RoboSAX/cad_spielfeld/2018/Spielfeld/Bauanleitungen/Elektronik/bilder/crimp2.jpg

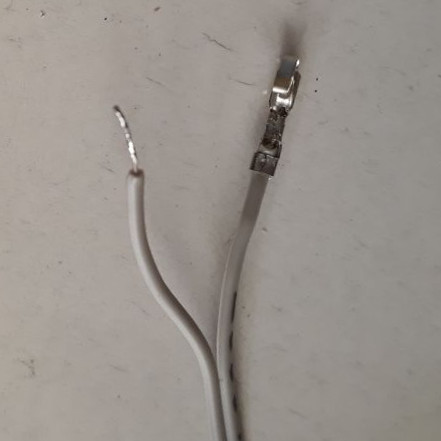
2018/Spielfeld/Bauanleitungen/Elektronik/bilder/crimp2.jpg
