RoboSAX/cad_spielfeld/2019/Allgemeines/Spielfeld_Uebersicht.pdf

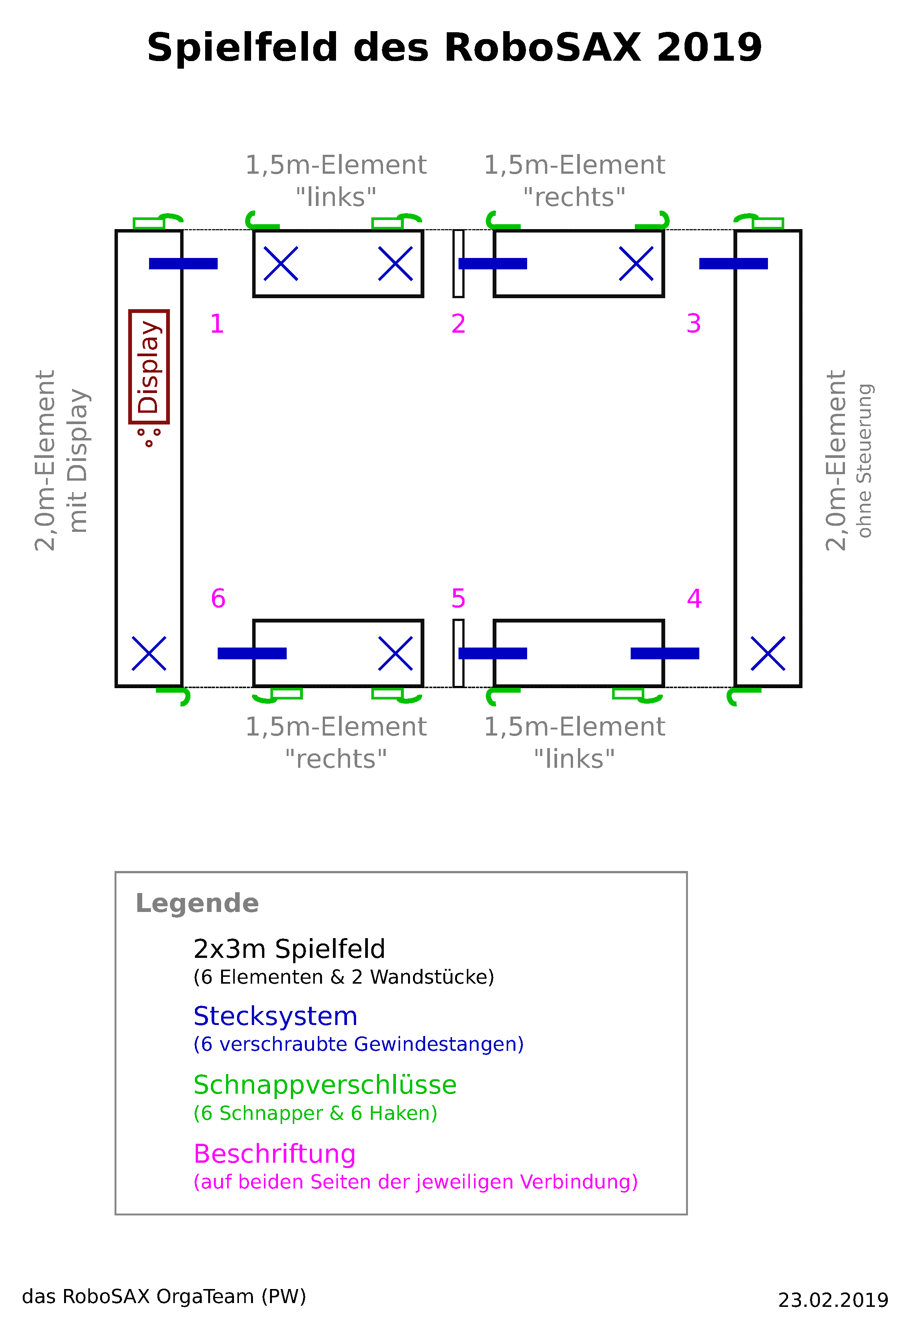
[picture p17: page 1]
