RoboSAX/cad_spielfeld/2018/Spielfeld/Bestellungen_unvollstaendig/data/Reichelt.pdf

## Bestellung für den Spielfeldbau

~ Reichelt ~

RoboSAX 2018 | Seite 1 von 1 | 24.05.2018
Bezeichnung | Artikelnr. | Menge Preis | Summe
| | 2 | 1,75 € | 3,50 €
| | 1 | 3,70 € | 3,70 €
| | 1 | 4,40 € | 4,40 €
Stecker (SpeakOn, 2-polig) | | 11 | 3,40 € | 37,40 €
| | 12 | 2,99 € | 35,88 €
Netzteil (5V, 6A) | 1 19,60 € | 19,60 €
Zwillingslitze (2-adrig, 1,5mm², 10m) | | 1 | 5,55 € | 5,55 €
Kabel (3-adrig, 1,5mm², 5m) | | 1 | 5,55 € | 5,55 €
Stecker (Tamiya, mit Kabel) | | 12 | 1,10 € | 13,20 €
Buchse (Tamiya, mit Kabel) | | 12 | 1,20 € | 14,40 €
Flachbandkabel (10-polig) | | 1 | 4,99 € | 4,99 €
Stecker (DSUB9, für Flachbandkabel) | | 12 | 0,57 € | 6,84 €
Buchse (DSUB9, für Flachbandkabel) | | 12 | 0,57 € | 6,84 €
Stecker (Wanne, 10-polig) | 24 | Auf Platine
Buchse (Pfosten, 10-polig) | | 12 | 0,10 € | 1,20 €

Weitere zum Verbinden der Platinen
Stecker (Crimp, 2-polig) | 26 | Auf Platine
Stecker (Crimp, 3-polig) | 24 | Auf Platine
Buchse (Crimp, 2-polig) | | 26 | 0,01 € | 0,26 €
Buchse (Crimp, 3-polig) | | 24 | 0,03 € | 0,72 €
Stifte (20x Crimp) | | 6 | 0,30 € | 1,80 €
Taster (rot, 24V) | | 26 | 0,47 € | 12,22 €
IR-LED (5mm, 22°) | | 24 | 0,26 € | 6,24 €
| | 1 | 0,25 € | 0,25 €
| | 1 | 0,32 € | 0,32 €
| | 1 | 0,26 € | 0,26 €
| | 1 | 0,46 € | 0,46 €
| | 1 | 0,50 € | 0,50 €
Versandkosten | - | 1 | 5,60 € | 5,60 €

Summe 191,68 €
Nicht enthalten sind die einzelnen Platinen und deren Bauteile.
Blechschrauben (100x, 16mm, d 2,9mm) | SBL 2916-100 (https://www.reichelt.de/Blechschrauben/SBL-2916-100/3/index.html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)
Holzschrauben (200x, 40mm, d 4,0 mm) | R2FV 4,0X40-200 (https://www.reichelt.de/Flach-Senkkopf-Kreuzschlitz-DIN9200-9210-/R2FV-4-0X40-200/3/index.html?ACTION=3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)
Holzschrauben (200x, 50mm, d 4,0 mm) | R2FV 4,0X50-200 (https://www.reichelt.de/Flach-Senkkopf-Kreuzschlitz-DIN9200-9210-/R2FV-4-0X50-200/3/index.html?ACTION=3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)
| NEUTRIK NL-2FX (https://www.reichelt.de/Lautsprecher-Steckverbinder/NEUTRIK-NL-2FX/3/index.html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)
Buchse (SpeakOn, 4-polig, Einbau, groß) | NEUTRIK NL-4MPR (https://www.reichelt.de/Lautsprecher-Steckverbinder/NEUTRIK-NL-4MPR/3/index.html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)
| MW GS60A05 (https://www.reichelt.de/Netzteile-Festspannung/MW-GS60A05/3/index.html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)
| LA 215-10 (https://www.reichelt.de/Lautsprecherkabel/LA-215-10/3/index.html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)
| H05VV F3G1,5 5M (https://www.reichelt.de/Kunststoff-Schlauchleitung/H05VV-F3G1-5-5M/3/index.html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)
| TAM-ST (https://www.reichelt.de/Zubehoer-fuer-Akkupacks/TAM-ST/3/index.html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)
| TAM-BU (https://www.reichelt.de/Zubehoer-fuer-Akkupacks/TAM-BU/3/index.html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)
| AWG 28-10G 10M (https://www.reichelt.de/Flachbandkabel/AWG-28-10G-10M/3/index.html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)
| D-SUB ST 09FB (https://www.reichelt.de/SUB-D-Flachbandverbinder/D-SUB-ST-09FB/3/index.html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)
| D-SUB BU 09FB (https://www.reichelt.de/SUB-D-Flachbandverbinder/D-SUB-BU-09FB/3/index.html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)
| WSL 10G (https://www.reichelt.de/Pfosten-Wannenstecker/WSL-10G/3/index.html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)
| PFL 10 (https://www.reichelt.de/Pfosten-Wannenstecker/PFL-10/3/index.html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)
| PSS 254/2G (https://www.reichelt.de/Platinen-Steckverbinder/PSS-254-2G/3/index.html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)
| PSS 254/3G (https://www.reichelt.de/Platinen-Steckverbinder/PSS-254-3G/3/index.html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)
| PSK 254/2W (https://www.reichelt.de/Platinen-Steckverbinder/PSK-254-2W/3/index.html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)
| PSK 254/3W (https://www.reichelt.de/Platinen-Steckverbinder/PSK-254-3W/3/index.html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)
| PSK-KONTAKTE (https://www.reichelt.de/Platinen-Steckverbinder/PSK-KONTAKTE/3/index.html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)
| T 113A RT (https://www.reichelt.de/Drucktaster-Druckschalter/T-113A-RT/3/index.html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)
| CQY 99 (https://www.reichelt.de/Fotodioden-etc-/CQY-99/3/index.html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)

Schrumpfschläuche
(verschiedene Größen)
| SDH 1,6 SW (https://www.reichelt.de/Schrumpfschlauch-Abschnitte/SDH-1-6-SW/3/index.html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)
| SDH 1,6 RT (https://www.reichelt.de/Schrumpfschlauch-Abschnitte/SDH-1-6-SW/3/index.html?ACTION=3;ARTICLE=17393)
| SDH 3,2 SW (https://www.reichelt.de/?ACTION=3;ARTICLE=17406)
| SDH 6,4 SW (https://www.reichelt.de/Schrumpfschlauch-Abschnitte/SDH-6-4-SW/3/index.html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)
| SDH 6,4 RT (https://www.reichelt.de/?ACTION=3;ARTICLE=17413)
