RoboSAX/cad_spielfeld/2014/Beschreibung/Bilder/Spielfeld.jpg

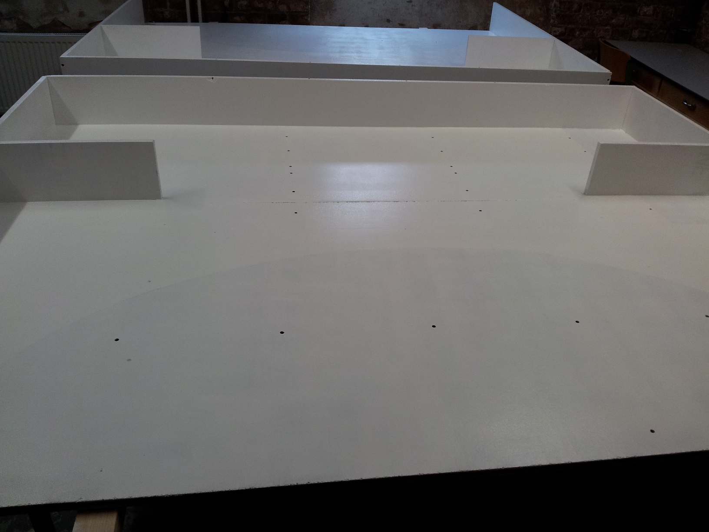
2014/Beschreibung/Bilder/Spielfeld.jpg
