RoboSAX/cad_spielfeld/2014/Beschreibung/Bilder/Spielfeld_Neu.png

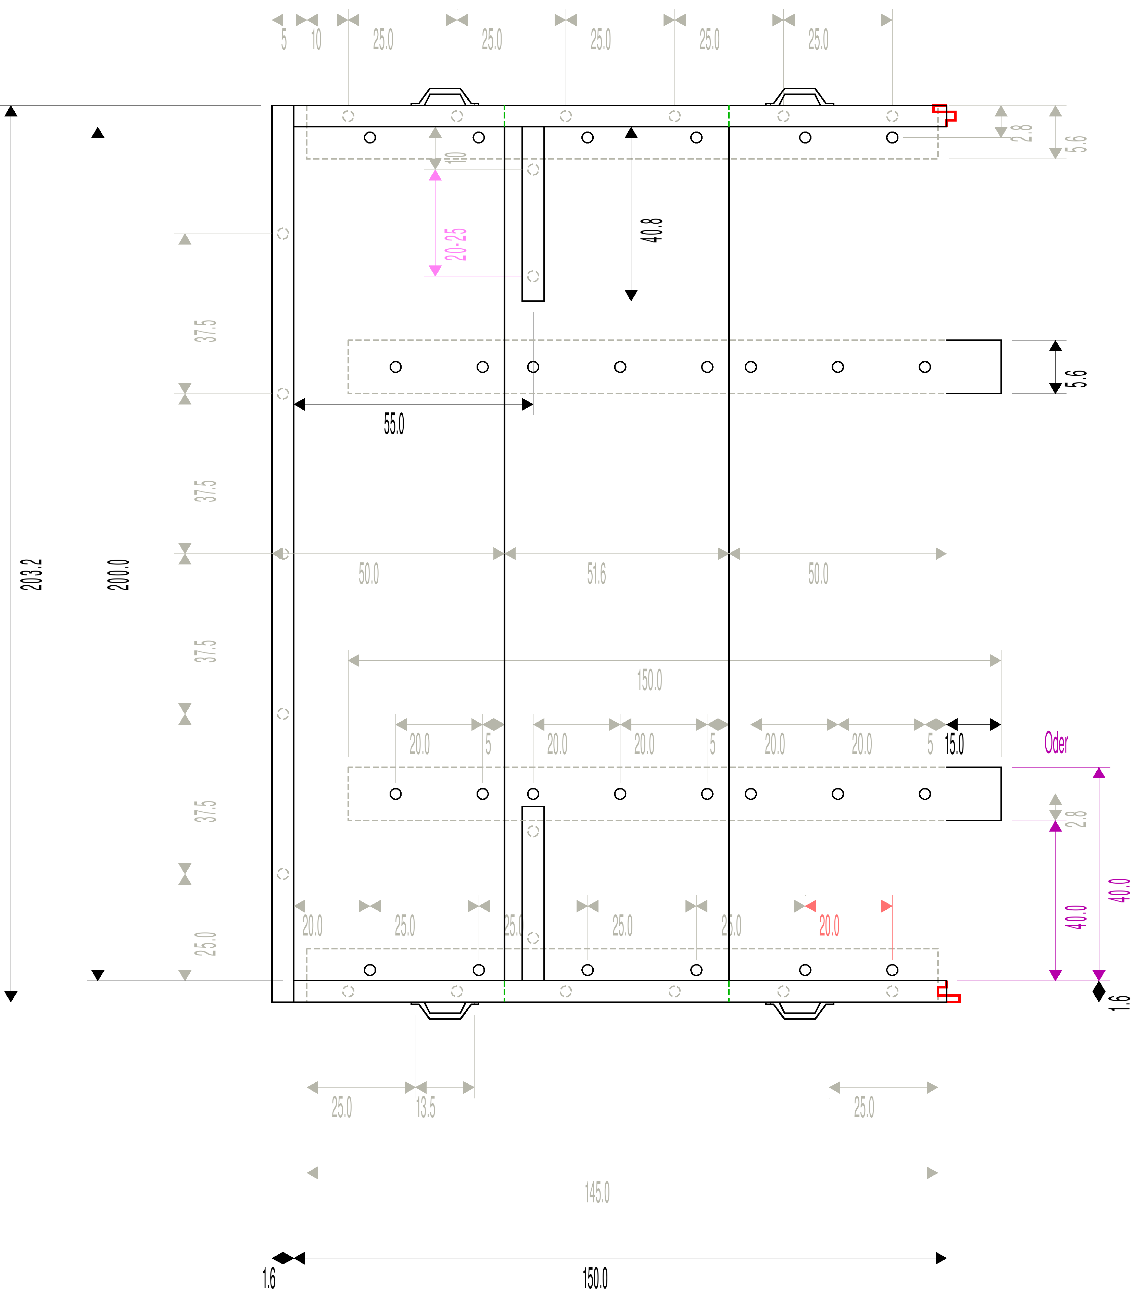
2014/Beschreibung/Bilder/Spielfeld_Neu.png
