RoboSAX/cad_spielfeld/2019/Programmieranschluss/Bilder/netzwerkanschluss_seite.jpg

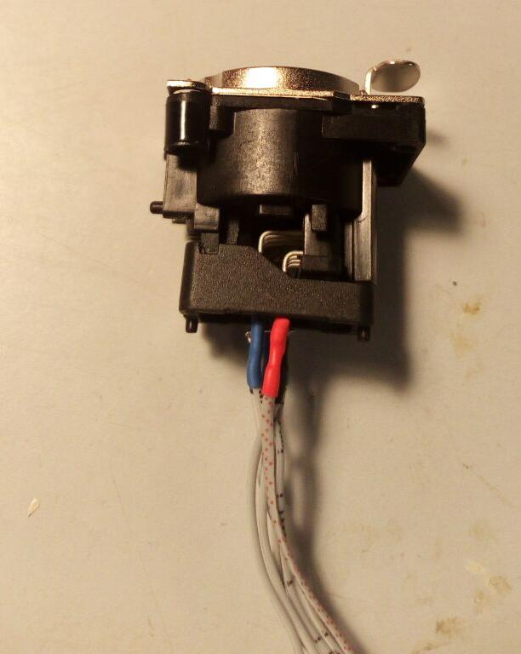
2019/Programmieranschluss/Bilder/netzwerkanschluss_seite.jpg
