RoboSAX/cad_spielfeld/2019/Programmieranschluss/Bilder/netzwerkanschluss_unten.jpg

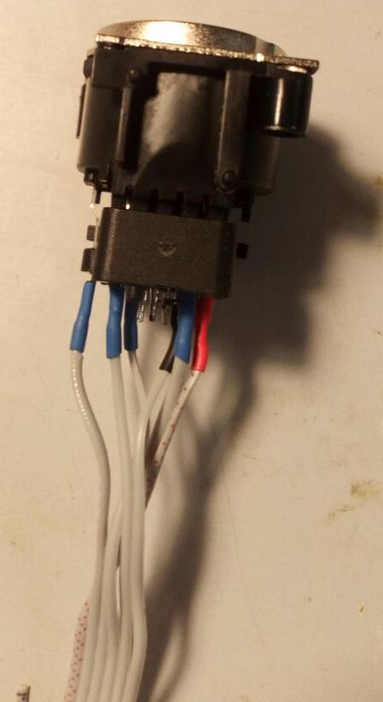
2019/Programmieranschluss/Bilder/netzwerkanschluss_unten.jpg
