RoboSAX/cad_spielfeld/2019/Programmieranschluss/Zeichnungen/data/export/anschluss_programmer.stp

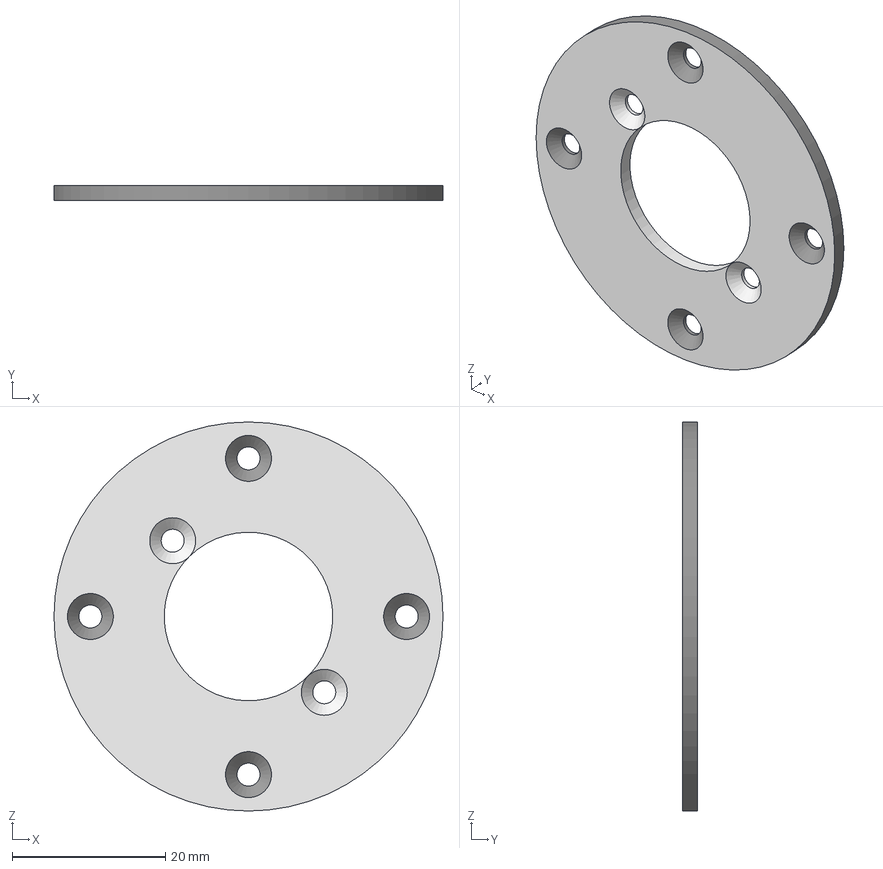
[picture p22: CAD file, 2019-02-23]
2019/Programmieranschluss/Zeichnungen/data/export/anschluss_programmer.stp
50.8 x 2.00 x 50.8 mm
