RoboSAX/cad_spielfeld/2020/Tasteranschluss/Zeichnungen/data/export/anschluss_taster.stp

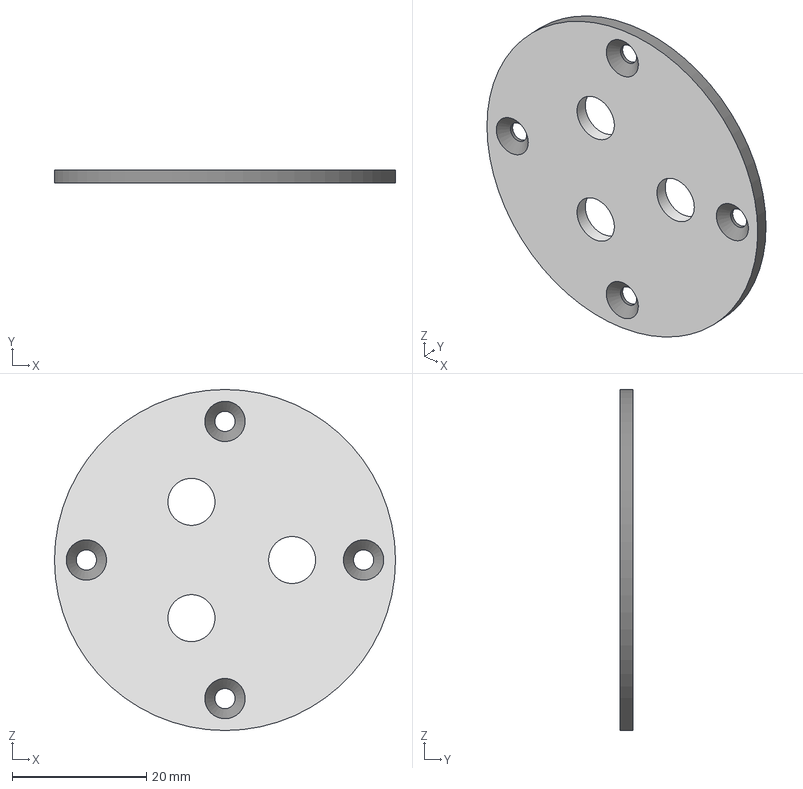
[picture p23: CAD file, 2019-11-26]
2020/Tasteranschluss/Zeichnungen/data/export/anschluss_taster.stp
50.8 x 2.00 x 50.8 mm
