RoboSAX/cad_spielfeld/(list of files, cad)

Other CAD files:
2018/Teamprobe/Zeichnung/Anschluss_Daten.dwg
2018/Teamprobe/Zeichnung/Licht_Teamprobe.dwg
2018/Spielfeld/Zeichnungen/AutoCADD/Steckwand.idw
2018/Spielfeld/Zeichnungen/AutoCADD/Steckwand.ipt
2018/Spielfeld/Zeichnungen/AutoCADD/anschluss_daten.iam
2018/Spielfeld/Zeichnungen/AutoCADD/anschluss_daten.idw
2018/Spielfeld/Zeichnungen/AutoCADD/anschluss_daten.ipt
2018/Spielfeld/Zeichnungen/AutoCADD/anschluss_daten_1.idw
2018/Spielfeld/Zeichnungen/AutoCADD/anschluss_daten_1.ipt
2018/Spielfeld/Zeichnungen/AutoCADD/anschluss_daten_1_MIR.ipt
2018/Spielfeld/Zeichnungen/AutoCADD/anschluss_daten_2.ipt
2018/Spielfeld/Zeichnungen/AutoCADD/anschluss_daten_2_MIR.ipt
2018/Spielfeld/Zeichnungen/AutoCADD/anschluss_daten_MIR.iam
2018/Spielfeld/Zeichnungen/AutoCADD/anschluss_strom.ipt
2018/Spielfeld/Zeichnungen/AutoCADD/anschluss_strom_MIR.ipt
2018/Spielfeld/Zeichnungen/AutoCADD/licht_150.iam
2018/Spielfeld/Zeichnungen/AutoCADD/licht_150.idw
2018/Spielfeld/Zeichnungen/AutoCADD/licht_150_MIR.iam
2018/Spielfeld/Zeichnungen/AutoCADD/licht_150_back.idw
2018/Spielfeld/Zeichnungen/AutoCADD/licht_150_back.ipt
2018/Spielfeld/Zeichnungen/AutoCADD/licht_150_back_MIR.ipt
2018/Spielfeld/Zeichnungen/AutoCADD/licht_150_front.idw
2018/Spielfeld/Zeichnungen/AutoCADD/licht_150_front.ipt
2018/Spielfeld/Zeichnungen/AutoCADD/licht_150_front_MIR.ipt
2018/Spielfeld/Zeichnungen/AutoCADD/licht_150_side_left.idw
2018/Spielfeld/Zeichnungen/AutoCADD/licht_150_side_left.ipt
2018/Spielfeld/Zeichnungen/AutoCADD/licht_150_side_left_MIR.ipt
2018/Spielfeld/Zeichnungen/AutoCADD/licht_150_side_middle.idw
2018/Spielfeld/Zeichnungen/AutoCADD/licht_150_side_middle.ipt
2018/Spielfeld/Zeichnungen/AutoCADD/licht_150_side_middle_MIR.ipt
2018/Spielfeld/Zeichnungen/AutoCADD/licht_150_side_right.idw
2018/Spielfeld/Zeichnungen/AutoCADD/licht_150_side_right.ipt
2018/Spielfeld/Zeichnungen/AutoCADD/licht_150_side_right_MIR.ipt
2018/Spielfeld/Zeichnungen/AutoCADD/licht_150_support_left.idw
2018/Spielfeld/Zeichnungen/AutoCADD/licht_150_support_left.ipt
2018/Spielfeld/Zeichnungen/AutoCADD/licht_150_support_left_MIR.ipt
2018/Spielfeld/Zeichnungen/AutoCADD/licht_150_support_right.idw
2018/Spielfeld/Zeichnungen/AutoCADD/licht_150_support_right.ipt
2018/Spielfeld/Zeichnungen/AutoCADD/licht_150_support_right_MIR.ipt
2018/Spielfeld/Zeichnungen/AutoCADD/licht_150_top.idw
2018/Spielfeld/Zeichnungen/AutoCADD/licht_150_top.ipt
2018/Spielfeld/Zeichnungen/AutoCADD/licht_150_top_MIR.ipt
2018/Spielfeld/Zeichnungen/AutoCADD/licht_200.iam
2018/Spielfeld/Zeichnungen/AutoCADD/licht_200.idw
2018/Spielfeld/Zeichnungen/AutoCADD/licht_200_back.idw
2018/Spielfeld/Zeichnungen/AutoCADD/licht_200_back.ipt
2018/Spielfeld/Zeichnungen/AutoCADD/licht_200_front.idw
2018/Spielfeld/Zeichnungen/AutoCADD/licht_200_front.ipt
2018/Spielfeld/Zeichnungen/AutoCADD/licht_200_side_left.idw
2018/Spielfeld/Zeichnungen/AutoCADD/licht_200_side_left.ipt
2018/Spielfeld/Zeichnungen/AutoCADD/licht_200_side_middle.idw
2018/Spielfeld/Zeichnungen/AutoCADD/licht_200_side_middle.ipt
2018/Spielfeld/Zeichnungen/AutoCADD/licht_200_side_right.idw
2018/Spielfeld/Zeichnungen/AutoCADD/licht_200_side_right.ipt
2018/Spielfeld/Zeichnungen/AutoCADD/licht_200_support.idw
2018/Spielfeld/Zeichnungen/AutoCADD/licht_200_support.ipt
2018/Spielfeld/Zeichnungen/AutoCADD/licht_200_top_teil_a.idw
2018/Spielfeld/Zeichnungen/AutoCADD/licht_200_top_teil_a.ipt
2018/Spielfeld/Zeichnungen/AutoCADD/licht_200_top_teil_b.idw
2018/Spielfeld/Zeichnungen/AutoCADD/licht_200_top_teil_b.ipt
2018/Spielfeld/Zeichnungen/AutoCADD/licht_led_blau.ipt
2018/Spielfeld/Zeichnungen/AutoCADD/licht_led_blau_MIR.ipt
2018/Spielfeld/Zeichnungen/AutoCADD/licht_led_gelb.ipt
2018/Spielfeld/Zeichnungen/AutoCADD/licht_led_gruen.ipt
2018/Spielfeld/Zeichnungen/AutoCADD/licht_taster.ipt
2018/Spielfeld/Zeichnungen/AutoCADD/licht_taster_MIR.ipt
2018/Spielfeld/Zeichnungen/AutoCADD/spielfeld_gesamt.iam
2018/Spielfeld/Zeichnungen/AutoCADD/spielfeld_gesamt.idw
2018/Spielfeld/Zeichnungen/AutoCADD/spielfeld_trennwand.idw
2018/Spielfeld/Zeichnungen/AutoCADD/spielfeld_trennwand.ipt
2018/Teamprobe/Zeichnung/licht_50.iam
2018/Teamprobe/Zeichnung/licht_50_front.ipt
2018/Teamprobe/Zeichnung/licht_50_top.ipt
2018/Teamprobe/Zeichnung/licht_side_simple.ipt
2019/Programmieranschluss/Zeichnungen/data/anschluss_programmer.idw
2019/Programmieranschluss/Zeichnungen/data/anschluss_programmer.ipt
2019/Programmieranschluss/Zeichnungen/data/export/anschluss_programmer.dwg
2020/Tasteranschluss/Zeichnungen/data/anschluss_taster.idw
2020/Tasteranschluss/Zeichnungen/data/anschluss_taster.ipt
2020/Tasteranschluss/Zeichnungen/data/export/anschluss_taster.dwg
