RoboSAX/cad_spielfeld/2018/Spielfeld/Bauanleitungen/Elektronik/data/taster.odt

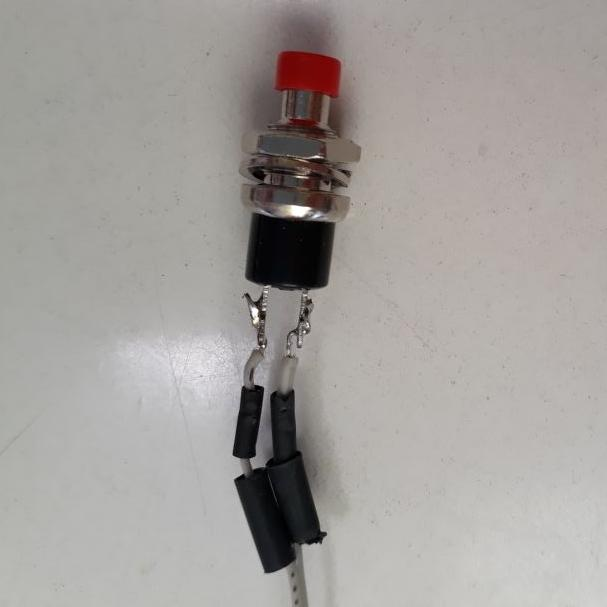
[picture p32: figure]
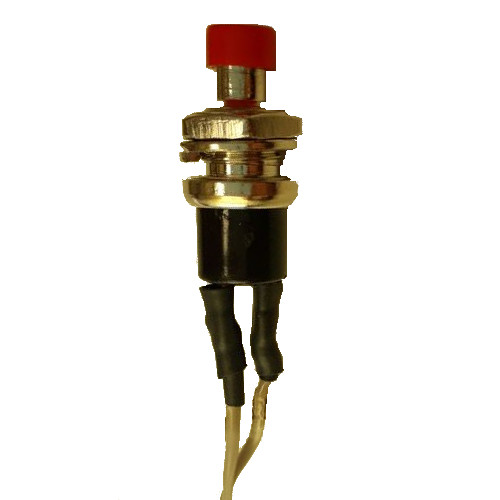
[picture p33: figure]

Als Zuleitung dienen etwa 25cm 2er Flachbandkabel ohne Markierung.

Am beisten je 2 Schrumpfschläuche mit 1,6mm und 3,2 mm Durchmesser nutzen.

Pinbelegung am Kabel und am Crimp-Anschluss ist beliebig.

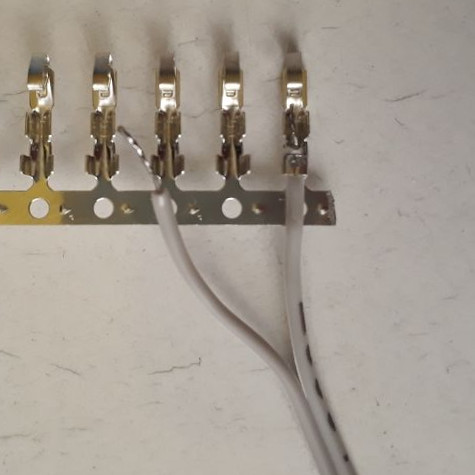
[picture p34: figure]
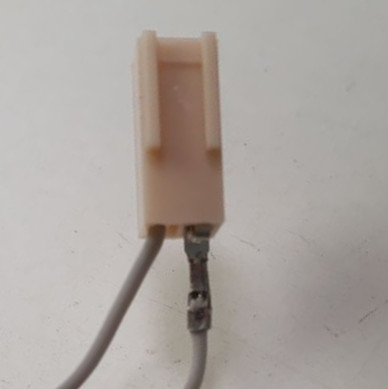
[picture p35: figure]
