RoboSAX/cad_spielfeld/2018/Spielfeld/Bauanleitungen/Elektronik/ir_led.pdf

IR-LED

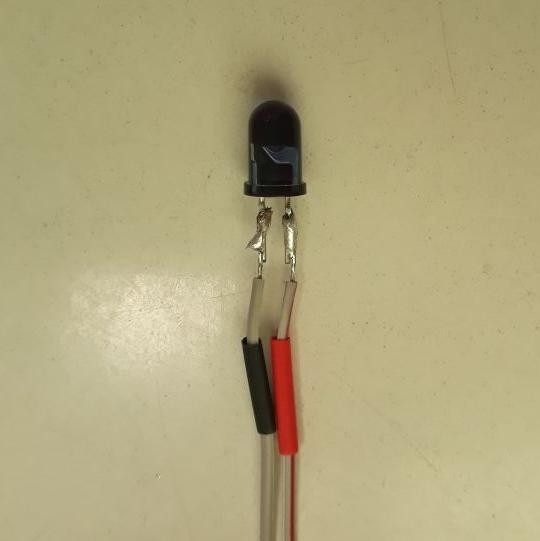
[picture p36: figure]
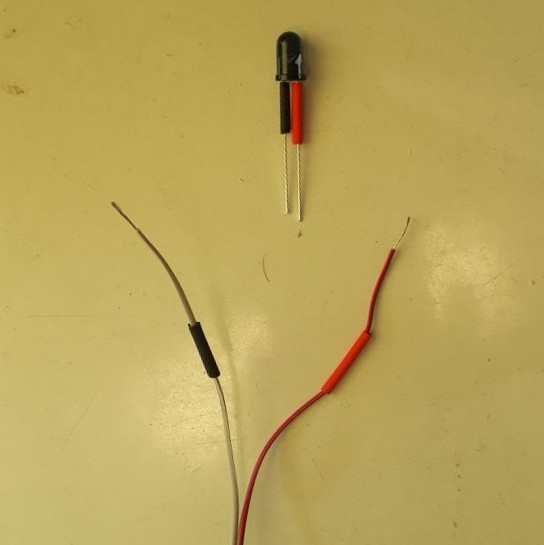
[picture p37: figure]
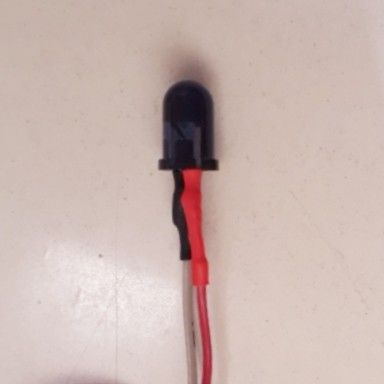
[picture p38: figure]

Als Zuleitung dienen etwa 25cm 2er Flachbandkabel mit einer Markierung für die Anode. Am beisten farbige Schrumpfschläuche mit 1,6mm Durchmesser nutzen.

Led | Kabel | Crimp-Anschluss
Anode | (+; langes Bein) | 1 (rot) | 1 oder 3 (rand)
Kathode (-; kurzes Bein) | 2 (grau) | 2 | (mitte)

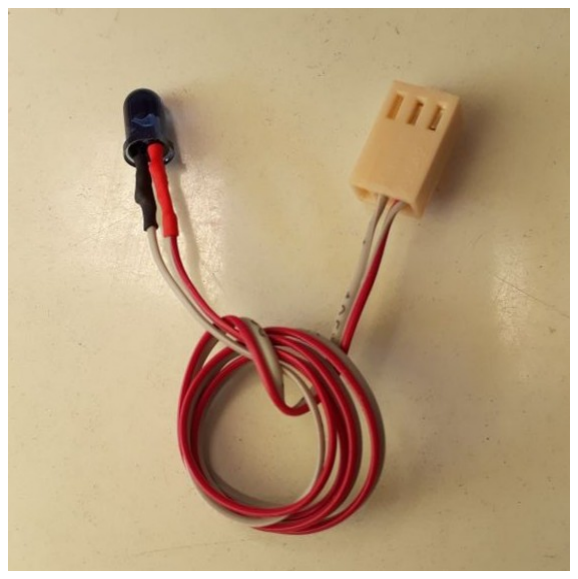
[picture p39: figure]

RoboSAX 2018 | 08.04.18
