RoboSAX/cad_spielfeld/2018/Spielfeld/Bauanleitungen/Elektronik/bilder/speakon_gelötet.jpg

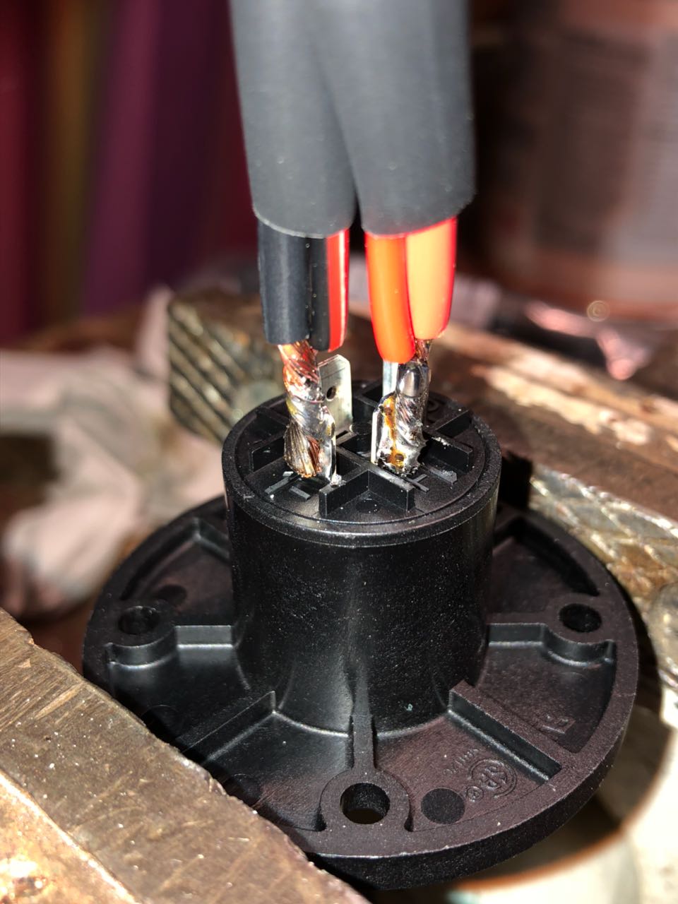
2018/Spielfeld/Bauanleitungen/Elektronik/bilder/speakon_gelötet.jpg
