RoboSAX/cad_spielfeld/2018/Spielfeld/Bauanleitungen/Elektronik/bilder/speakon_geschrumpft.jpg

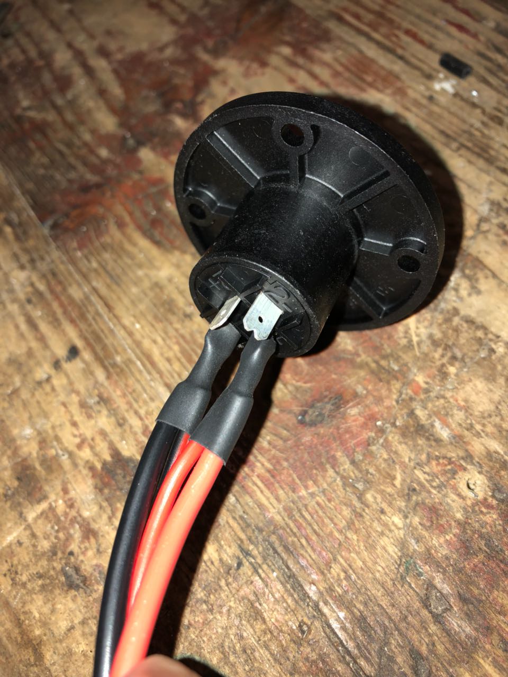
2018/Spielfeld/Bauanleitungen/Elektronik/bilder/speakon_geschrumpft.jpg
