RoboSAX/cad_spielfeld/2018/Spielfeld/Bauanleitungen/Elektronik/bilder/speakon_kabel_2.jpg

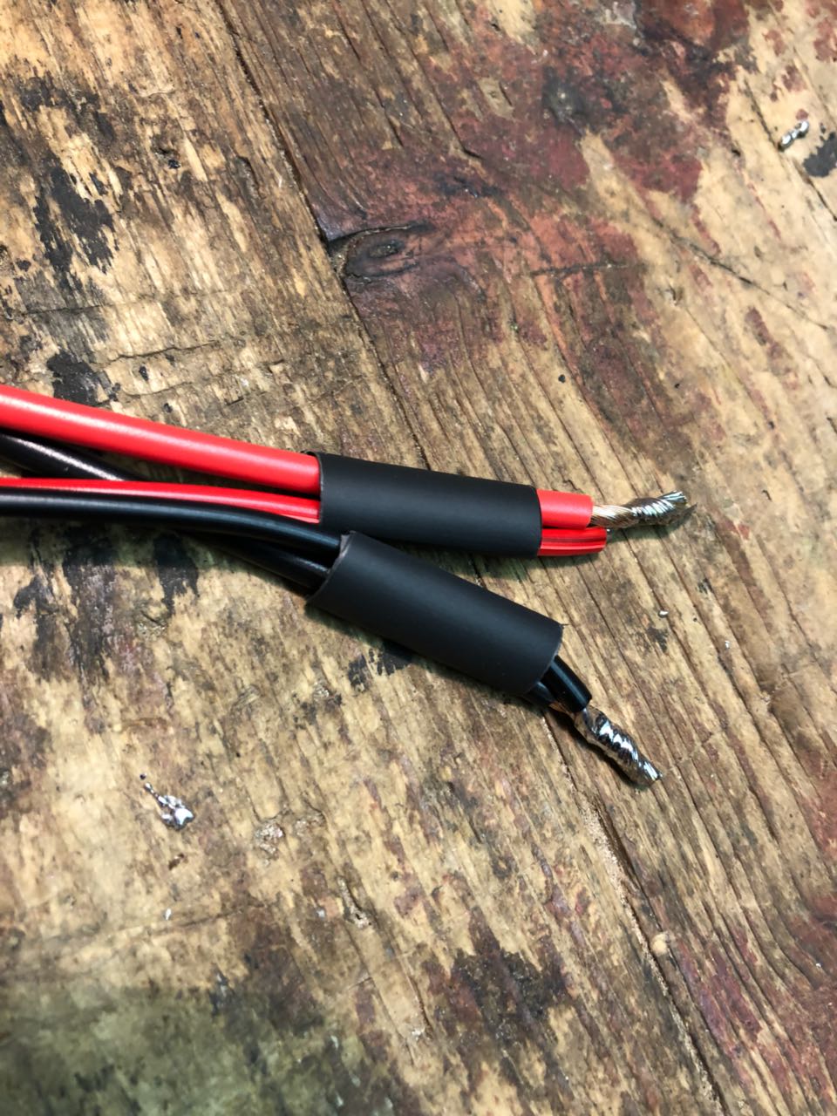
2018/Spielfeld/Bauanleitungen/Elektronik/bilder/speakon_kabel_2.jpg
