RoboSAX/cad_spielfeld/2018/Spielfeld/Bauanleitungen/Elektronik/bilder/speakon_verzinnt.jpg

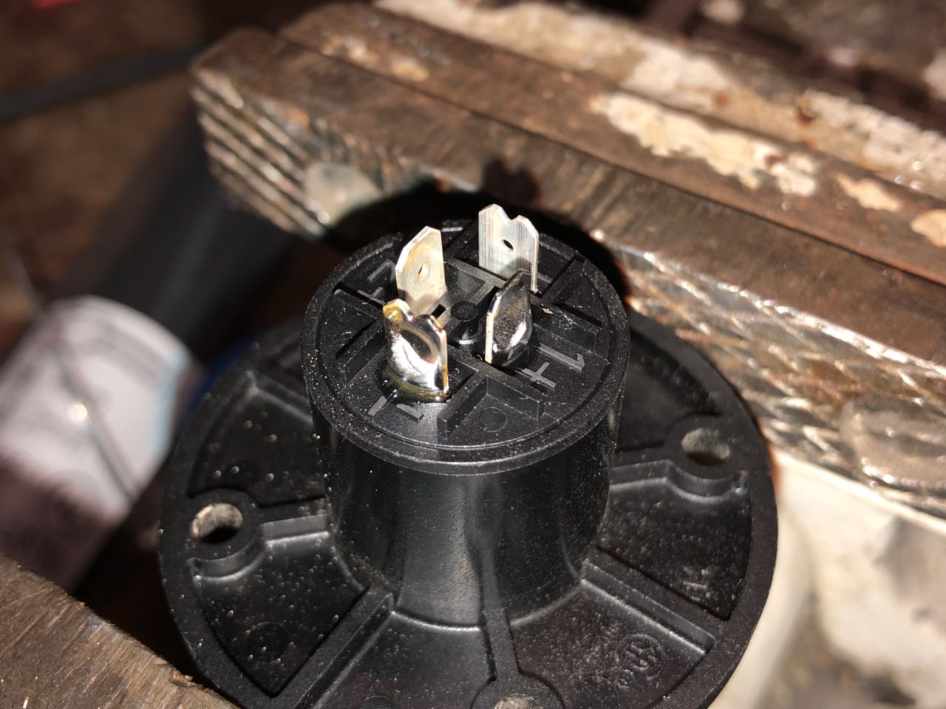
2018/Spielfeld/Bauanleitungen/Elektronik/bilder/speakon_verzinnt.jpg
