RoboSAX/cad_spielfeld/2018/Spielfeld/Bauanleitungen/Hardware/Anschluss_Daten.pdf

# Strke 2mm

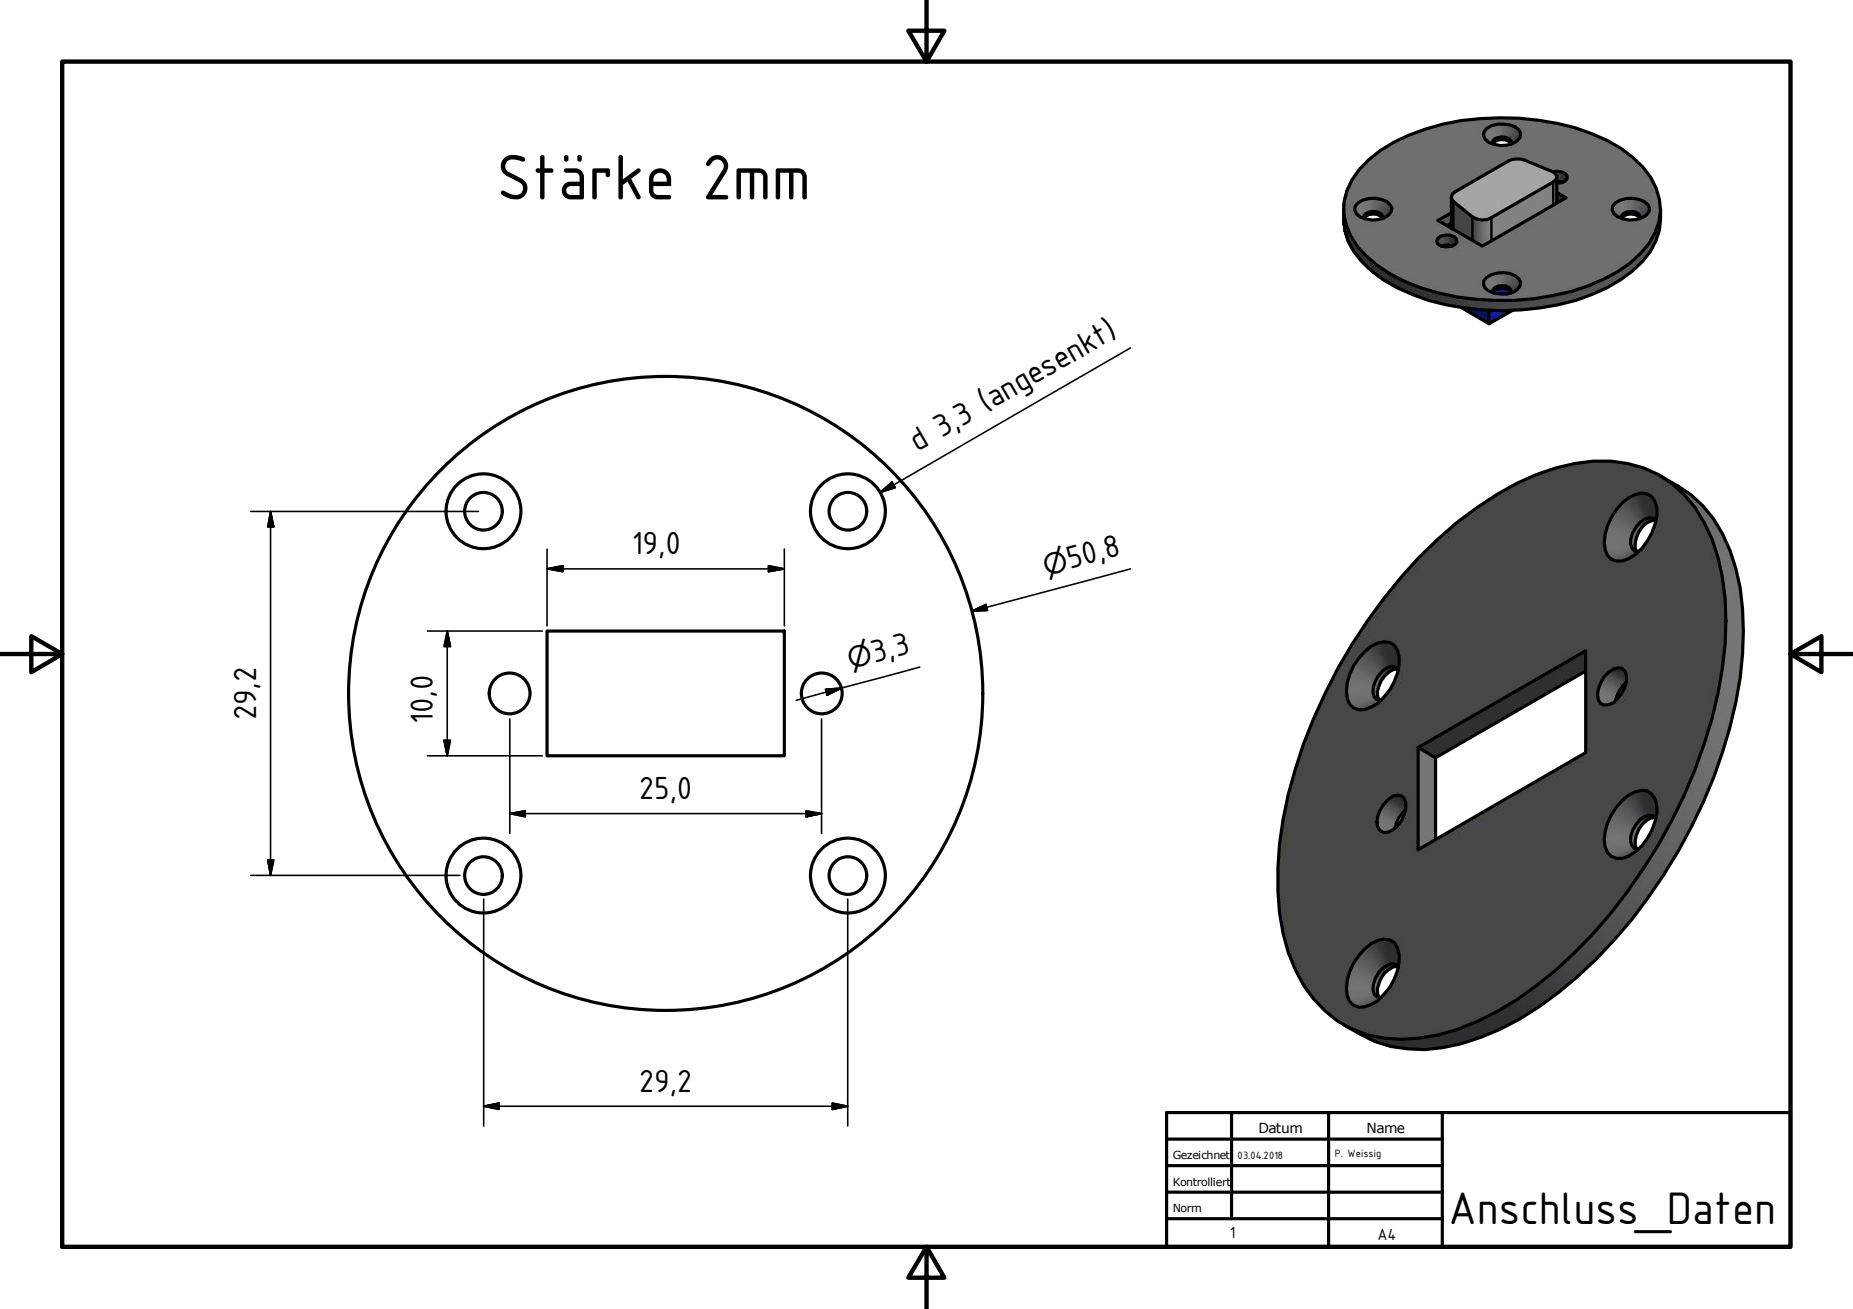
[picture p45: page 1]
d 3,3 (angesenkt)

Datum | Name | Anschluss_Daten

Gezeichnet | 03.04.2018 | P. Weissig

Kontrolliert

Norm
