RoboSAX/cad_spielfeld/2018/Spielfeld/Bauanleitungen/Hardware/Licht_150_links.pdf

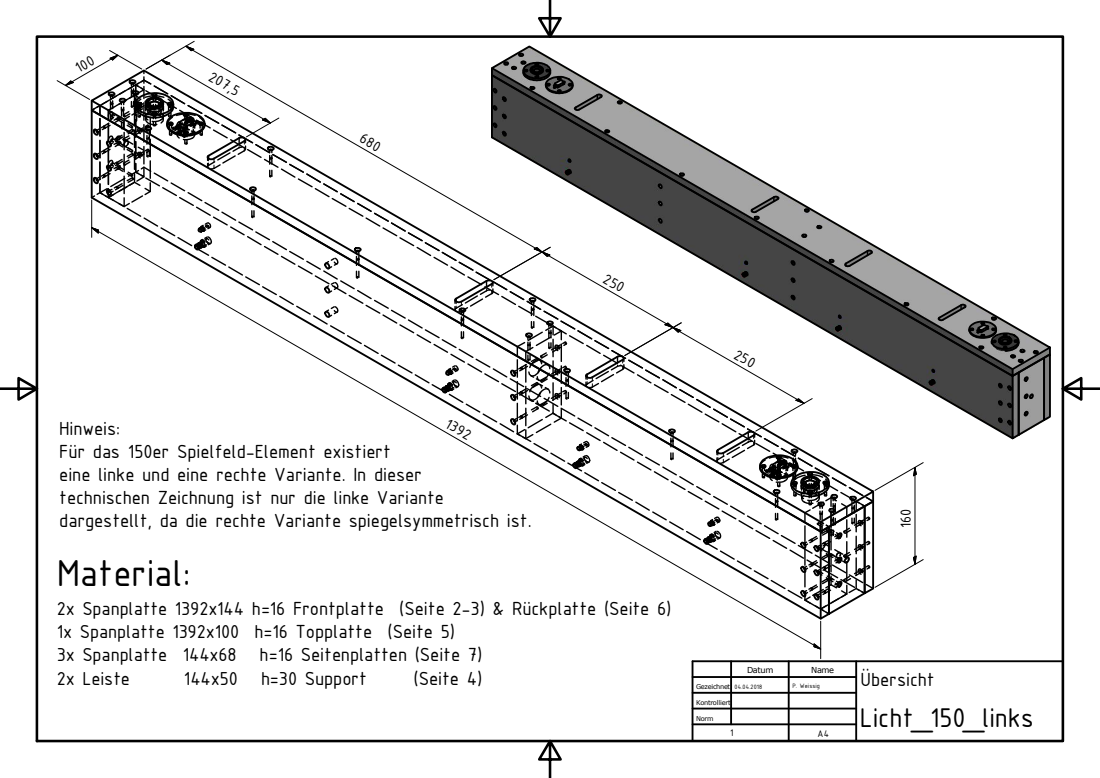
[picture p46: page 1]
3x Spanplatte 144x68; h=16 Seitenplatten (Seite 7); 2x Leiste; h=30 Support; (Seite 4)

Hinweis:
F¯r das 150er Spielfeld-Element existiert
eine linke und eine rechte Variante. In dieser
technischen Zeichnung ist nur die linke Variante
dargestellt, da die rechte Variante spiegelsymmetrisch ist.
Material:

2x Spanplatte 1392x144 h=16 Frontplatte (Seite 2-3) & R¯ckplatte (Seite 6)
1x Spanplatte 1392x100 h=16 Topplatte (Seite 5)

Datum | Name | bersicht Licht_150_links

Gezeichnet | 04.04.2018 | P. Weissig

Kontrolliert

Norm

AF1

# 1x Spanplatte 1392x144 h=16

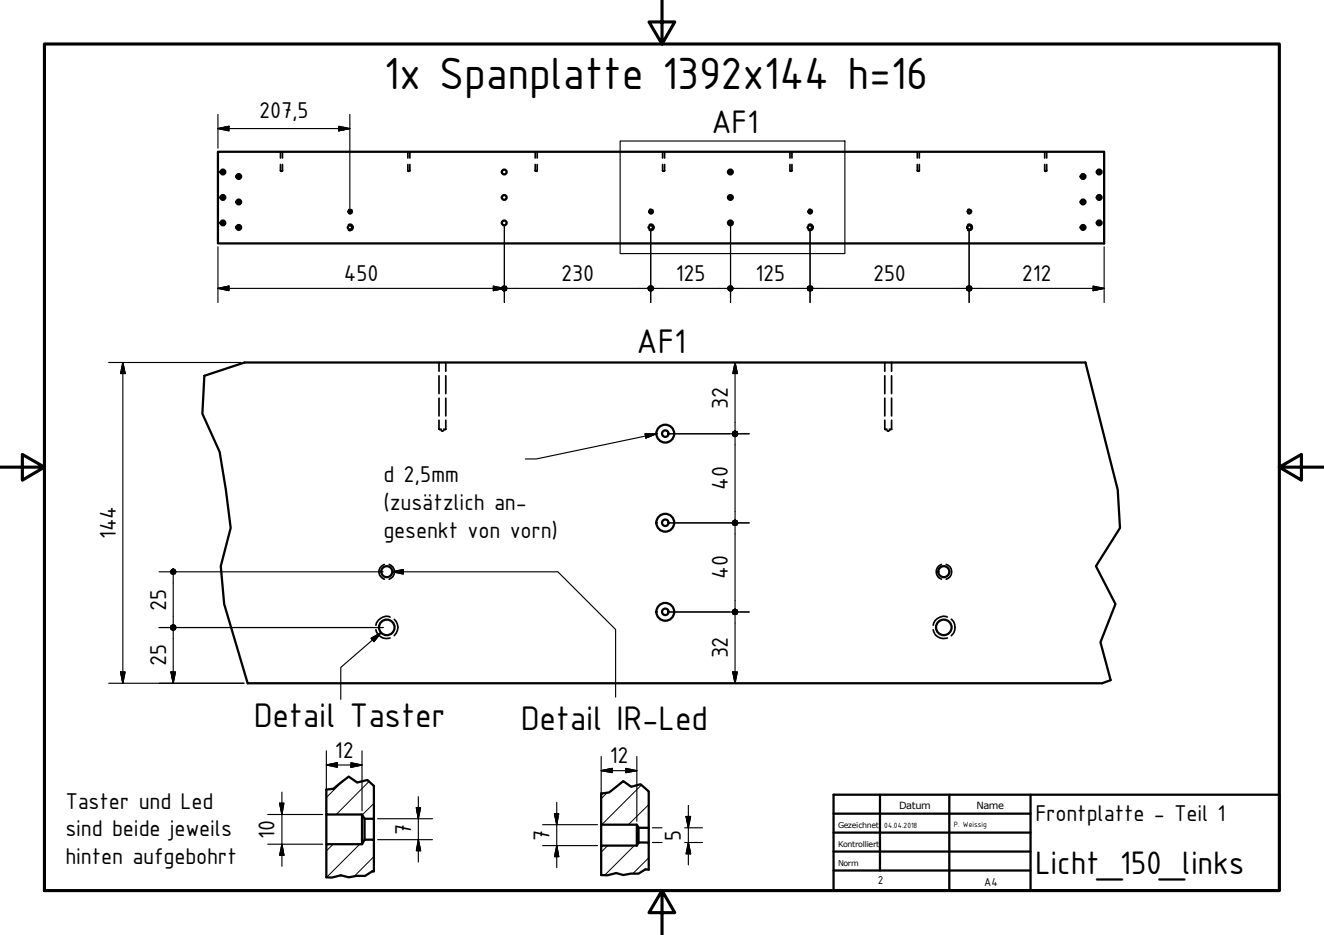
[picture p47: page 2]
Detail Taster; Detail IR-Led

(zustzlich an-
gesenkt von vorn)

Taster und Led
sind beide jeweils
hinten aufgebohrt

Datum | Name | Frontplatte - Teil 1

Gezeichnet | 04.04.2018 | P. Weissig

Kontrolliert

AF2 | AF3

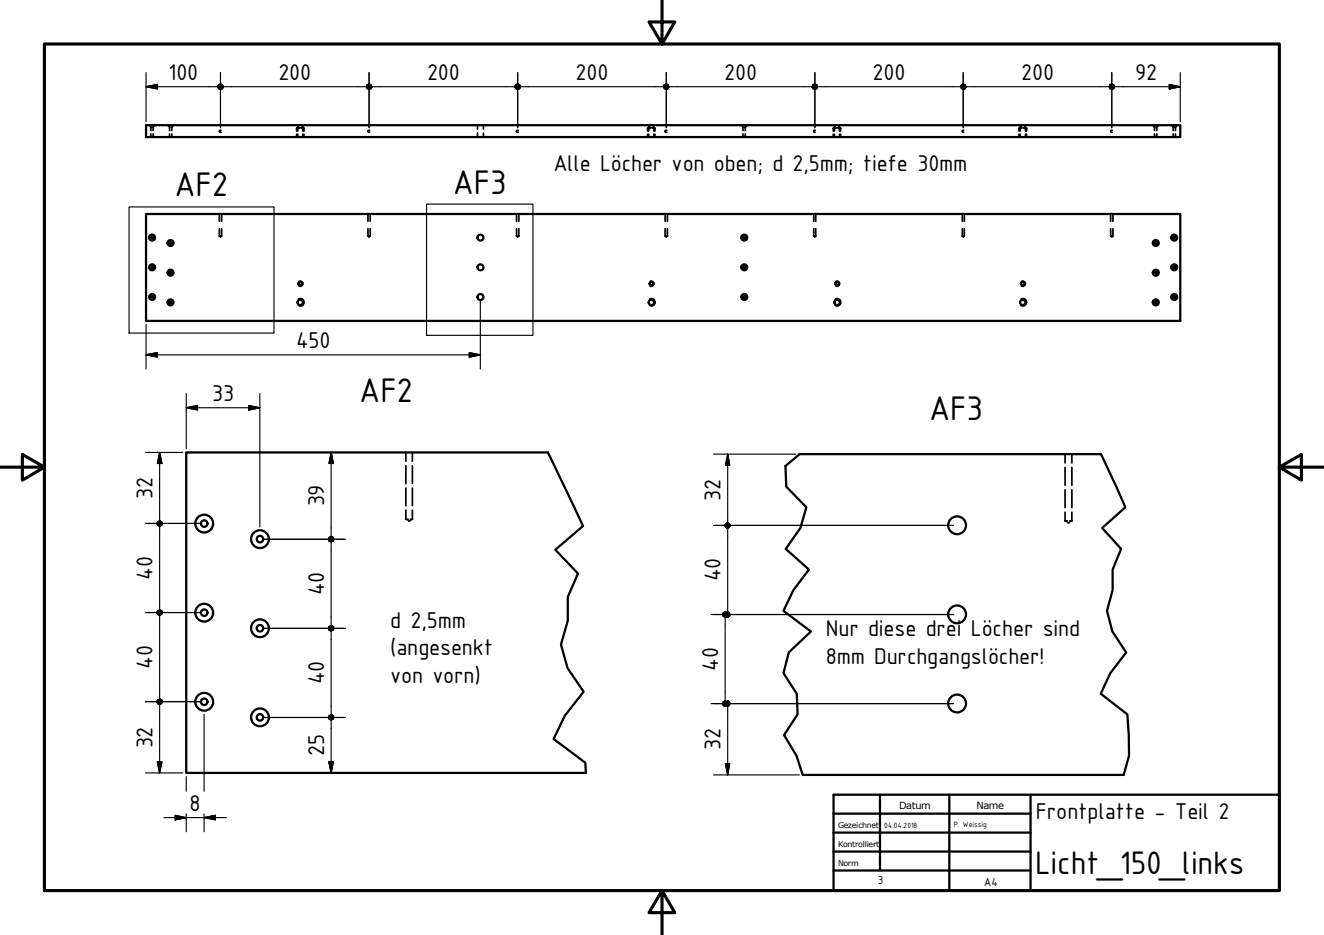
[picture p48: page 3]
d 2,5mm (angesenkt von vorn)

Alle L©cher von oben; d 2,5mm; tiefe 30mm

Nur diese drei L©cher sind
8mm Durchgangsl©cher!

Datum | Name | Frontplatte - Teil 2

Gezeichnet | 04.04.2018 | P. Weissig

Kontrolliert

# 2x Leiste 144x50 h=30

Leiste links | Leiste rechts

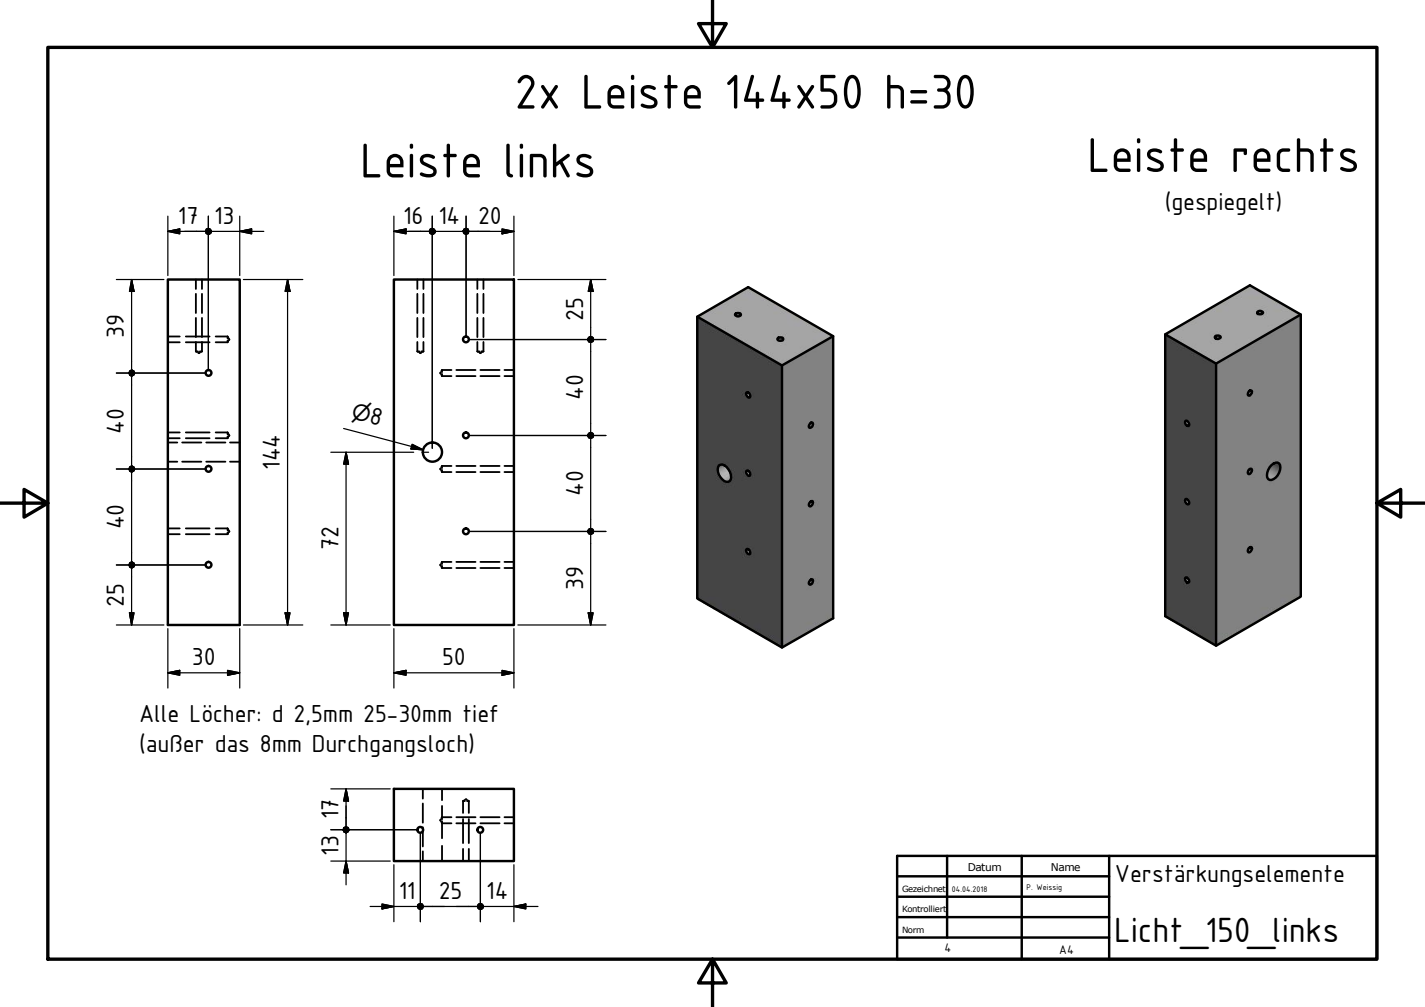
[picture p49: page 4]
(gespiegelt)

Alle L©cher: d 2,5mm 25-30mm tief
(auer das 8mm Durchgangsloch)

Datum | Name | Verstrkungselemente

Gezeichnet | 04.04.2018 | P. Weissig

Kontrolliert

AT1
AT2

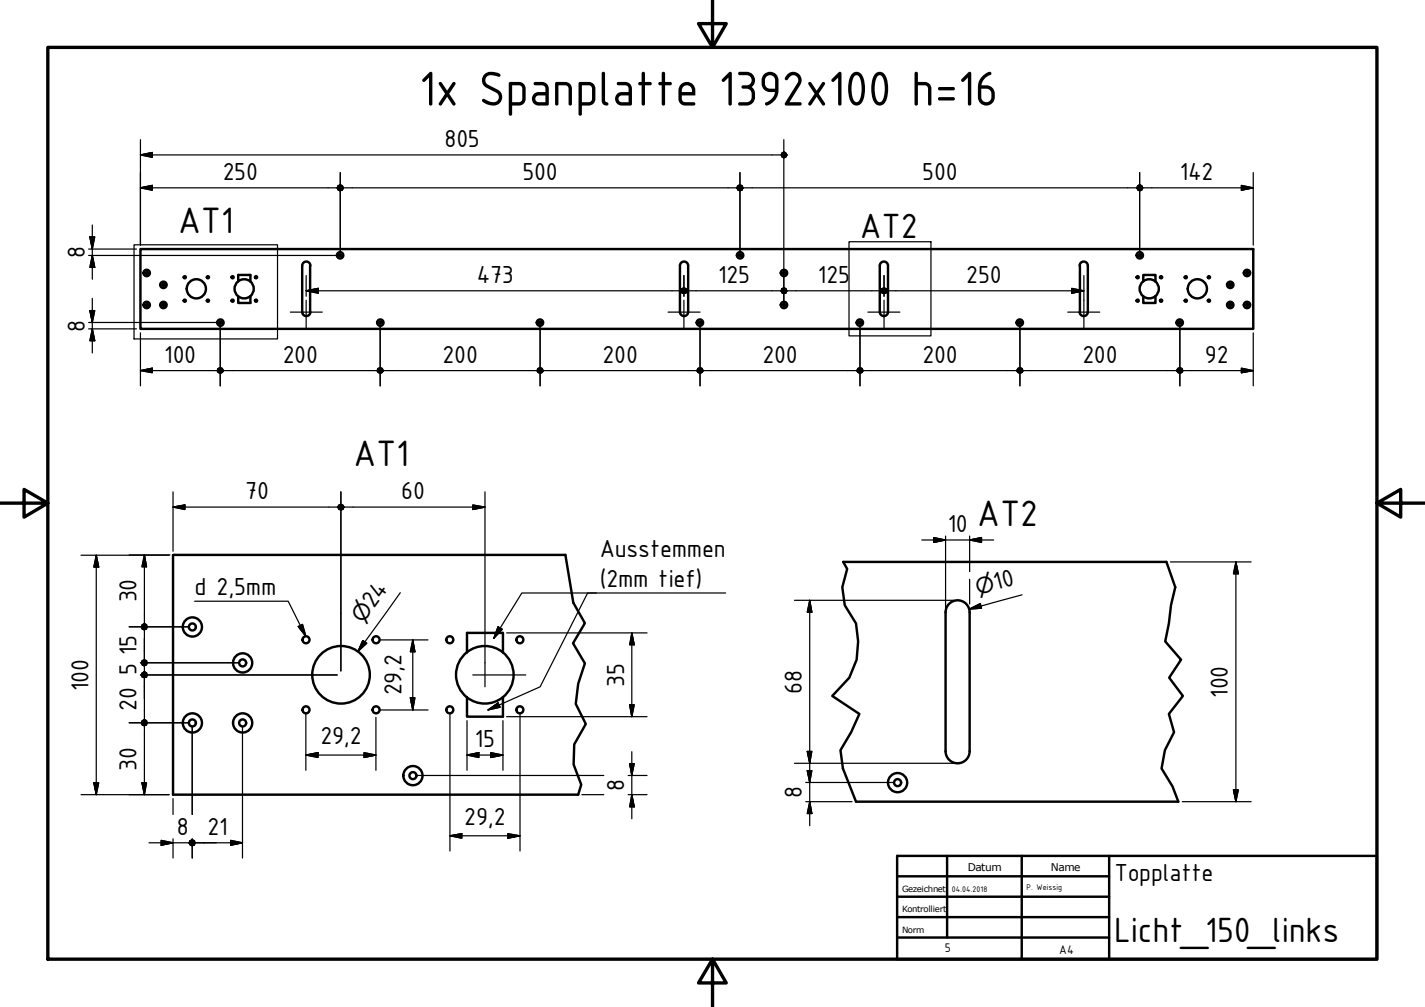
[picture p50: page 5]
1x Spanplatte 1392x100 h=16; Ausstemmen (2mm tief)

Datum | Name | Topplatte

Gezeichnet | 04.04.2018 | P. Weissig

Kontrolliert

# 1x Spanplatte 1392x144 h=16

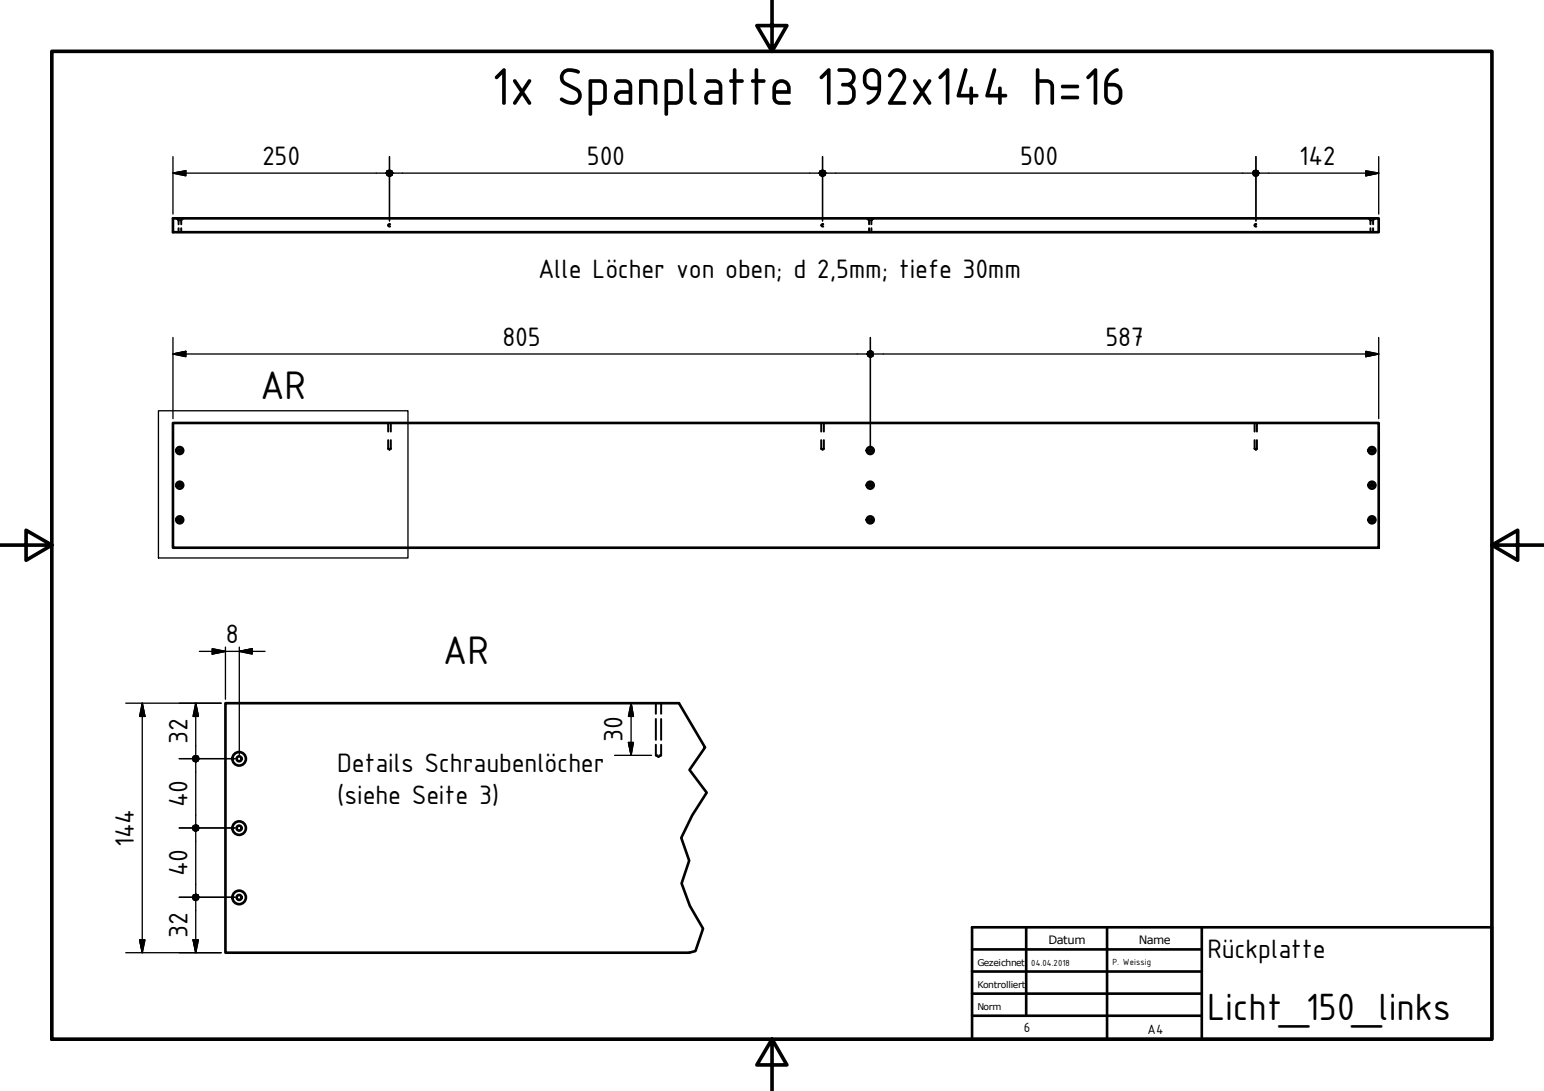
[picture p51: page 6]

Alle L©cher von oben; d 2,5mm; tiefe 30mm

Details Schraubenl©cher
(siehe Seite 3)

Datum | Name | R¯ckplatte

Gezeichnet | 04.04.2018 | P. Weissig

Kontrolliert

# 3x Spanplatte 144x68 h=16

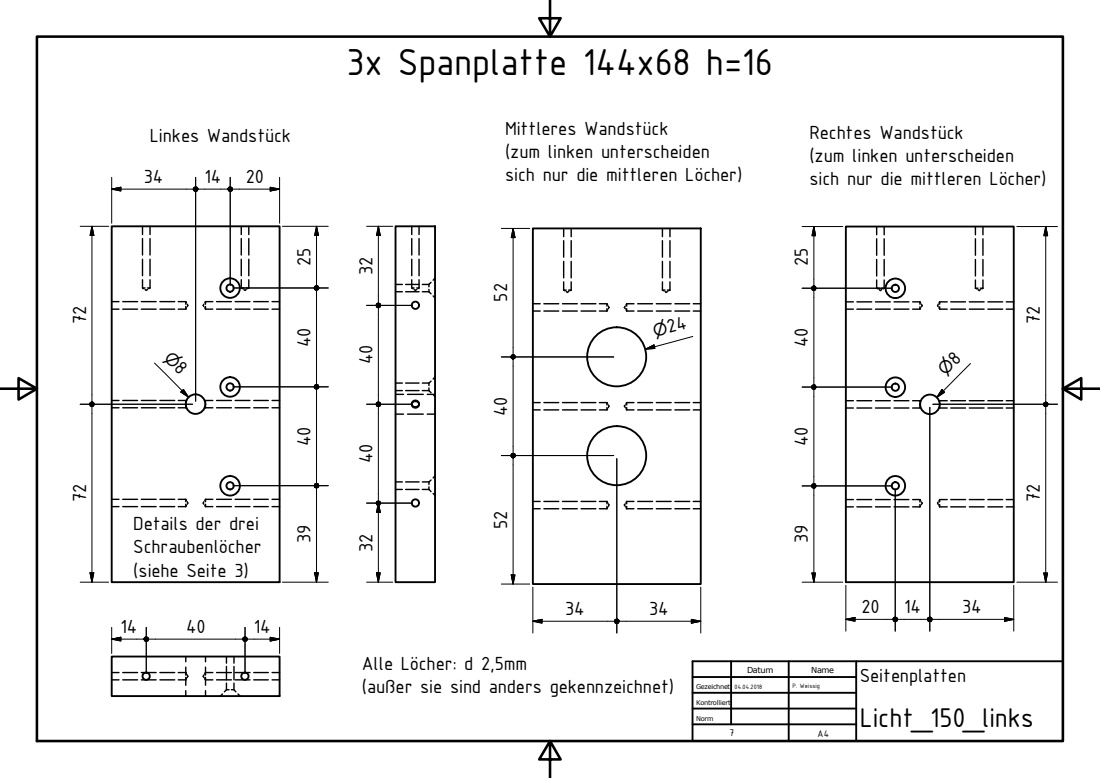
[picture p52: page 7]

Linkes Wandst¯ck

Mittleres Wandst¯ck
(zum linken unterscheiden
sich nur die mittleren L©cher)

Rechtes Wandst¯ck

Details der drei
Schraubenl©cher
(siehe Seite 3)

Alle L©cher: d 2,5mm
(auer sie sind anders gekennzeichnet)

Datum | Name | Seitenplatten

Gezeichnet | 04.04.2018 | P. Weissig

Kontrolliert
