RoboSAX/cad_spielfeld/2018/Spielfeld/Bauanleitungen/Hardware/Licht_200.pdf

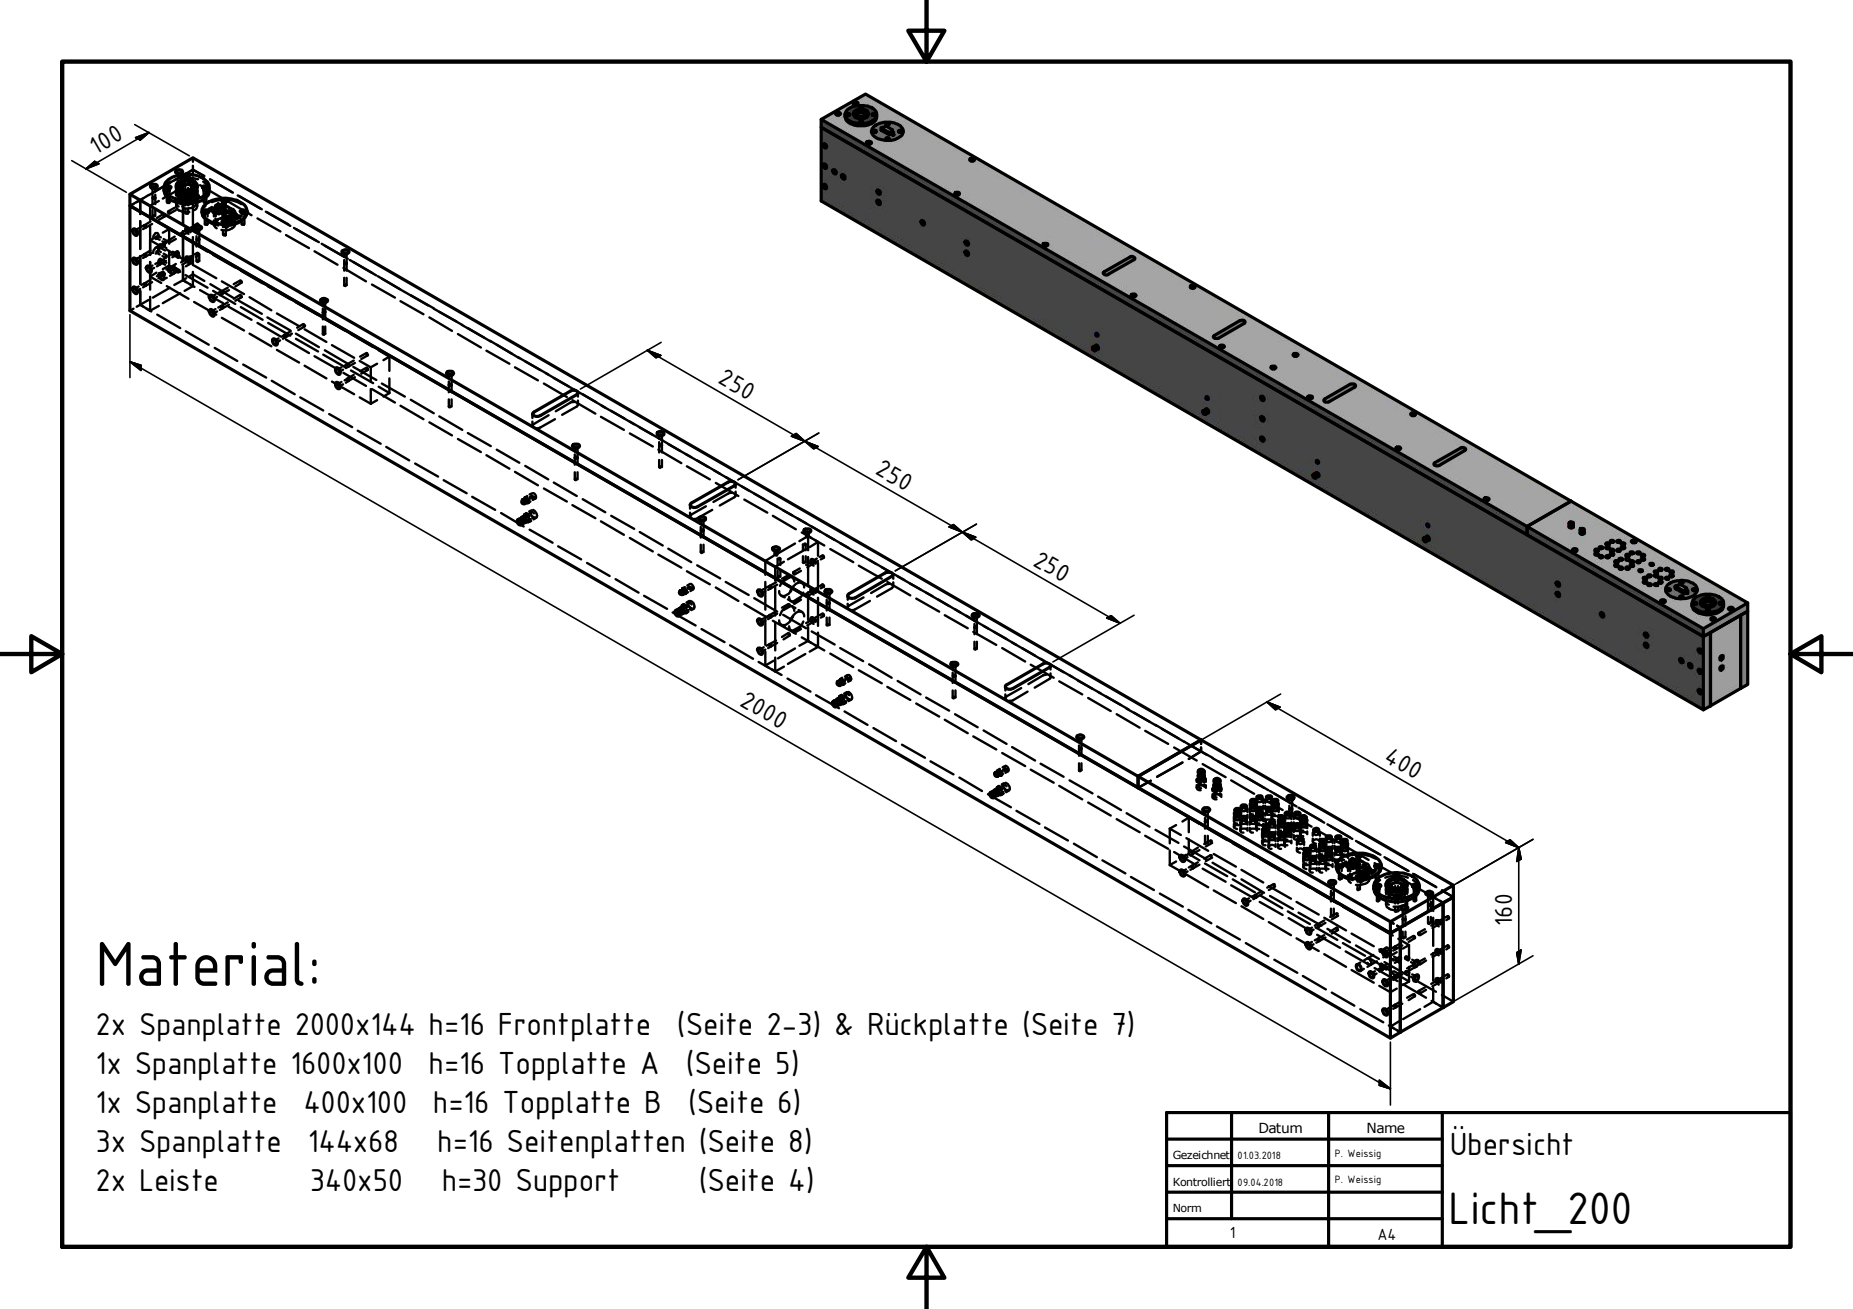
[picture p53: page 1]
Material:; 3x Spanplatte 144x68; h=16 Seitenplatten (Seite 8); 2x Leiste; h=30 Support; (Seite 4)

2x Spanplatte 2000x144 h=16 Frontplatte (Seite 2-3) & R¯ckplatte (Seite 7)
1x Spanplatte 1600x100 h=16 Topplatte A (Seite 5)
1x Spanplatte 400x100 h=16 Topplatte B (Seite 6)

Datum | Name | bersicht Licht_200

Gezeichnet | 01.03.2018 | P. Weissig

Kontrolliert | 09.04.2018 | P. Weissig

Norm

AF1

# 1x Spanplatte 2000x144 h=16

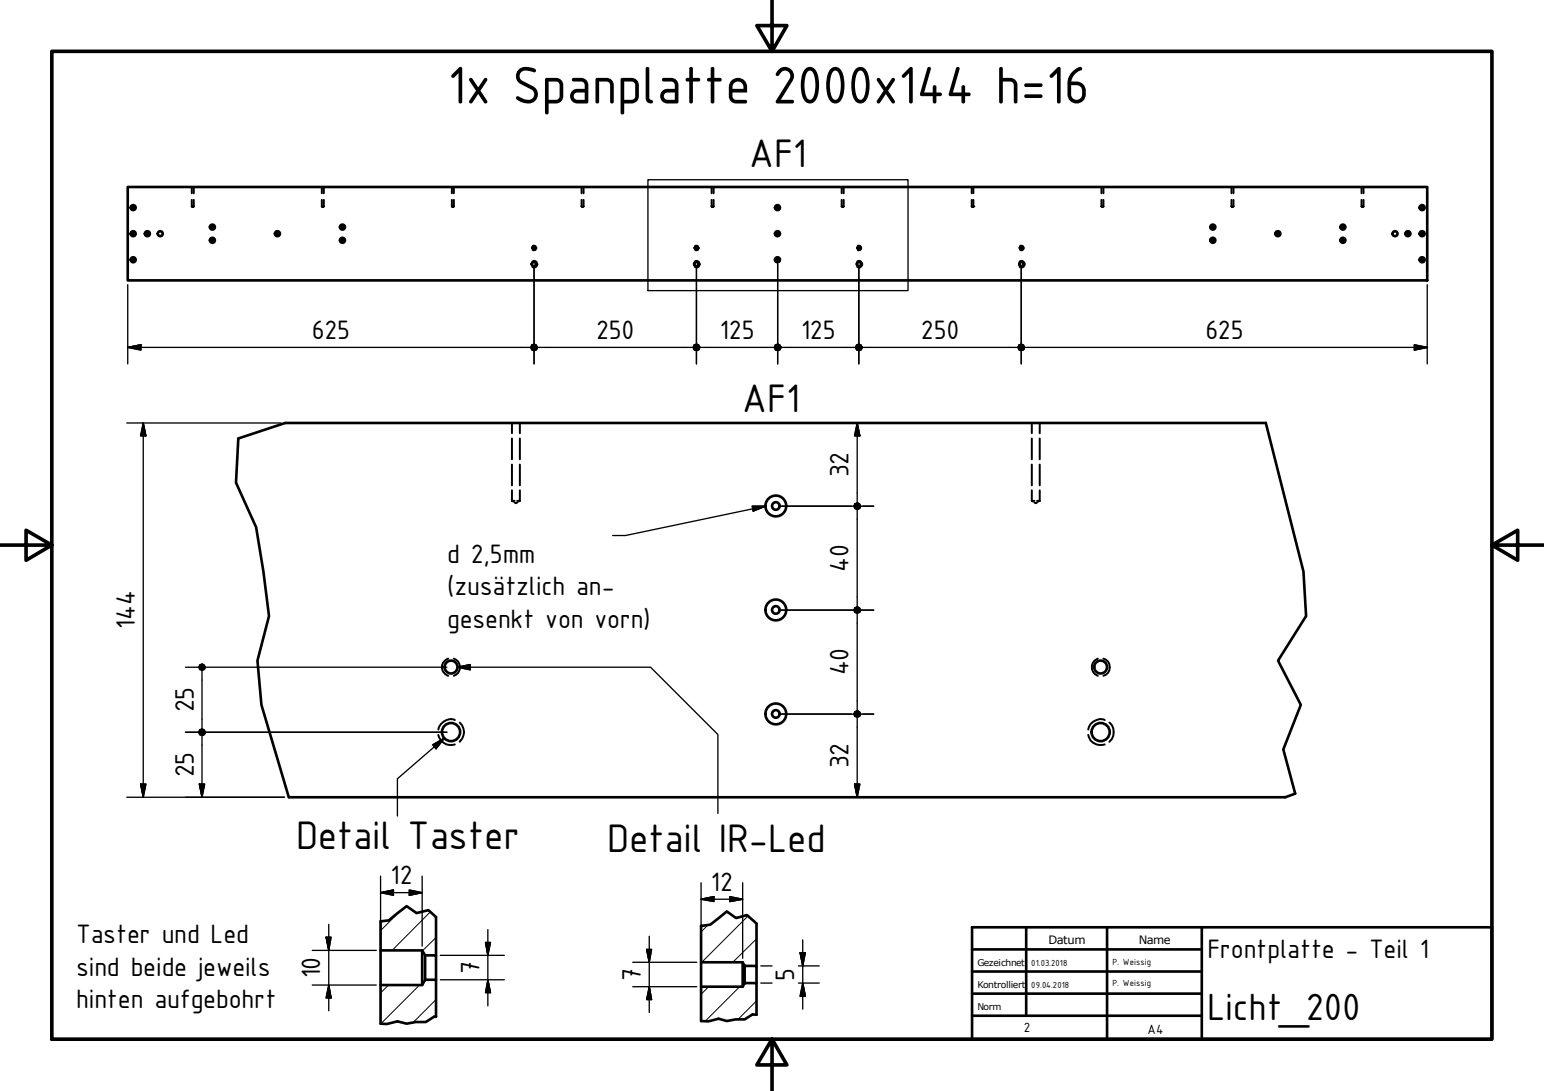
[picture p54: page 2]
Detail Taster; Detail IR-Led

(zustzlich an-
gesenkt von vorn)

Taster und Led
sind beide jeweils
hinten aufgebohrt

Datum | Name | Frontplatte - Teil 1

Gezeichnet | 01.03.2018 | P. Weissig

Kontrolliert | 09.04.2018 | P. Weissig

AF2

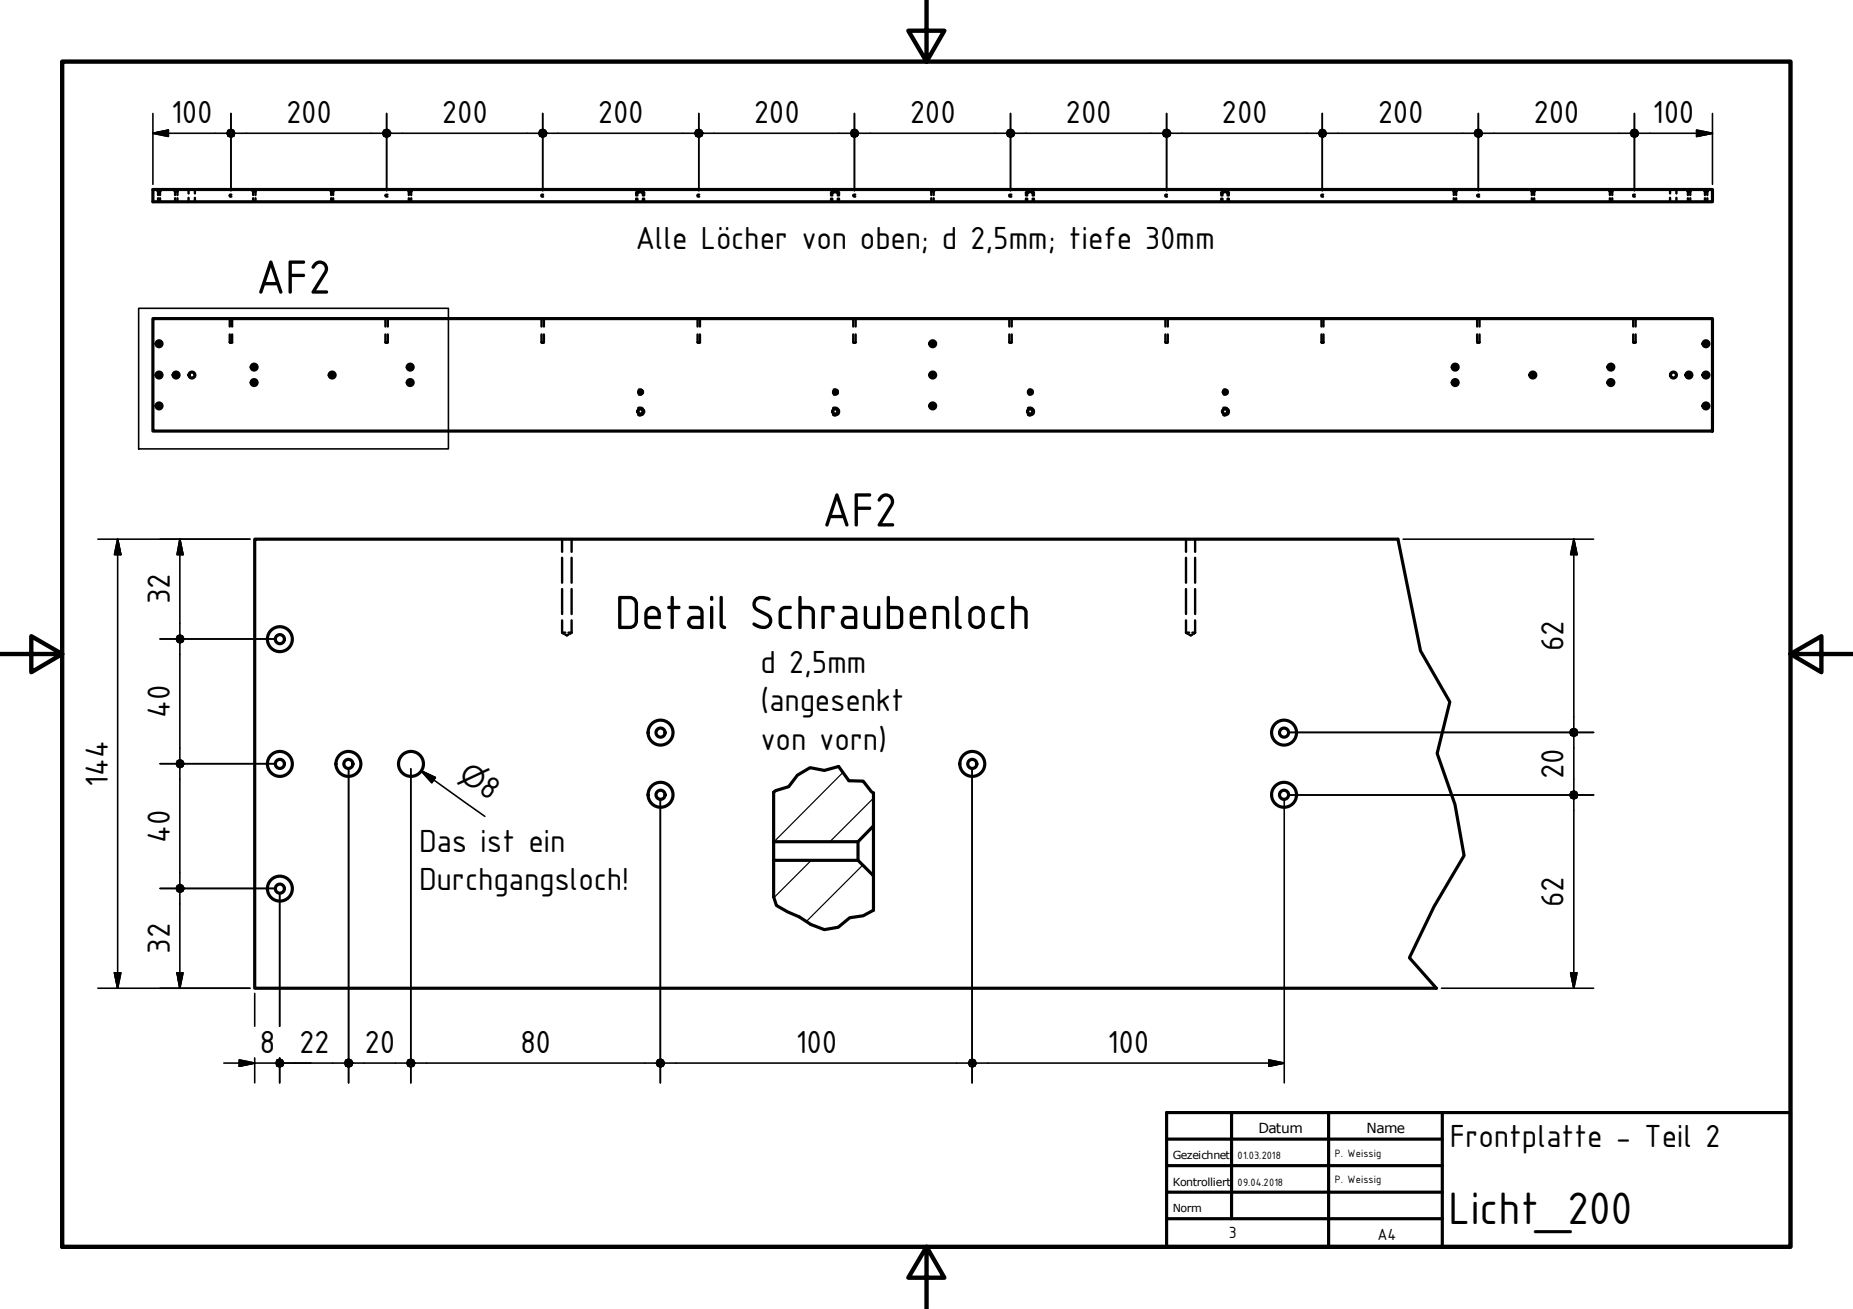
[picture p55: page 3]
Detail Schraubenloch; d 2,5mm (angesenkt von vorn)

Alle L©cher von oben; d 2,5mm; tiefe 30mm

Das ist ein
Durchgangsloch!

Datum | Name | Frontplatte - Teil 2

Gezeichnet | 01.03.2018 | P. Weissig

Kontrolliert | 09.04.2018 | P. Weissig

# 2x Leiste 340x50 h=30

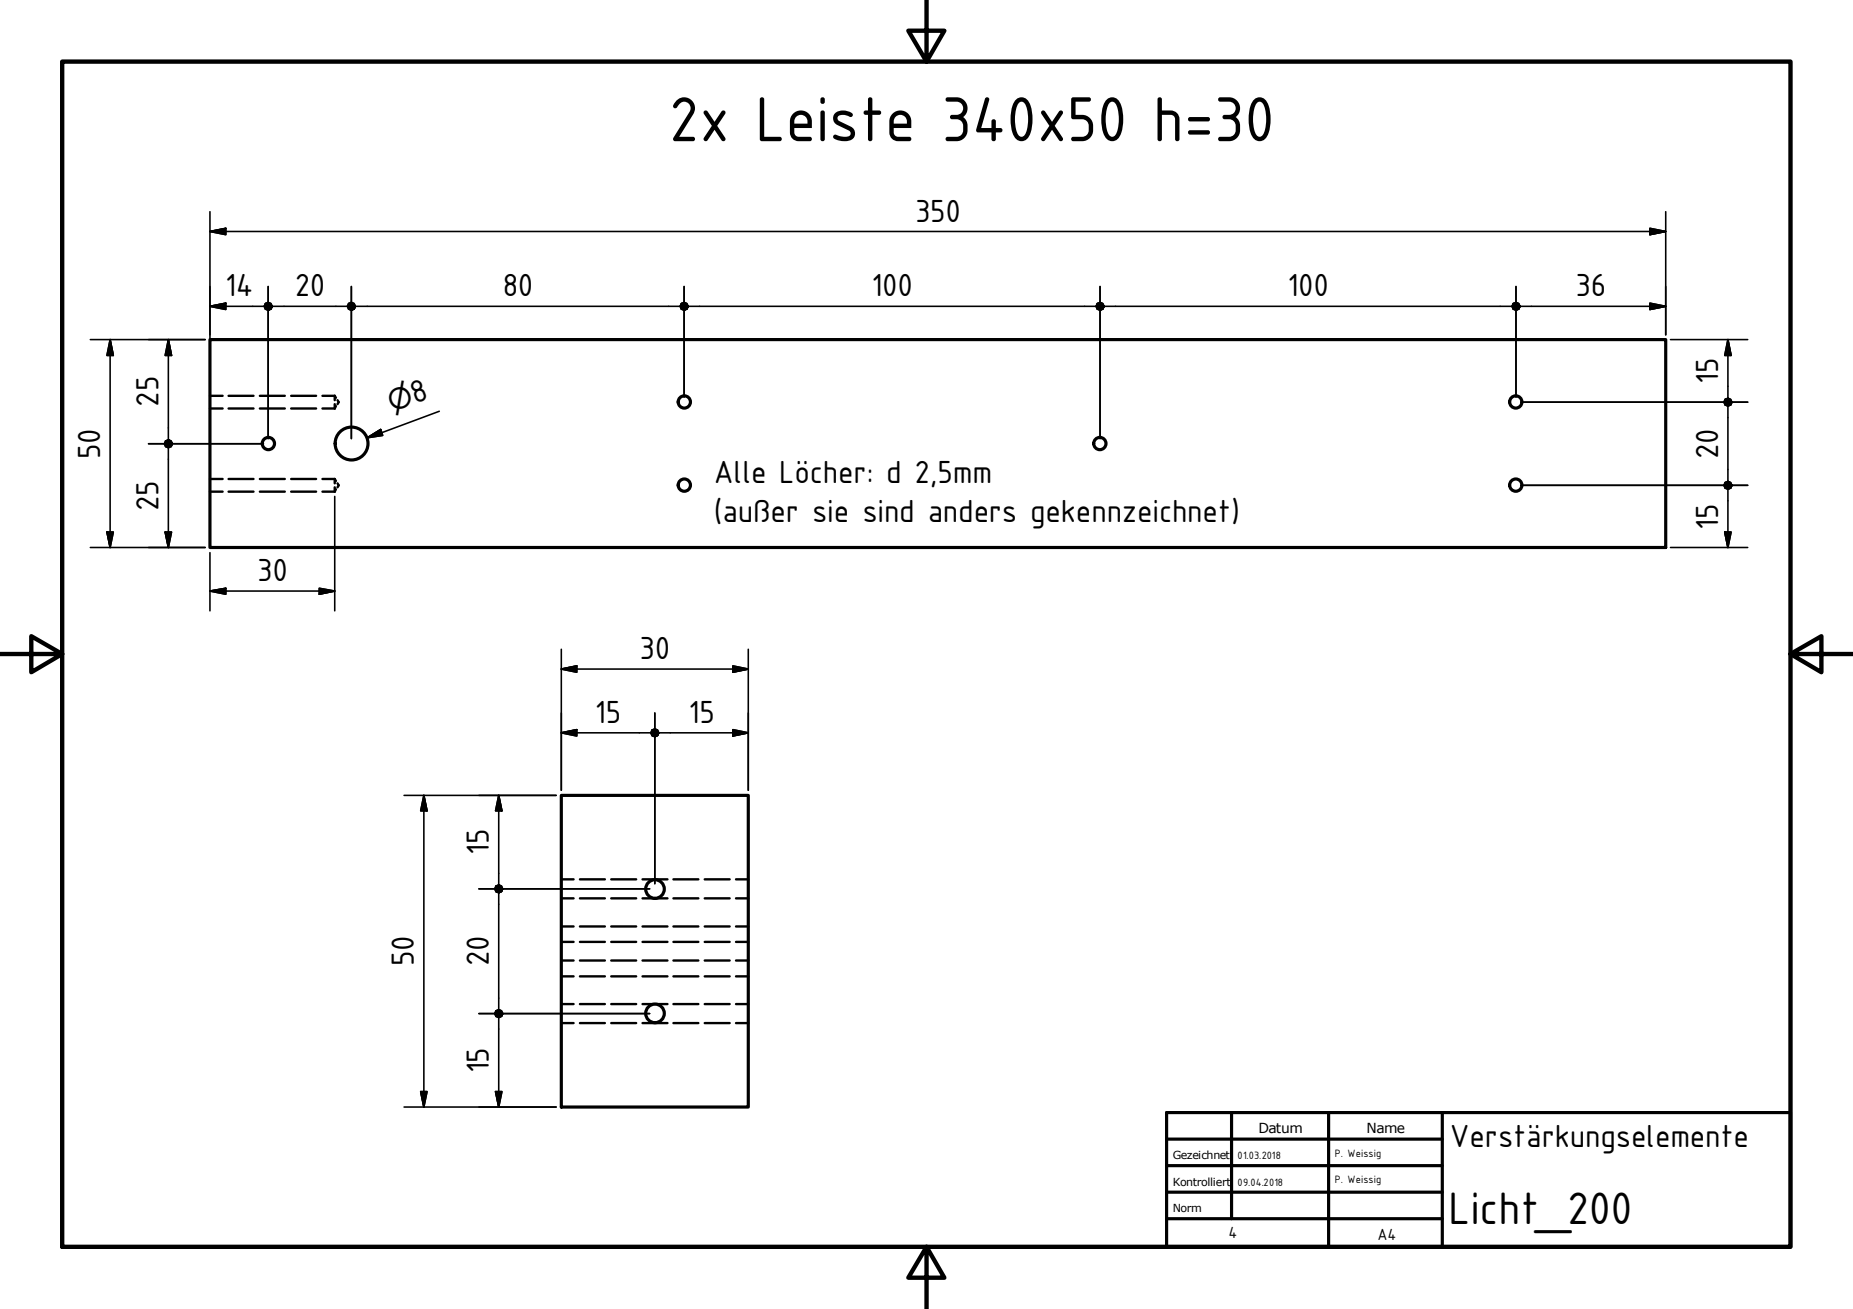
[picture p56: page 4]

Alle L©cher: d 2,5mm
(auer sie sind anders gekennzeichnet)

Datum | Name | Verstrkungselemente

Gezeichnet | 01.03.2018 | P. Weissig

Kontrolliert | 09.04.2018 | P. Weissig

AT1 | AT2

# 1x Spanplatte 1600x100 h=16

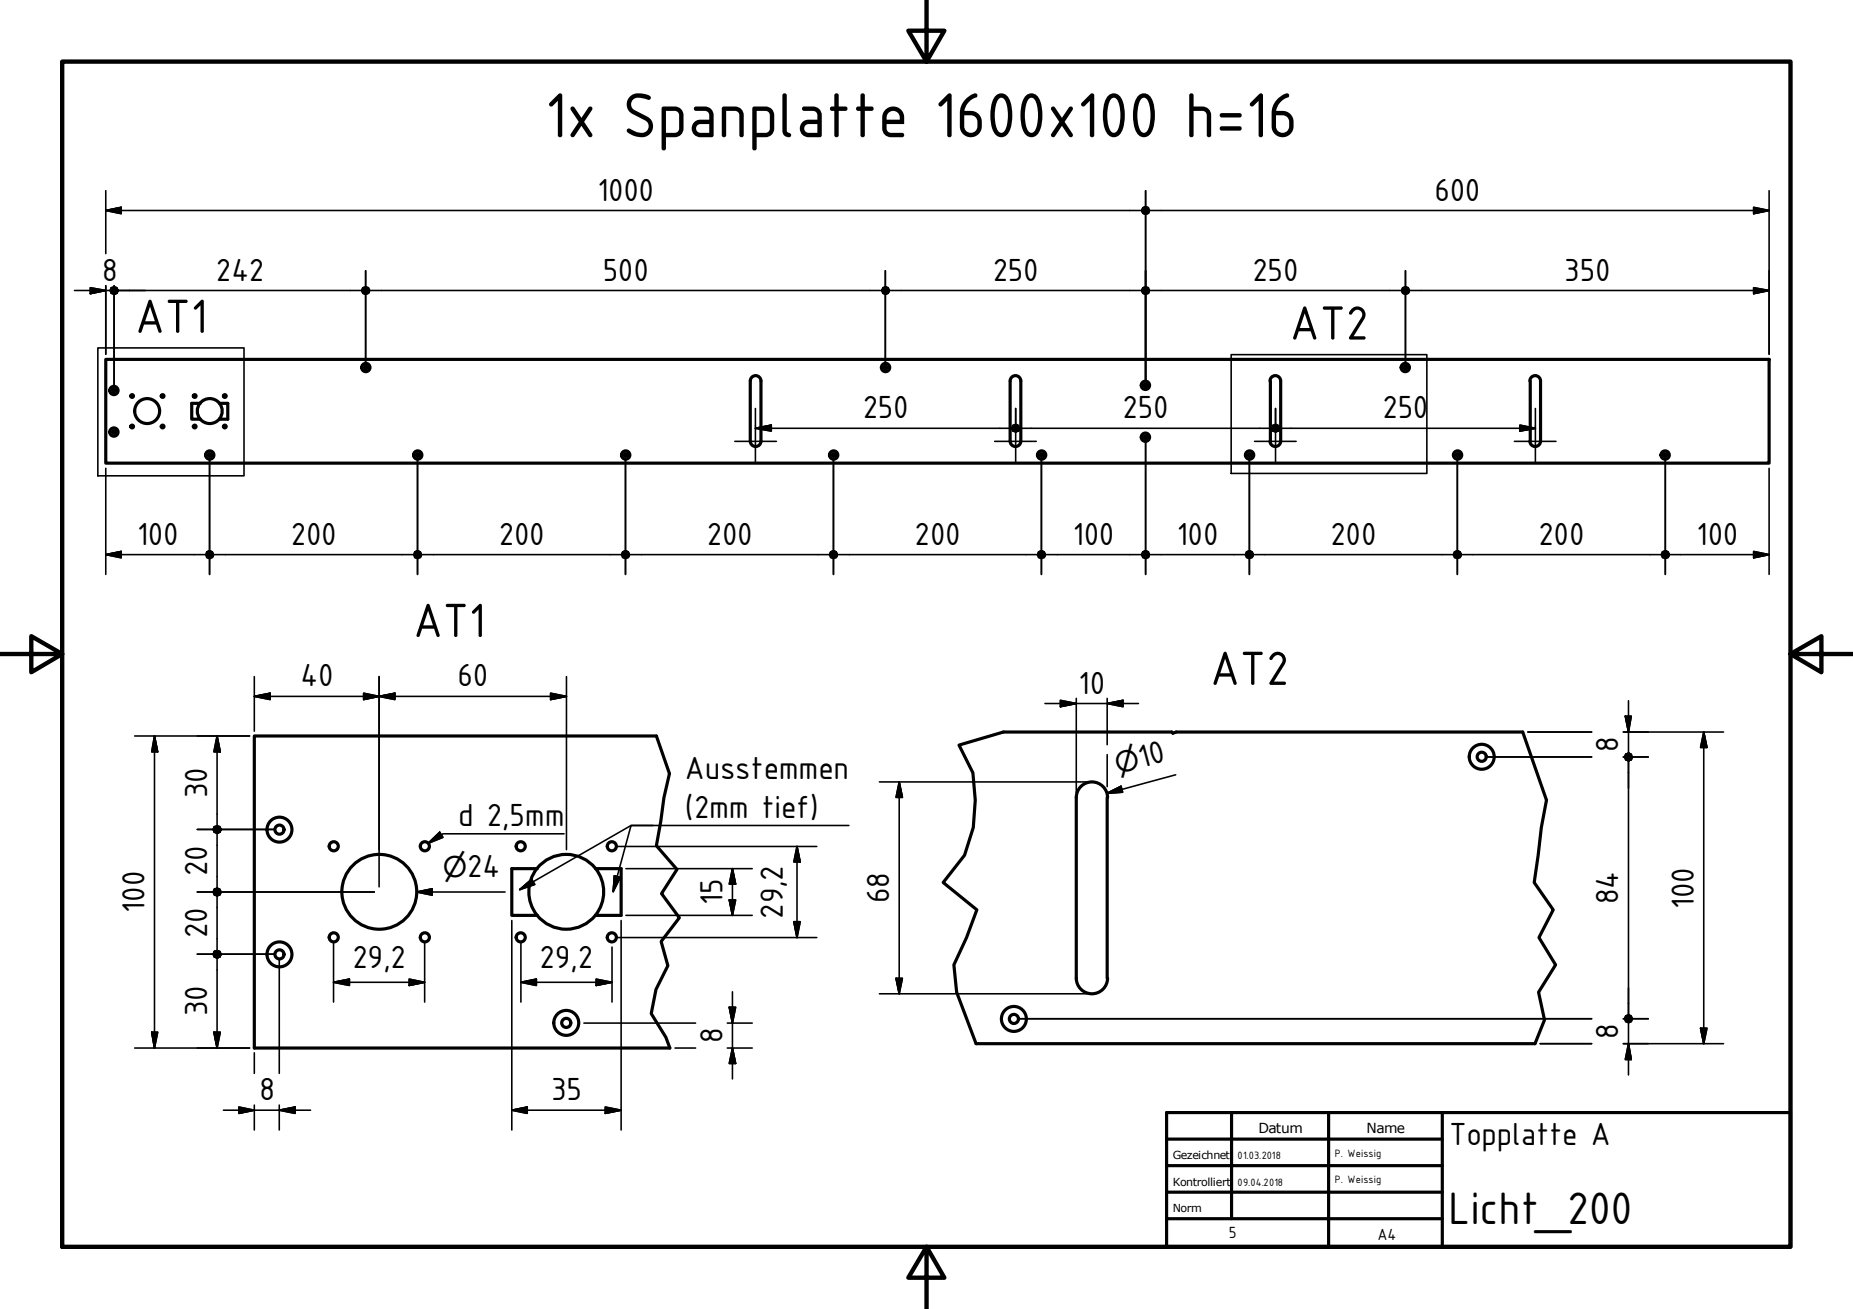
[picture p57: page 5]
Ausstemmen (2mm tief)

Datum | Name | Topplatte A

Gezeichnet | 01.03.2018 | P. Weissig

Kontrolliert | 09.04.2018 | P. Weissig

# 1x Spanplatte 400x100 h=16

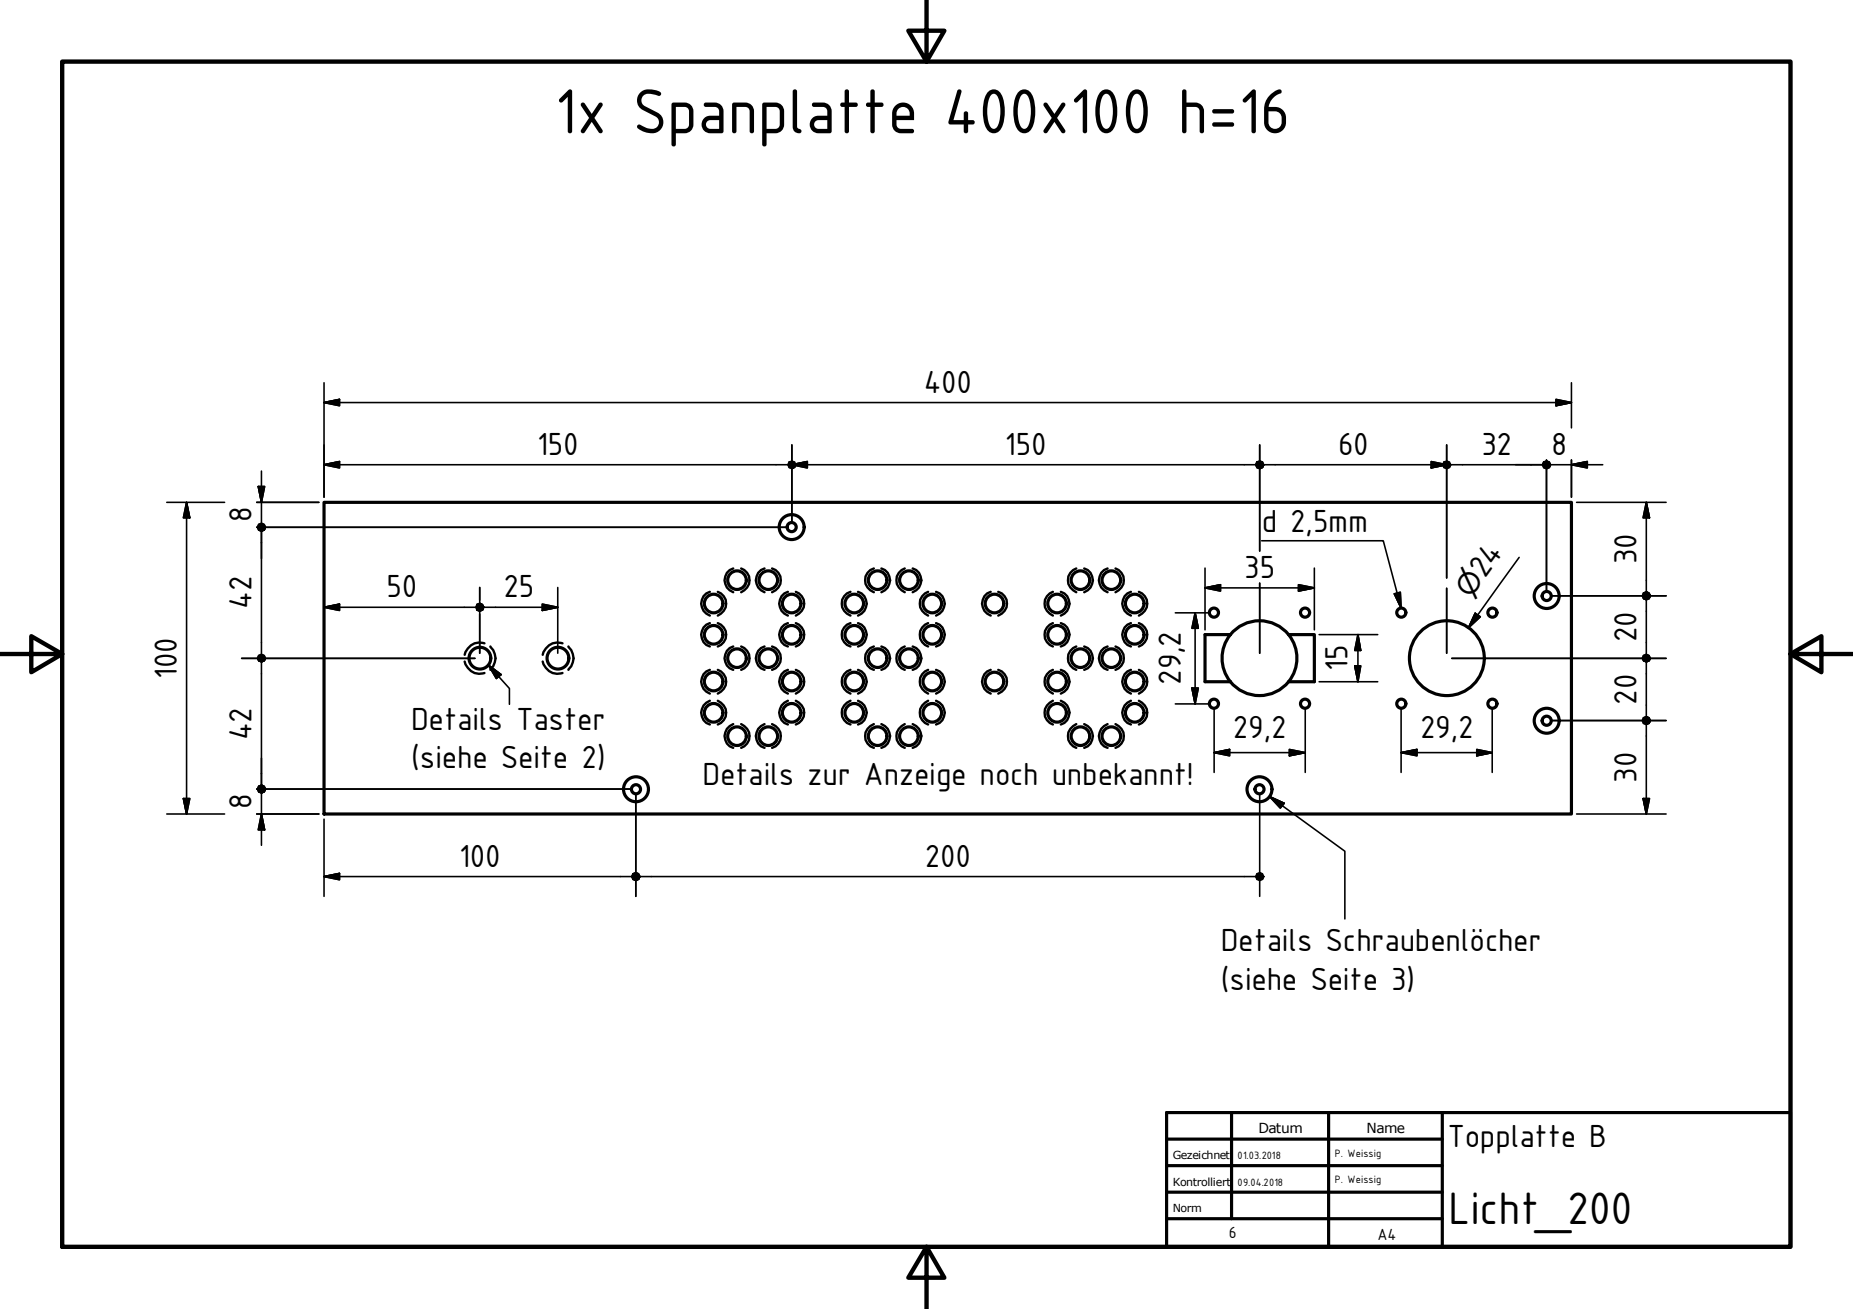
[picture p58: page 6]
Details Taster (siehe Seite 2)

Details zur Anzeige noch unbekannt!

Details Schraubenl©cher
(siehe Seite 3)

Datum | Name | Topplatte B

Gezeichnet | 01.03.2018 | P. Weissig

Kontrolliert | 09.04.2018 | P. Weissig

# 1x Spanplatte 2000x144 h=16

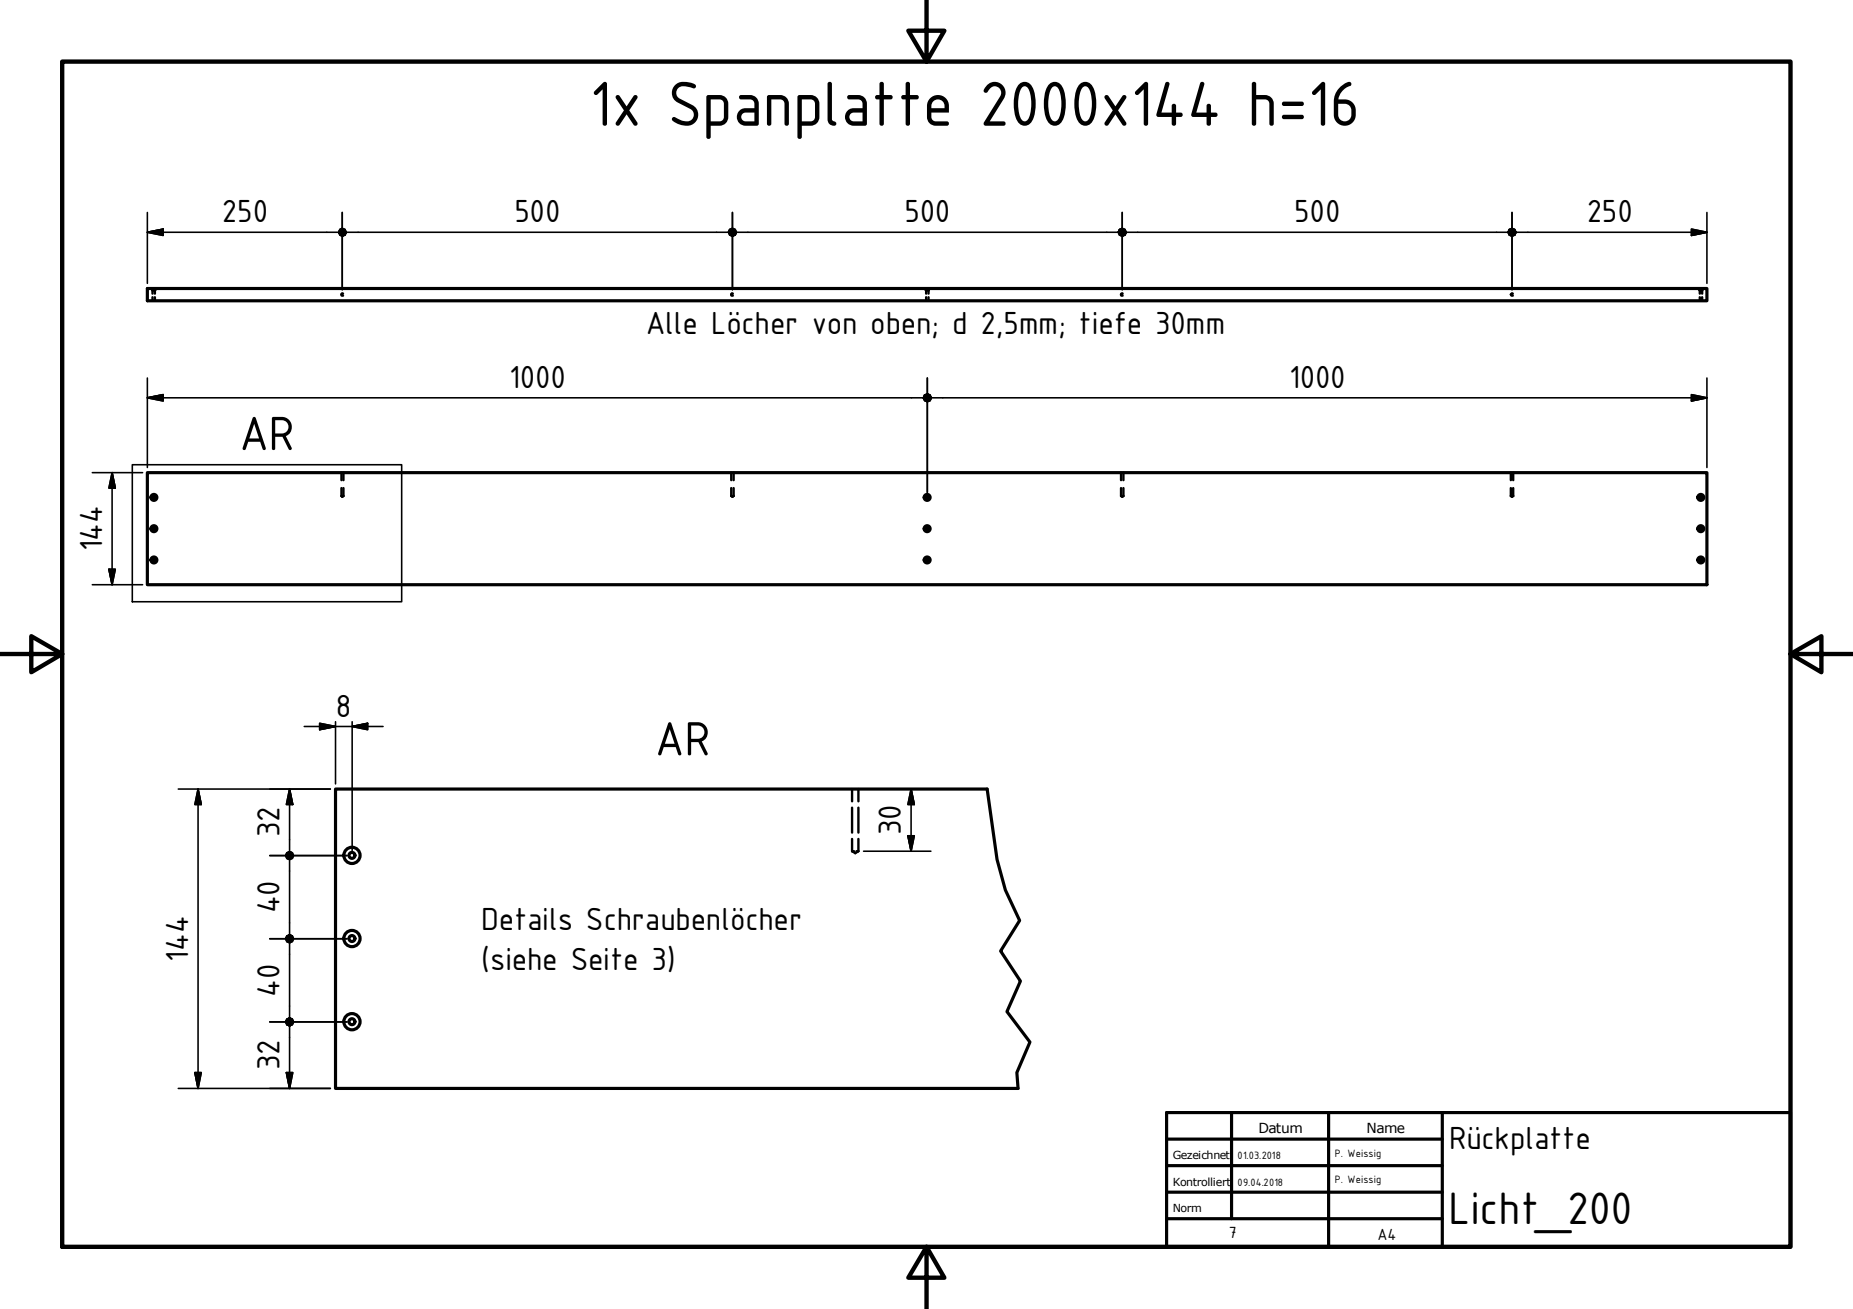
[picture p59: page 7]

Alle L©cher von oben; d 2,5mm; tiefe 30mm

Details Schraubenl©cher
(siehe Seite 3)

Datum | Name | R¯ckplatte

Gezeichnet | 01.03.2018 | P. Weissig

Kontrolliert | 09.04.2018 | P. Weissig

# 3x Spanplatte 144x68 h=16

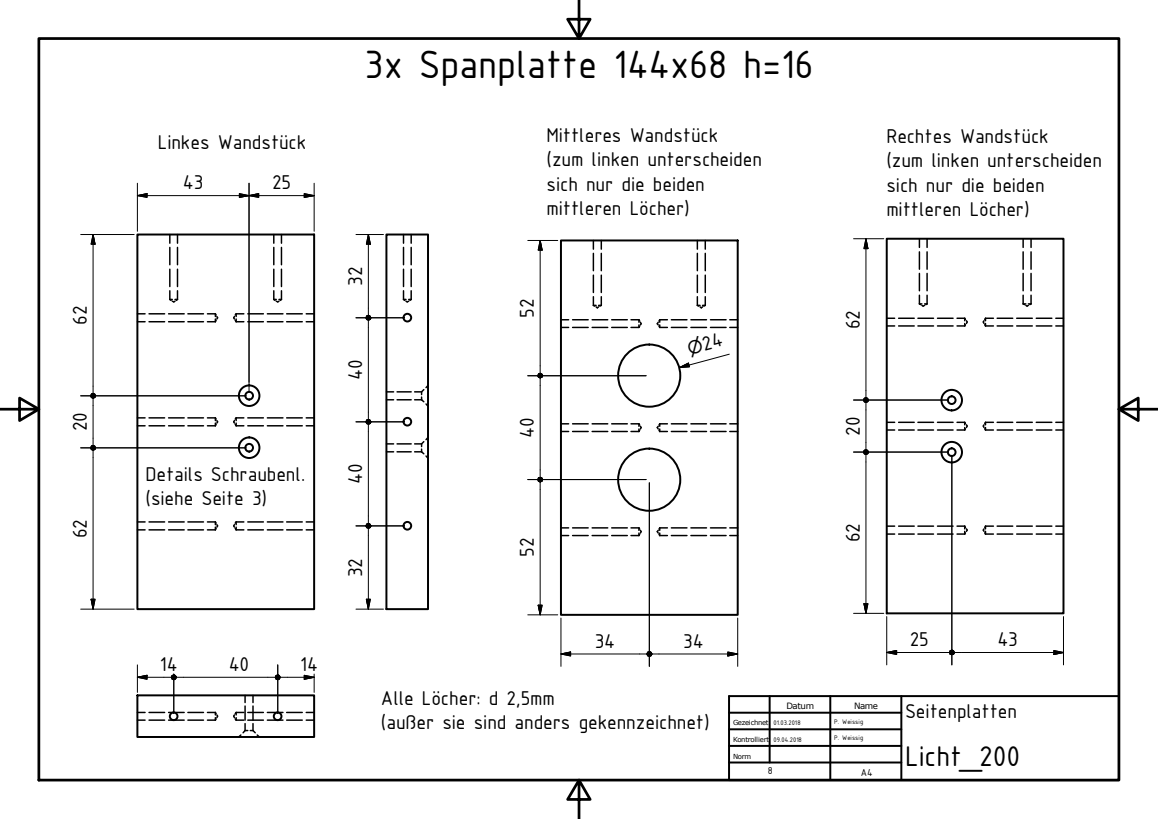
[picture p60: page 8]
Details Schraubenl. (siehe Seite 3)

Linkes Wandst¯ck

Mittleres Wandst¯ck
(zum linken unterscheiden
sich nur die beiden
mittleren L©cher)

Rechtes Wandst¯ck

Alle L©cher: d 2,5mm
(auer sie sind anders gekennzeichnet)

Datum | Name | Seitenplatten

Gezeichnet | 01.03.2018 | P. Weissig

Kontrolliert | 09.04.2018 | P. Weissig
