RoboSAX/cad_spielfeld/2019/Programmieranschluss/2019_02_23_Programmieranschluss.pdf

## Spielfeld 2019

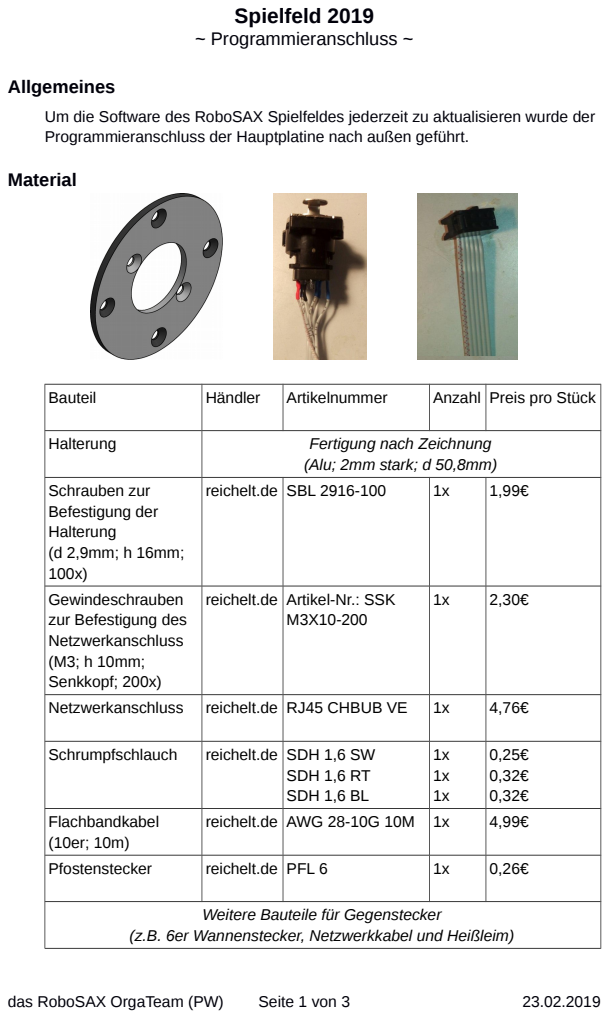
[picture p61: page 1]
~ Programmieranschluss ~; Material; Bauteil; Händler; Artikelnummer; Anzahl Preis pro Stück; Halterung; Fertigung nach Zeichnung; (Alu; 2mm stark; d 50,8mm); Schrauben zur Befestigung der Halterung (d 2,9mm; h 16mm; 100x); reichelt.de SBL 2916-100; Gewindeschrauben zur Befestigung des Netzwerkanschluss (M3; h 10mm; Senkkopf; 200x); Netzwerkanschluss; reichelt.de RJ45 CHBUB VE; Schrumpfschlauch; reichelt.de SDH 1,6 SW; SDH 1,6 RT SDH 1,6 BL; Flachbandkabel (10er; 10m)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

reichelt.de Artikel-Nr.: SSK

Weitere Bauteile für Gegenstecker

(z.B. 6er Wannenstecker, Netzwerkkabel und Heißleim)

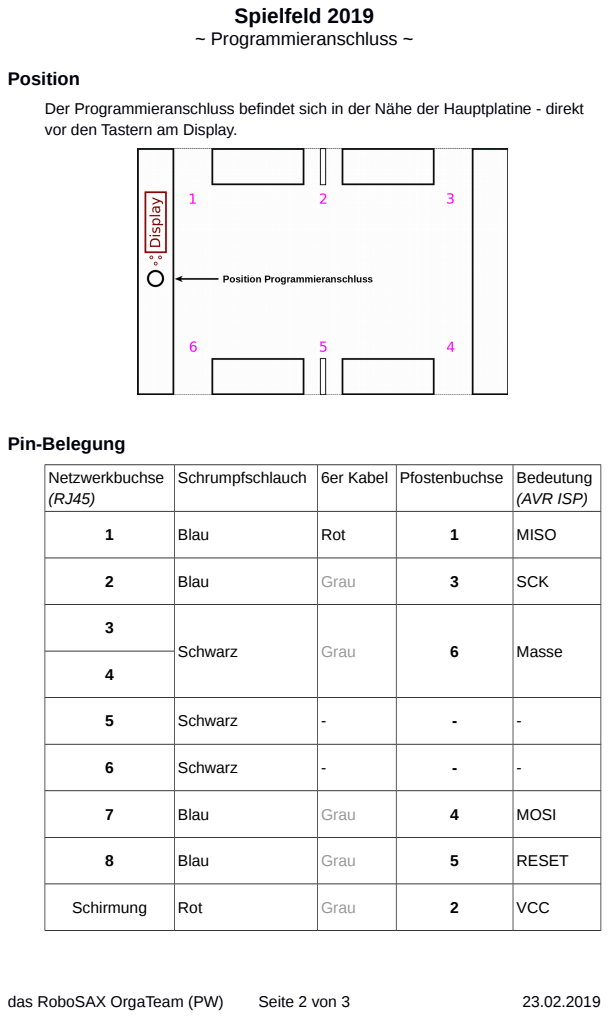
[picture p62: page 2]
Pin-Belegung; Netzwerkbuchse (RJ45); (AVR ISP); Blau; Rot; MISO; Grau; SCK; Schwarz; Masse; MOSI; RESET; Schirmung; VCC; das RoboSAX OrgaTeam (PW); Seite 2 von 3

Position
Der Programmieranschluss befindet sich in der Nähe der Hauptplatine - direkt
vor den Tastern am Display.

Schrumpfschlauch 6er Kabel Pfostenbuchse Bedeutung

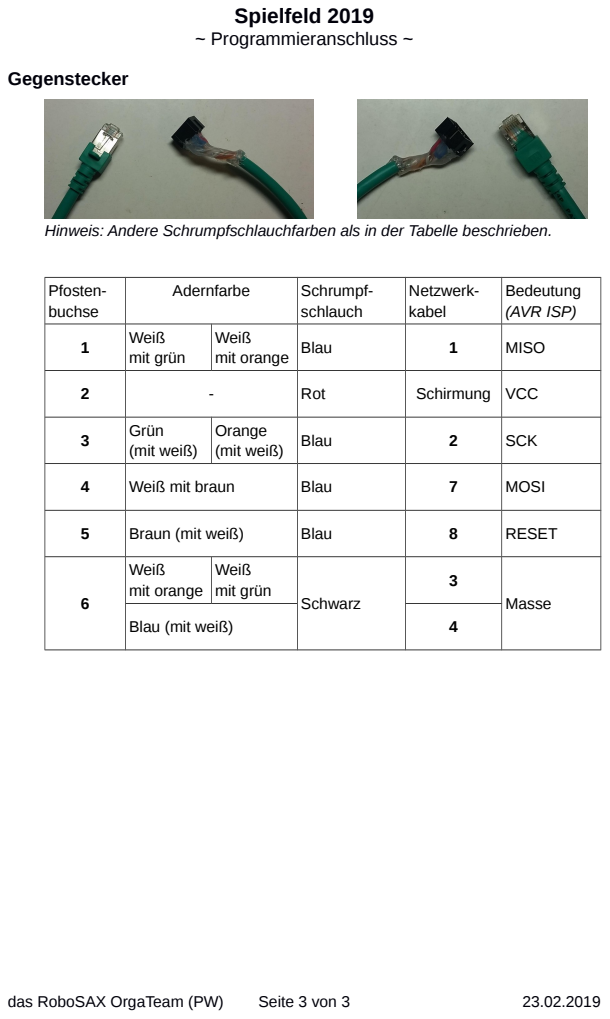
[picture p63: page 3]
Gegenstecker; Pfosten- buchse; Adernfarbe; Schrumpf-; schlauch; Netzwerk- kabel; Bedeutung (AVR ISP); Weiß mit grün; Weiß; mit orange Blau; MISO; Rot; Schirmung VCC; Grün (mit weiß); Orange; (mit weiß) Blau; SCK; Weiß mit braun; Blau; MOSI; Braun (mit weiß); RESET; Weiß mit orange; Schwarz; Masse; Blau (mit weiß); das RoboSAX OrgaTeam (PW); Seite 3 von 3

Hinweis: Andere Schrumpfschlauchfarben als in der Tabelle beschrieben.
