RoboSAX/cad_spielfeld/2019/Schnappverschluesse/2019_02_23_Schnappverschluesse.pdf

## Spielfeld 2019

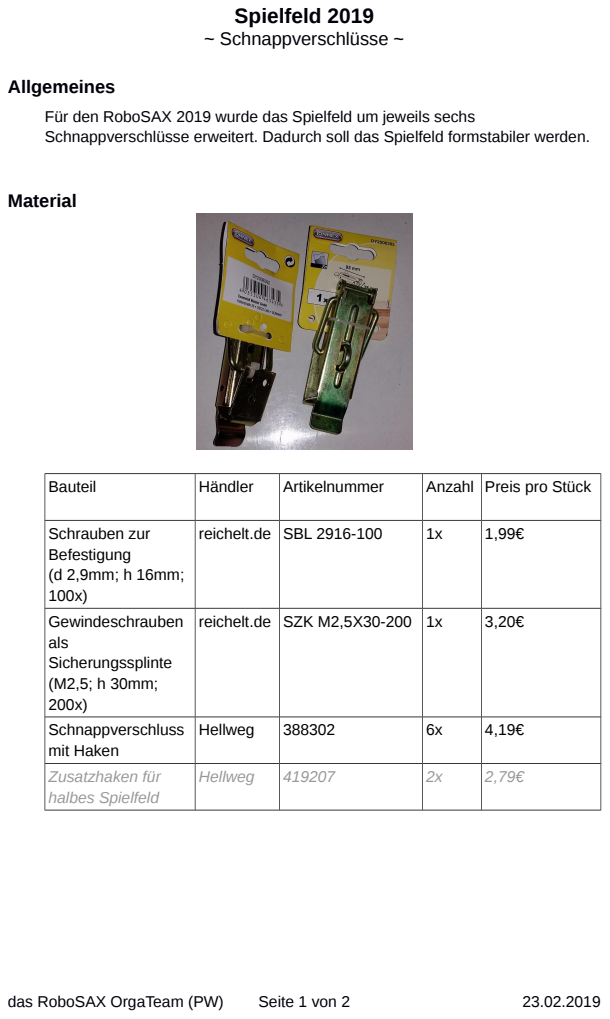
[picture p64: page 1]
~ Schnappverschlüsse ~; Material; Bauteil; Händler; Artikelnummer; Anzahl Preis pro Stück; Schrauben zur Befestigung (d 2,9mm; h 16mm; 100x); reichelt.de SBL 2916-100; Gewindeschrauben als Sicherungssplinte (M2,5; h 30mm; 200x); reichelt.de SZK M2,5X30-200 1x; Schnappverschluss mit Haken; Hellweg; Zusatzhaken für halbes Spielfeld; das RoboSAX OrgaTeam (PW); Seite 1 von 2

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

## Spielfeld 2019

~ Schnappverschlüsse ~

Verteilung

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

Befestigung

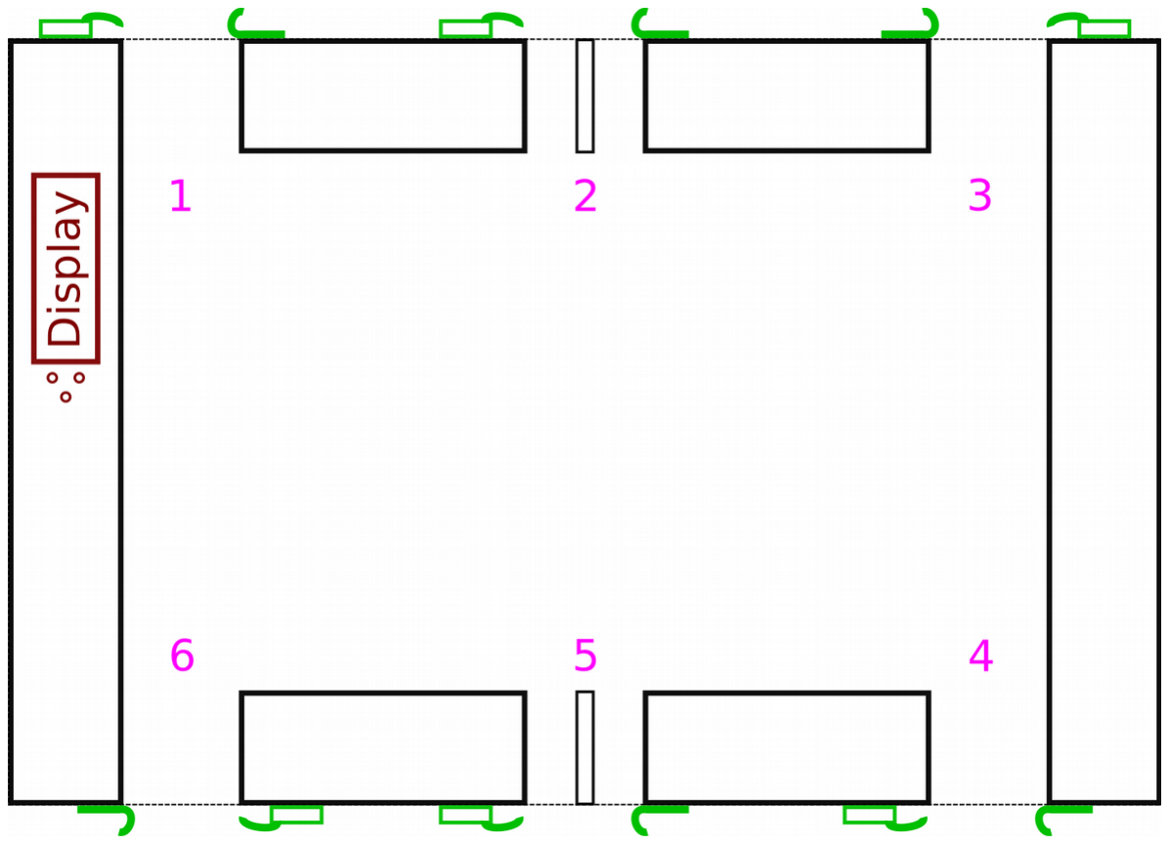
[picture p65: figure]
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

### 9 mm statt 25 mm von der Kante entfernt sind. Dies liegt an den

Wandschnippseln mit einer Breite von 16mm.

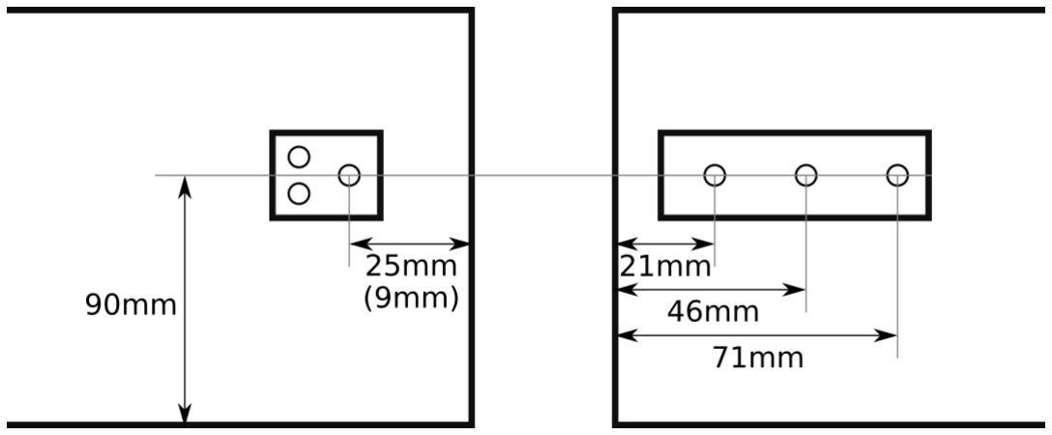
[picture p66: figure]

das RoboSAX OrgaTeam (PW) | Seite 2 von 2 | 23.02.2019
