RoboSAX/cad_spielfeld/2020/Tasteranschluss/Zeichnungen/anschluss_taster.pdf

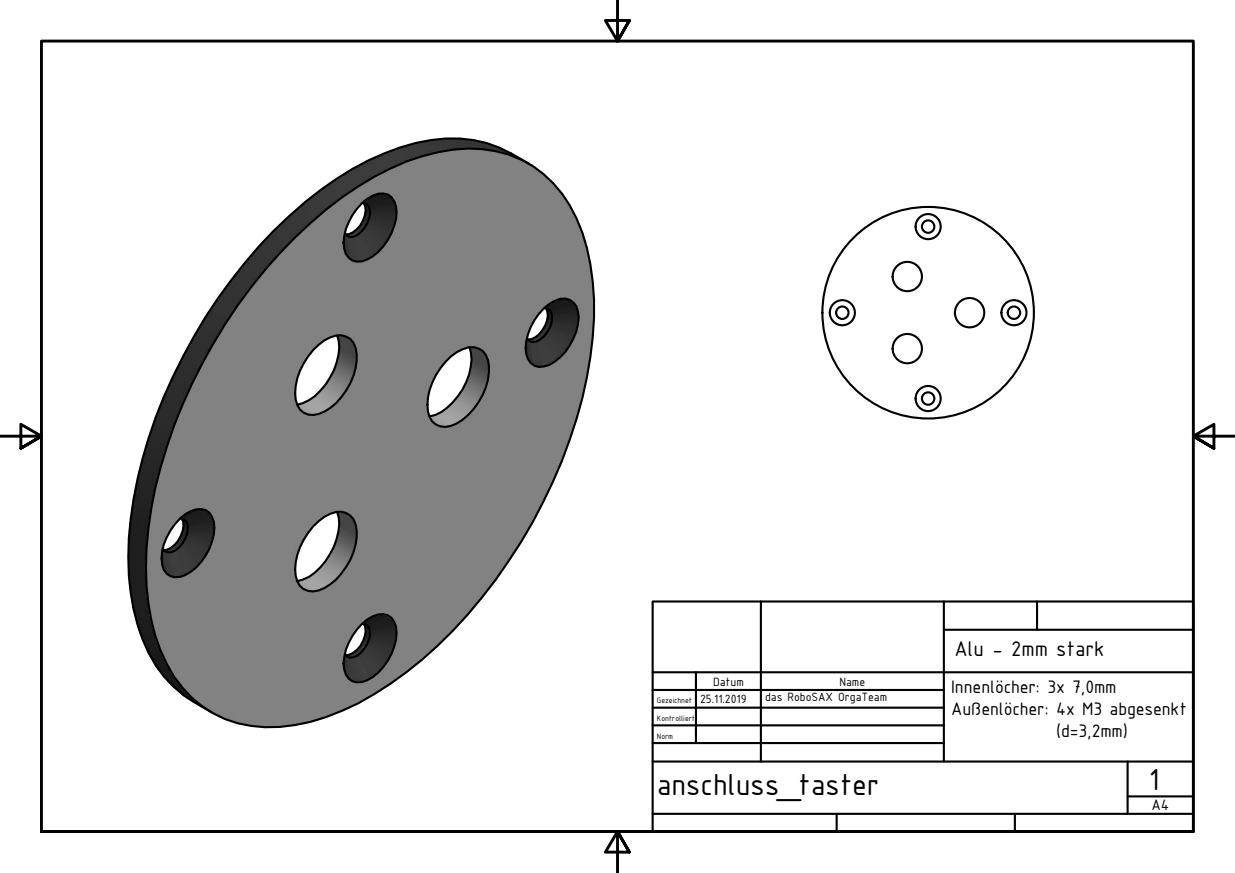
[picture p67: page 1]
Alu - 2mm stark

Datum | Name | Innenl©cher: 3x 7,0mm Auenl©cher: 4x M3 abgesenkt (d=3,2mm)

Gezeichnet | 25.11.2019 | das RoboSAX OrgaTeam

Kontrolliert

Norm

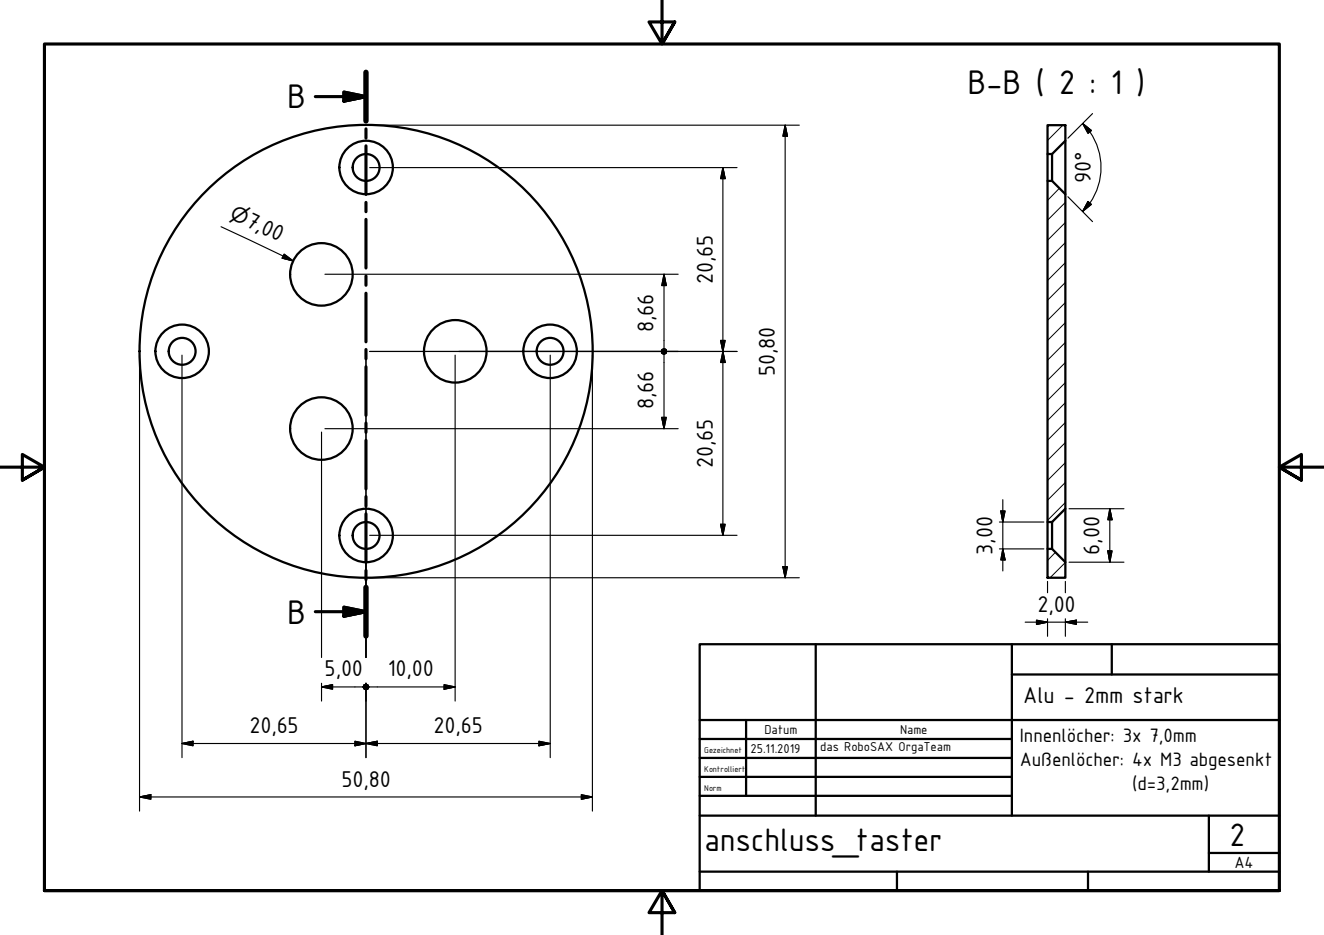
[picture p68: page 2]
Alu - 2mm stark

Datum | Name | Innenl©cher: 3x 7,0mm Auenl©cher: 4x M3 abgesenkt (d=3,2mm)

Gezeichnet | 25.11.2019 | das RoboSAX OrgaTeam

Kontrolliert

Norm
