RoboSAX/cad_spielfeld/2019/Programmieranschluss/Zeichnungen/anschluss_programmer.pdf

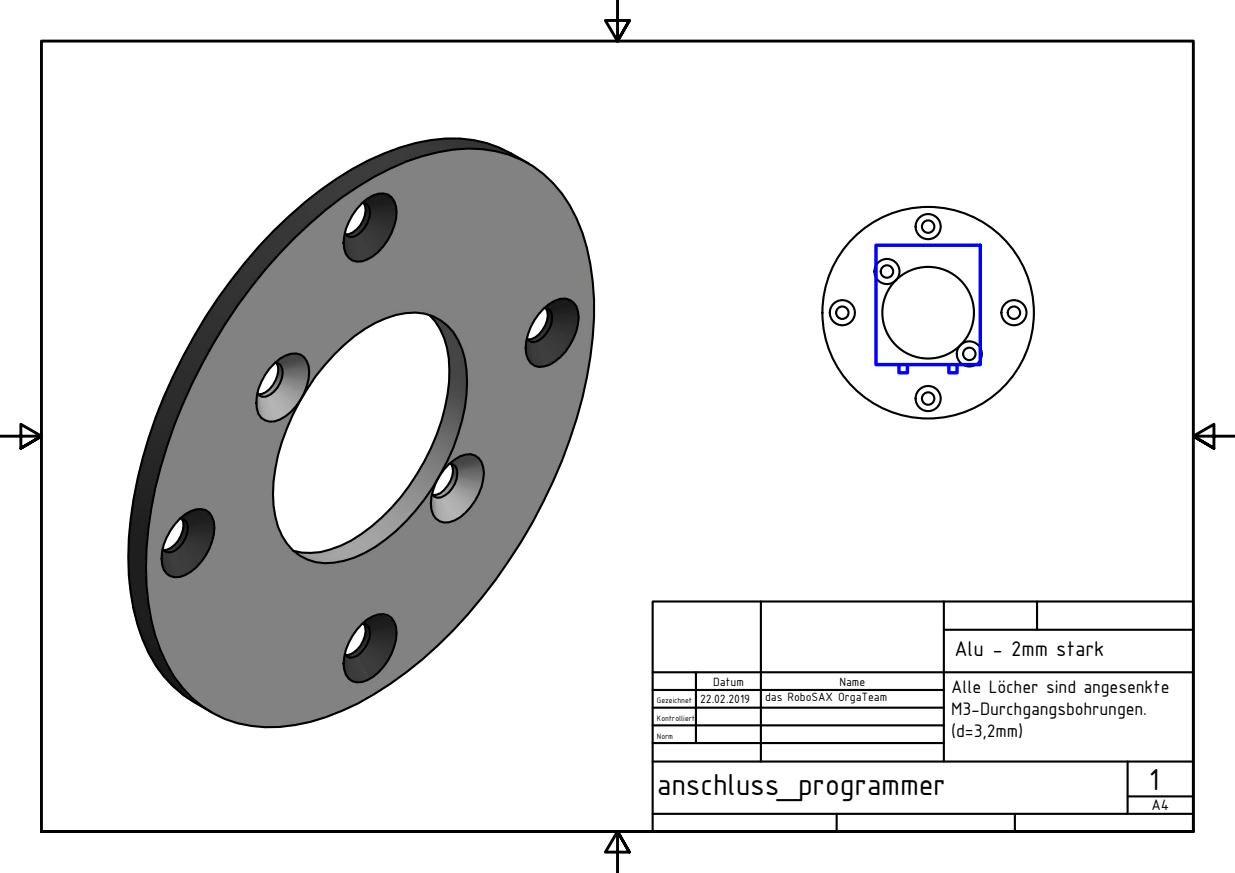
[picture p69: page 1]
Alu - 2mm stark

Datum | Name | Alle L©cher sind angesenkte M3-Durchgangsbohrungen. (d=3,2mm)

Gezeichnet | 22.02.2019 | das RoboSAX OrgaTeam

Kontrolliert

Norm

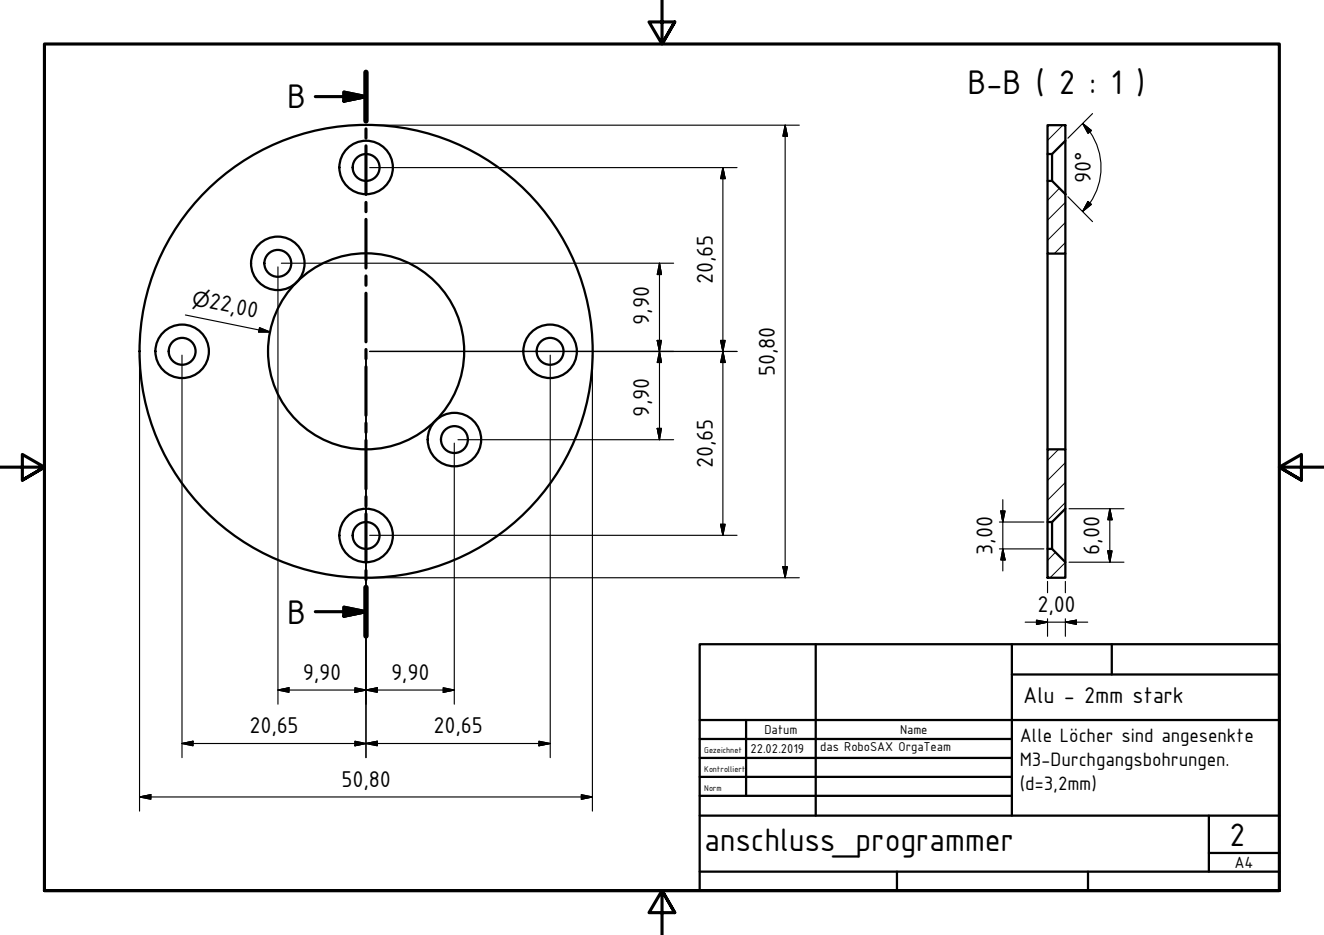
[picture p70: page 2]
Alu - 2mm stark

Datum | Name | Alle L©cher sind angesenkte M3-Durchgangsbohrungen. (d=3,2mm)

Gezeichnet | 22.02.2019 | das RoboSAX OrgaTeam

Kontrolliert

Norm
