RoboSAX/cad_spielfeld/2018/Spielfeld/Zeichnungen/export/anschluss_daten_1.idw.pdf

D | D
6 | 5 | 4 | 3 | 2 | 1

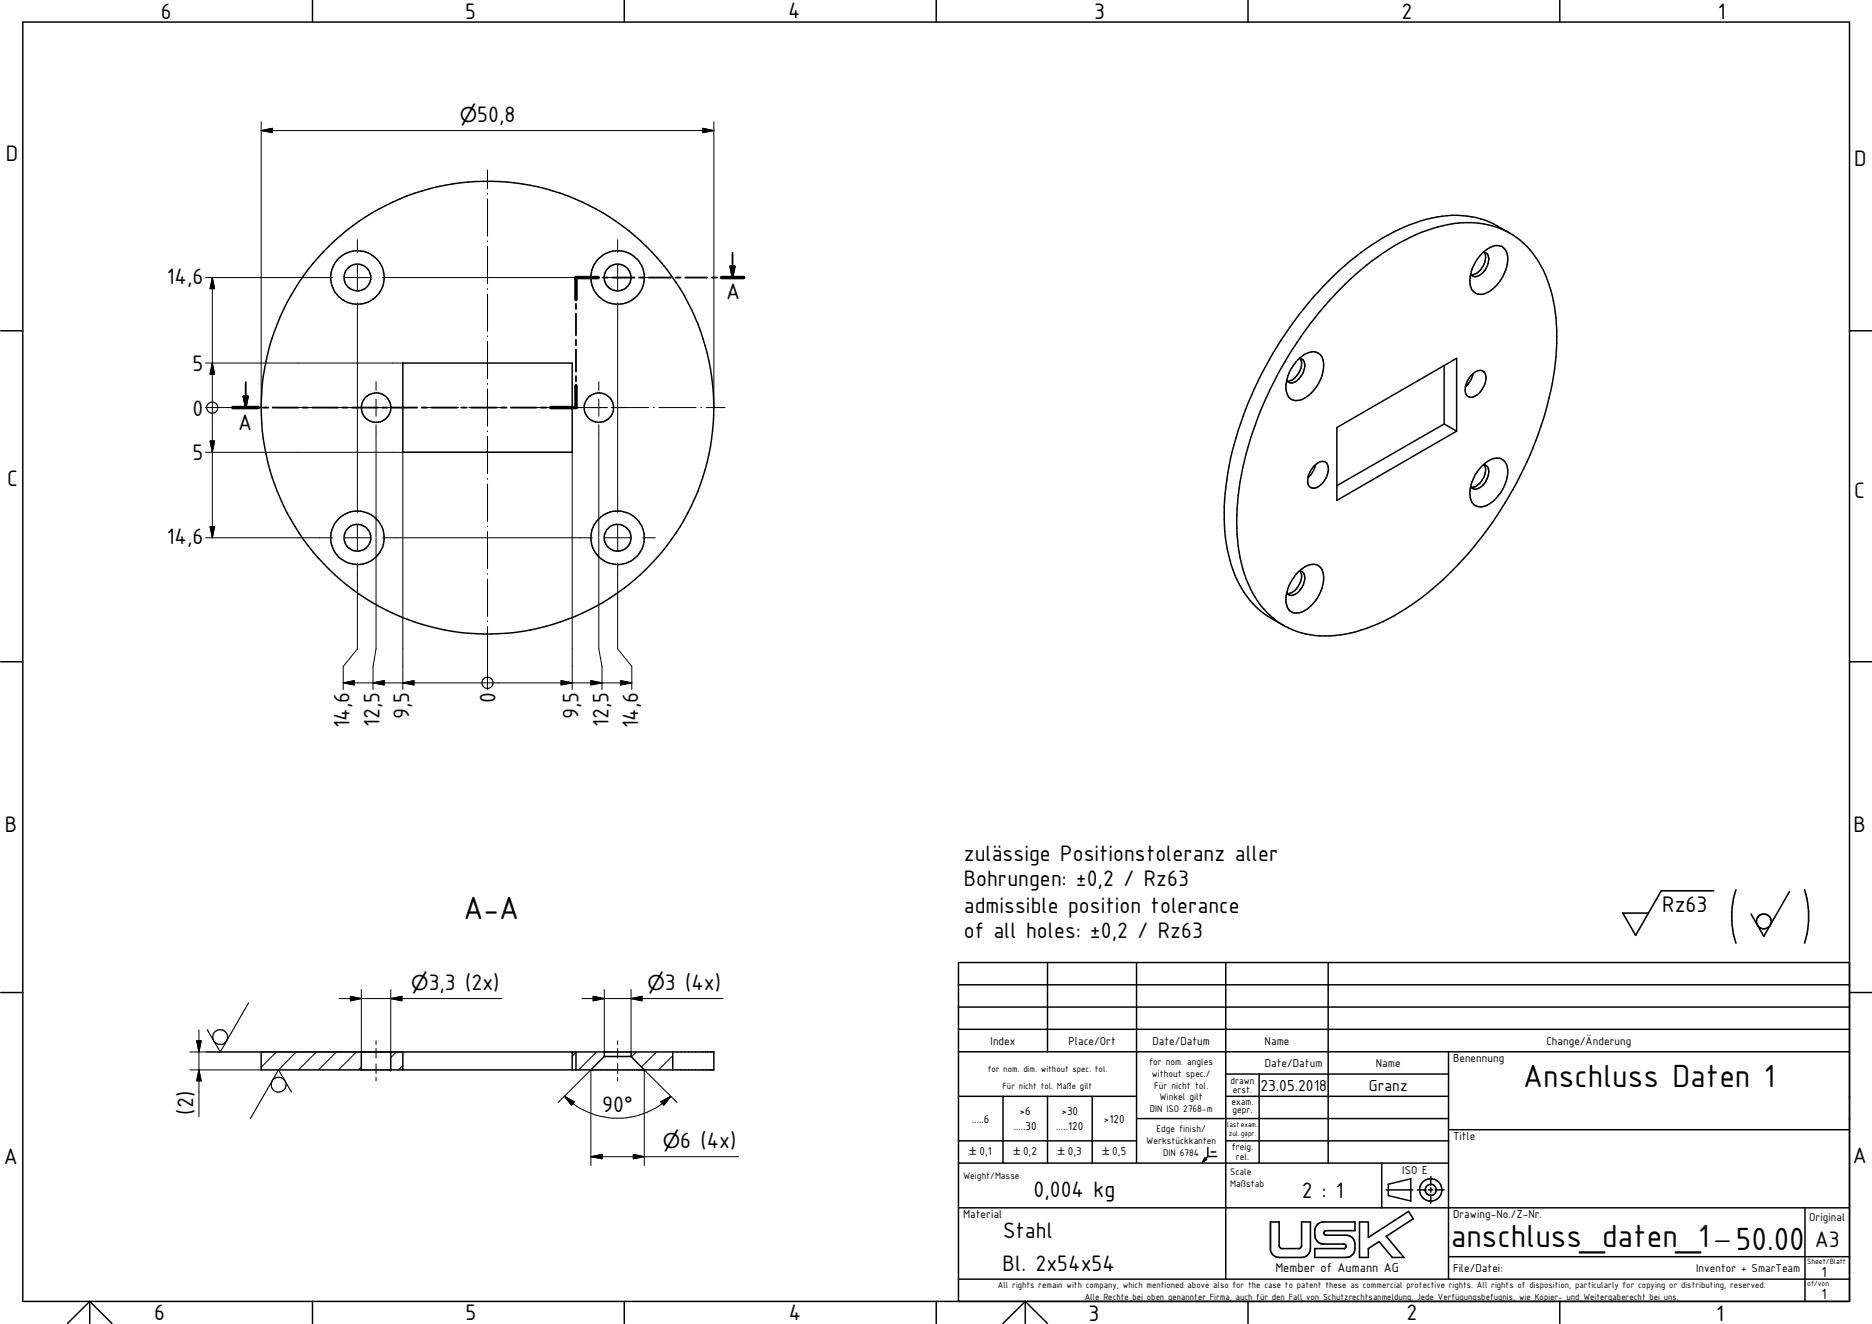
[picture p71: page 1]
DIN 6784; rel.; Title; freig.

zulässige Positionstoleranz aller
Bohrungen: ±0,2 / Rz63
admissible position tolerance
of all holes: ±0,2 / Rz63

Index | Place/Ort | Date/Datum | Name | Change/Änderung
for nom. dim. without spec. tol. Für nicht tol. Maße gilt | for nom. angles without spec./ Für nicht tol. Winkel gilt DIN ISO 2768-m | Date/Datum | | Benennung Name Anschluss Daten 1

drawn erst. | 23.05.2018 | Granz

.....6 | >6 .....30 | >30 .....120 | >120 | | exam. gepr.

Edge finish/ Werkstückkanten | last exam. zul. gepr.

`0,2 Alle Rechte bei oben genannter Firma, auch für den Fall von Schutzrechtsanmeldung. Jede Verfügungsbefugnis, wie Kopier- und Weitergaberecht bei uns. `0,1 Weight/Masse Material 0,004 kg | Scale Maßstab 2 : 1 | ISO E

Stahl Bl. 2x54x54 | | | Drawing-No./Z-Nr. anschluss_daten_1 50.00 | Original A3

Member of Aumann AG

File/Datei: Inventor + SmarTeam | Sheet/Blatt 1

All rights remain with company, which mentioned above also for the case to patent these as commercial protective rights. All rights of disposition, particularly for copying or distributing, reserved. | | | | of/von 1
