RoboSAX/cad_spielfeld/2018/Spielfeld/Zeichnungen/export/licht_150_back.idw.pdf

E

F

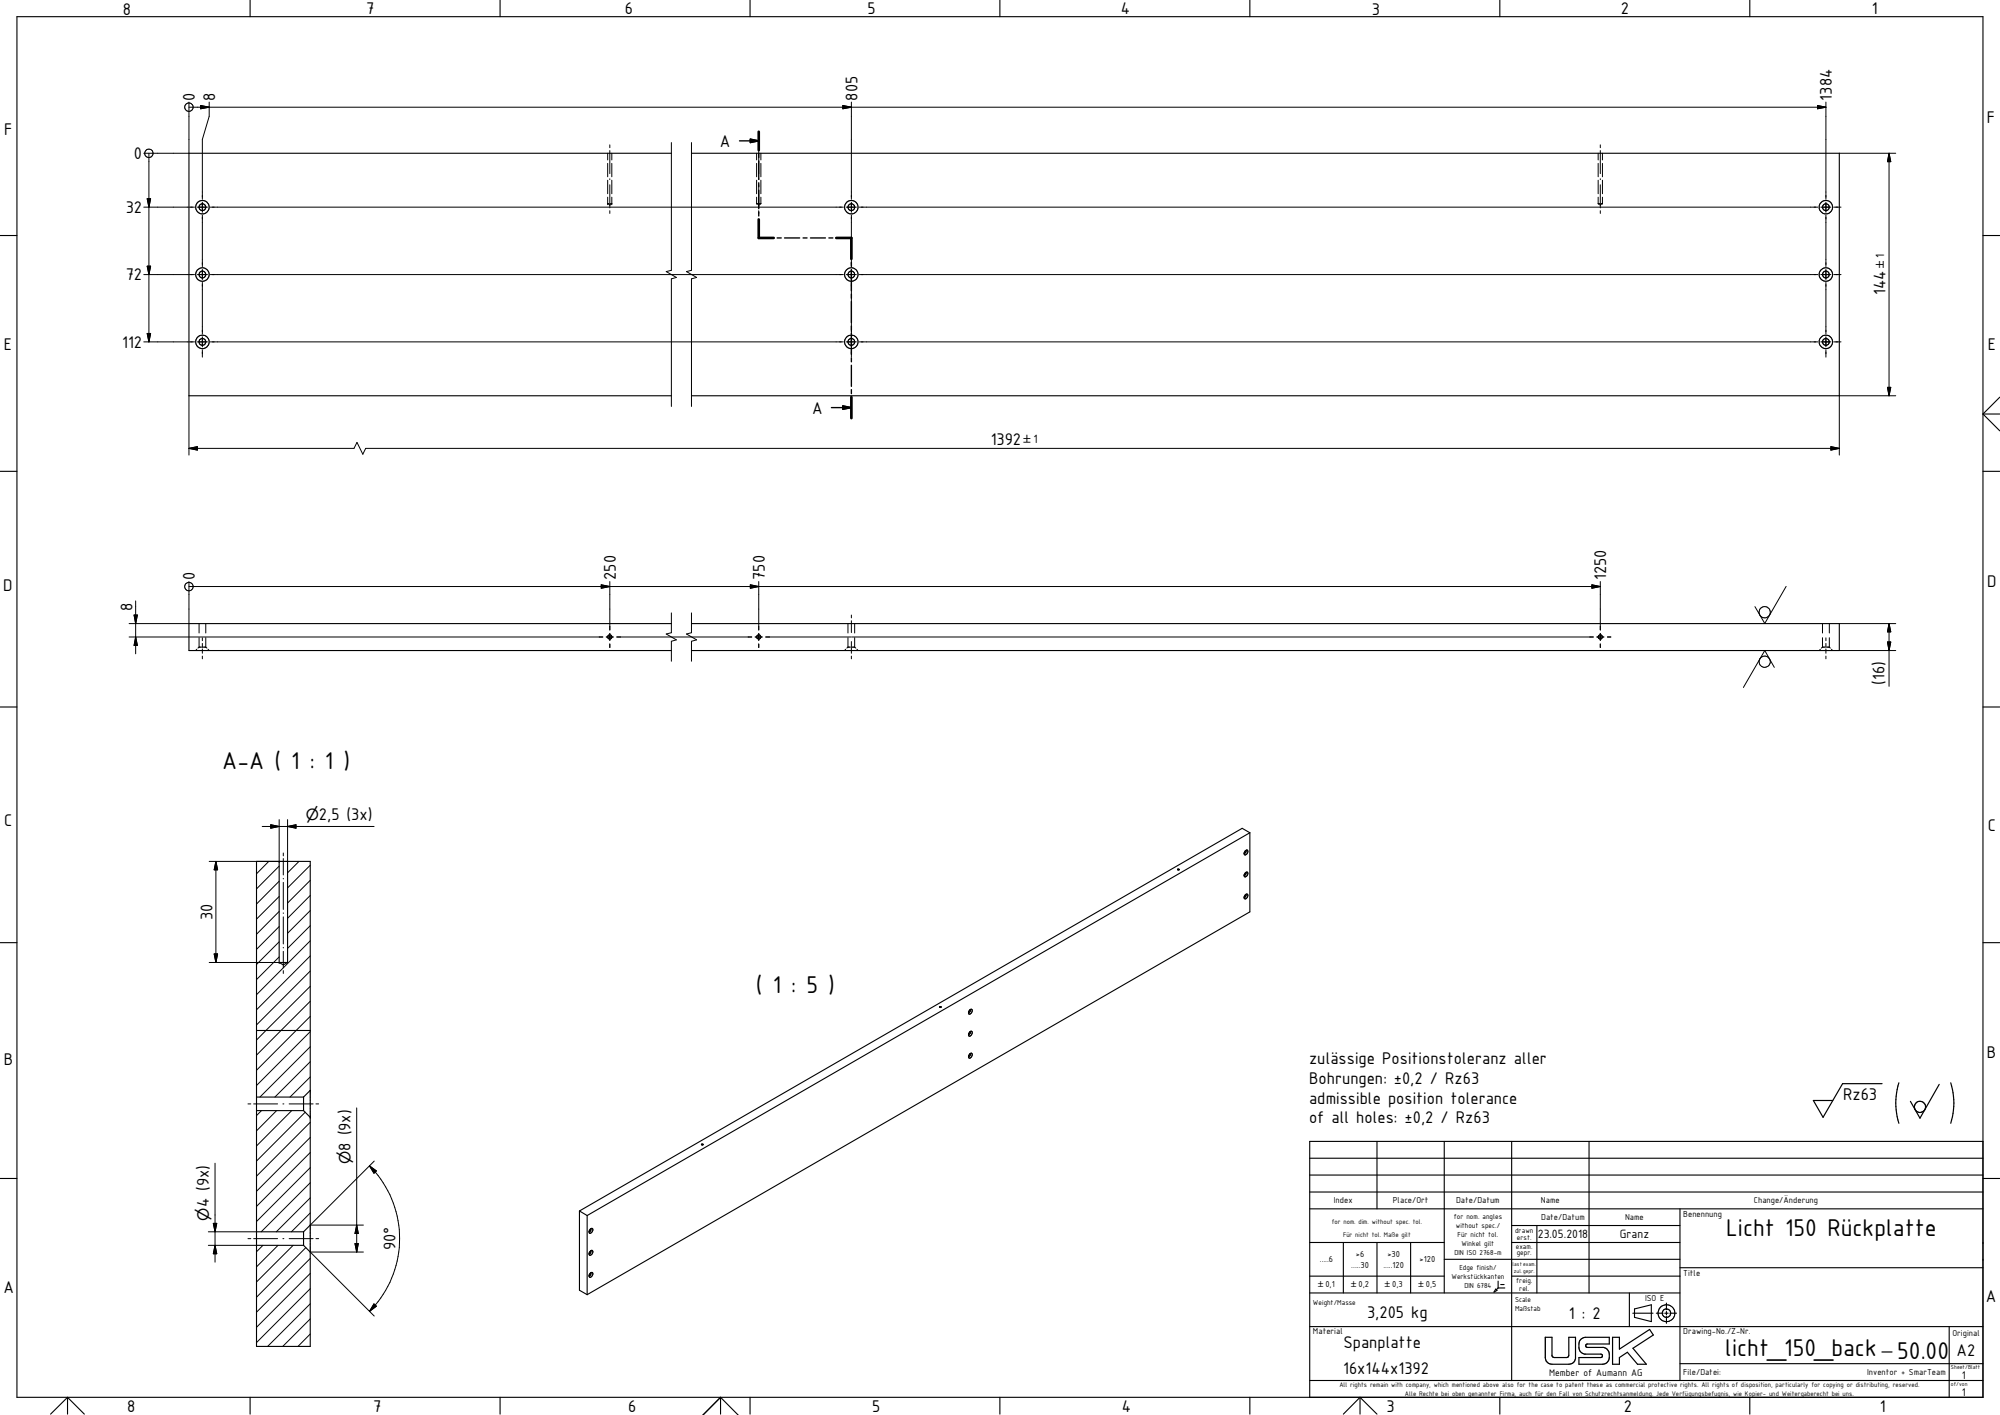
[picture p72: page 1]
File/Datei:; of/von; Sheet/Blatt; DIN 6784; Inventor + SmarTeam; rel.; Title; freig.

zulässige Positionstoleranz aller
Bohrungen: ±0,2 / Rz63
admissible position tolerance
of all holes: ±0,2 / Rz63

Index | Place/Ort | Date/Datum | Name | Change/Änderung
for nom. dim. without spec. tol. Für nicht tol. Maße gilt | for nom. angles without spec./ Für nicht tol. Winkel gilt DIN ISO 2768-m | Date/Datum | | Benennung Name Licht 150 Rückplatte

drawn erst. | 23.05.2018 | Granz

.....6 | >6 .....30 | >30 .....120 | >120 | | exam. gepr.

Edge finish/ Werkstückkanten | last exam. zul. gepr.

`0,2 Alle Rechte bei oben genannter Firma, auch für den Fall von Schutzrechtsanmeldung. Jede Verfügungsbefugnis, wie Kopier- und Weitergaberecht bei uns. `0,1 Weight/Masse Material 3,205 kg | Scale Maßstab 1 : 2 | ISO E

Spanplatte 16x144x1392 | | | Drawing-No./Z-Nr. licht_150_back 50.00 | Original A2

Member of Aumann AG

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
