RoboSAX/cad_spielfeld/2018/Spielfeld/Zeichnungen/export/licht_150_side_left.idw.pdf

A-A

C-C

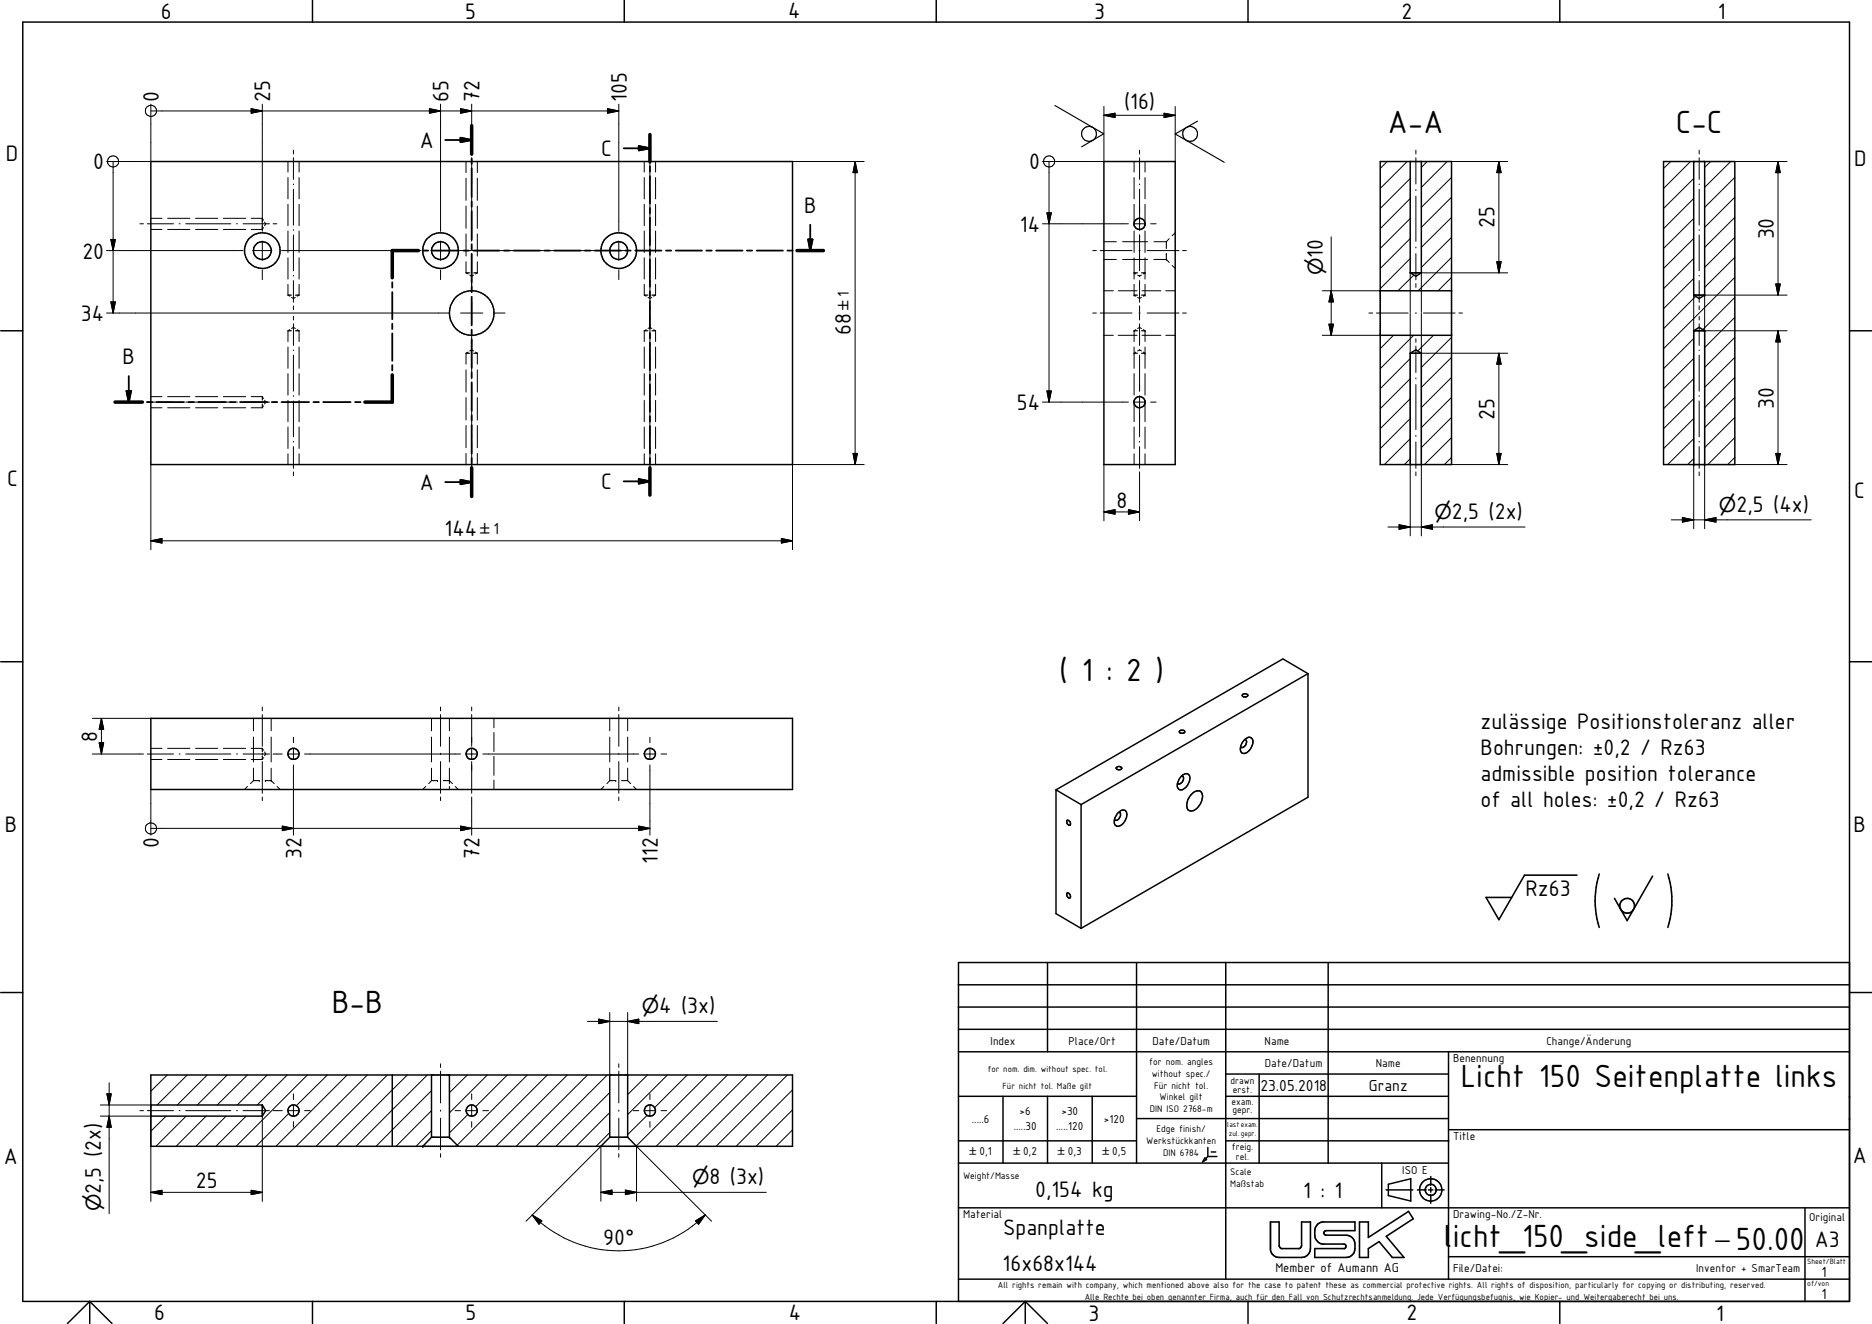
[picture p73: page 1]
last exam. zul. gepr.; Edge finish/ Werkstückkanten DIN 6784; rel.; licht_150_side_left 50.00; Title; freig.

zulässige Positionstoleranz aller
Bohrungen: ±0,2 / Rz63
admissible position tolerance
of all holes: ±0,2 / Rz63

Index | Place/Ort | Date/Datum | Name | Change/Änderung
for nom. dim. without spec. tol. Für nicht tol. Maße gilt | for nom. angles without spec./ Für nicht tol. Winkel gilt DIN ISO 2768-m | Date/Datum | | Benennung Name Licht 150 Seitenplatte links

drawn erst. | 23.05.2018 | Granz

.....6 | >6 .....30 | >30 .....120 | >120 | | exam. gepr.

`0,2 Alle Rechte bei oben genannter Firma, auch für den Fall von Schutzrechtsanmeldung. Jede Verfügungsbefugnis, wie Kopier- und Weitergaberecht bei uns. `0,1 Weight/Masse Material 0,154 kg | Scale Maßstab 1 : 1 | ISO E

Spanplatte 16x68x144 | | | Drawing-No./Z-Nr. | Original A3

Member of Aumann AG

File/Datei: Inventor + SmarTeam | Sheet/Blatt 1

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
