RoboSAX/cad_spielfeld/2018/Spielfeld/Zeichnungen/export/licht_150_support_right.idw.pdf

# A-A B-B

D

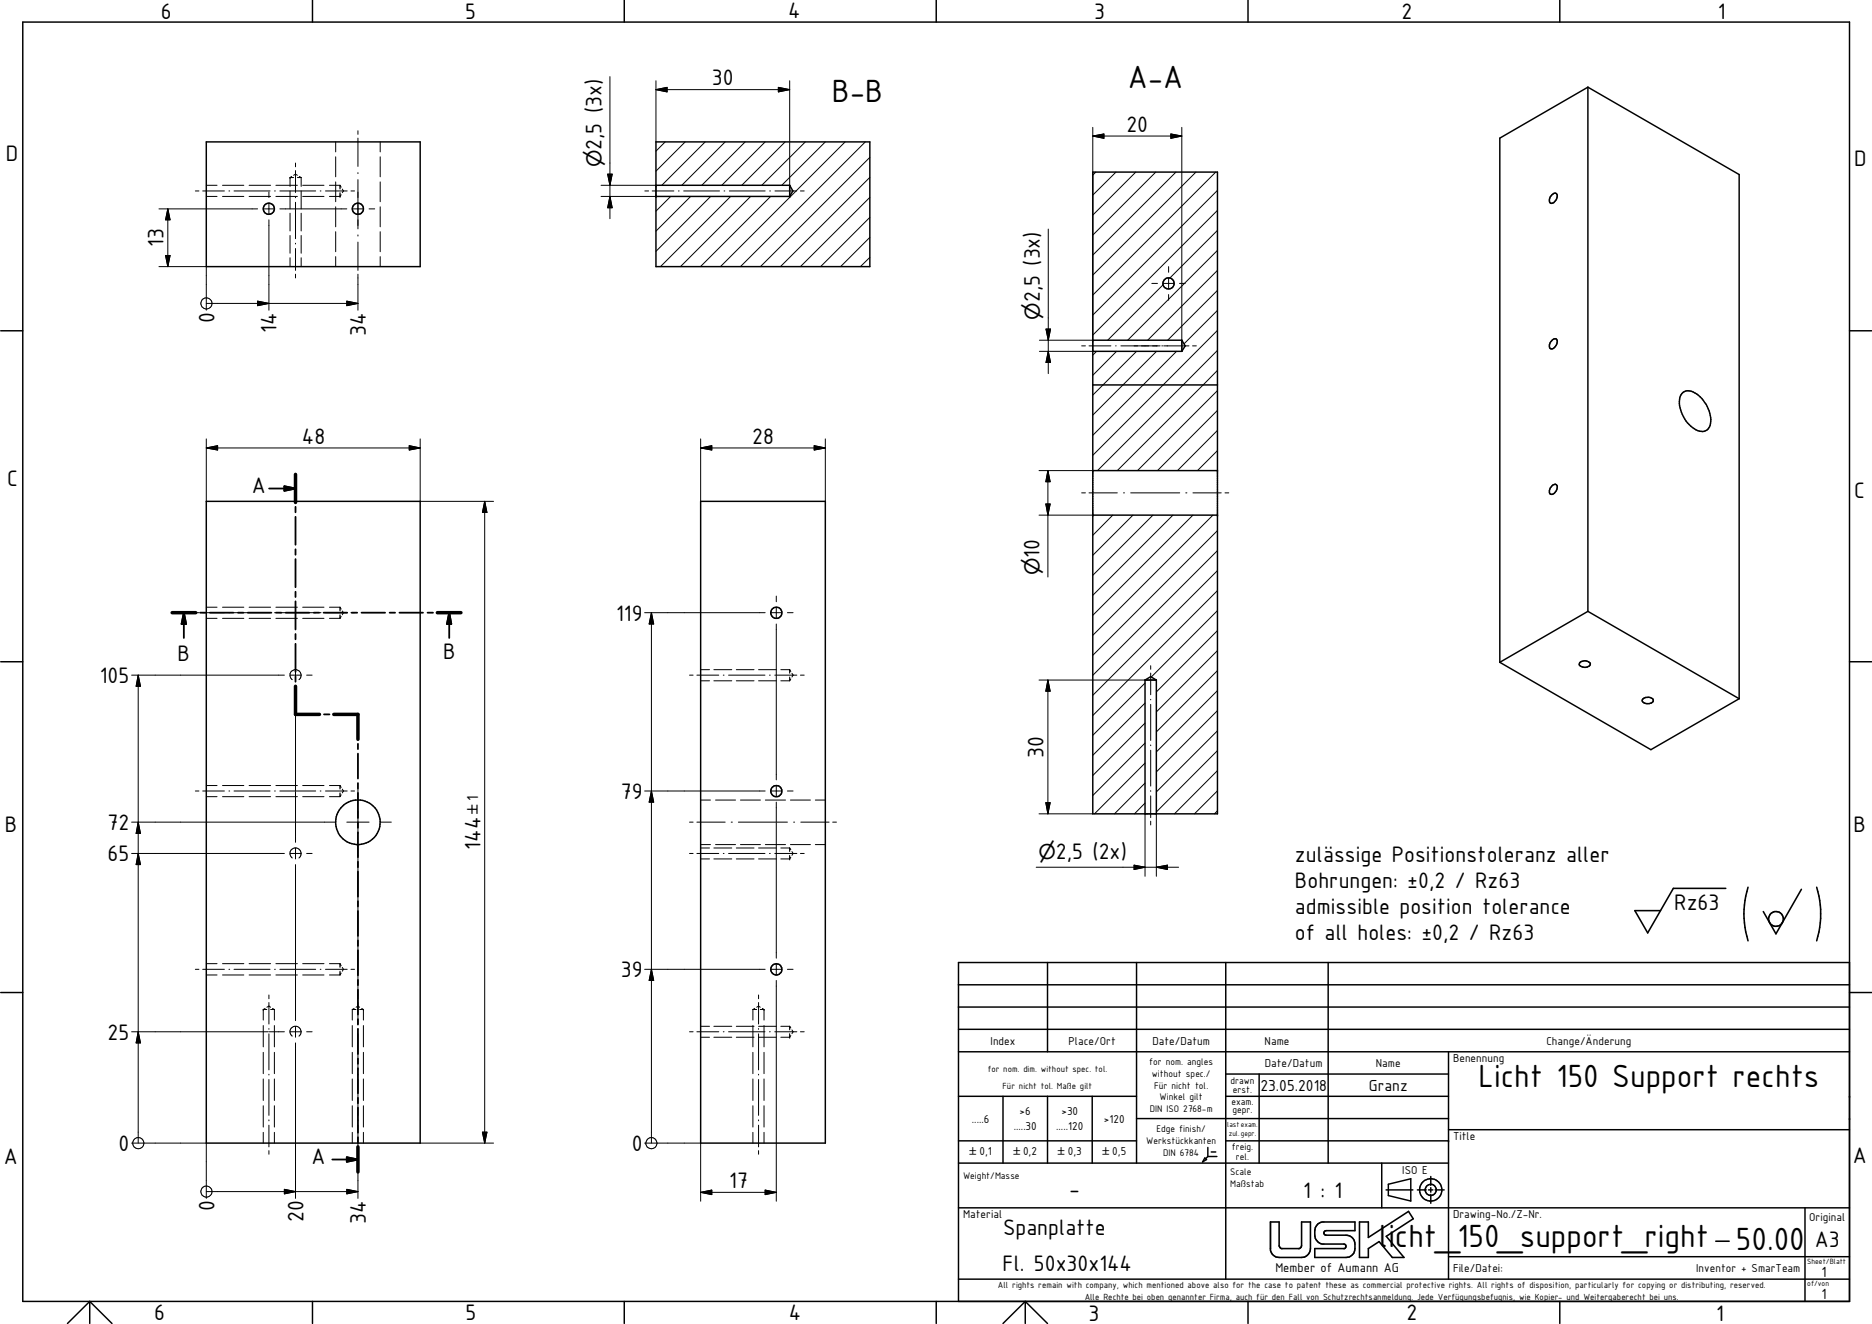
[picture p74: page 1]
DIN 6784; rel.; licht_150_support_right 50.00; Title; freig.

zulässige Positionstoleranz aller
Bohrungen: ±0,2 / Rz63
admissible position tolerance
of all holes: ±0,2 / Rz63

Index | Place/Ort | Date/Datum | Name | Change/Änderung
for nom. dim. without spec. tol. Für nicht tol. Maße gilt | for nom. angles without spec./ Für nicht tol. Winkel gilt DIN ISO 2768-m | Date/Datum | | Benennung Name Licht 150 Support rechts

drawn erst. | 23.05.2018 | Granz

.....6 | | | | | exam. gepr.

Edge finish/ Werkstückkanten | last exam. zul. gepr.

Weight/Masse | Scale Maßstab 1 : 1 | ISO E

Material Spanplatte Fl. 50x30x144 | | | Drawing-No./Z-Nr. | Original A3

Member of Aumann AG

File/Datei: Inventor + SmarTeam | Sheet/Blatt 1

All rights remain with company, which mentioned above also for the case to patent these as commercial protective rights. All rights of disposition, particularly for copying or distributing, reserved. Alle Rechte bei oben genannter Firma, auch für den Fall von Schutzrechtsanmeldung. Jede Verfügungsbefugnis, wie Kopier- und Weitergaberecht bei uns. | | | | of/von 1
