RoboSAX/cad_spielfeld/2018/Spielfeld/Zeichnungen/export/licht_200_top_teil_b.idw.pdf

D | D
6 | 5 | 4 | 3 | 2 | 1

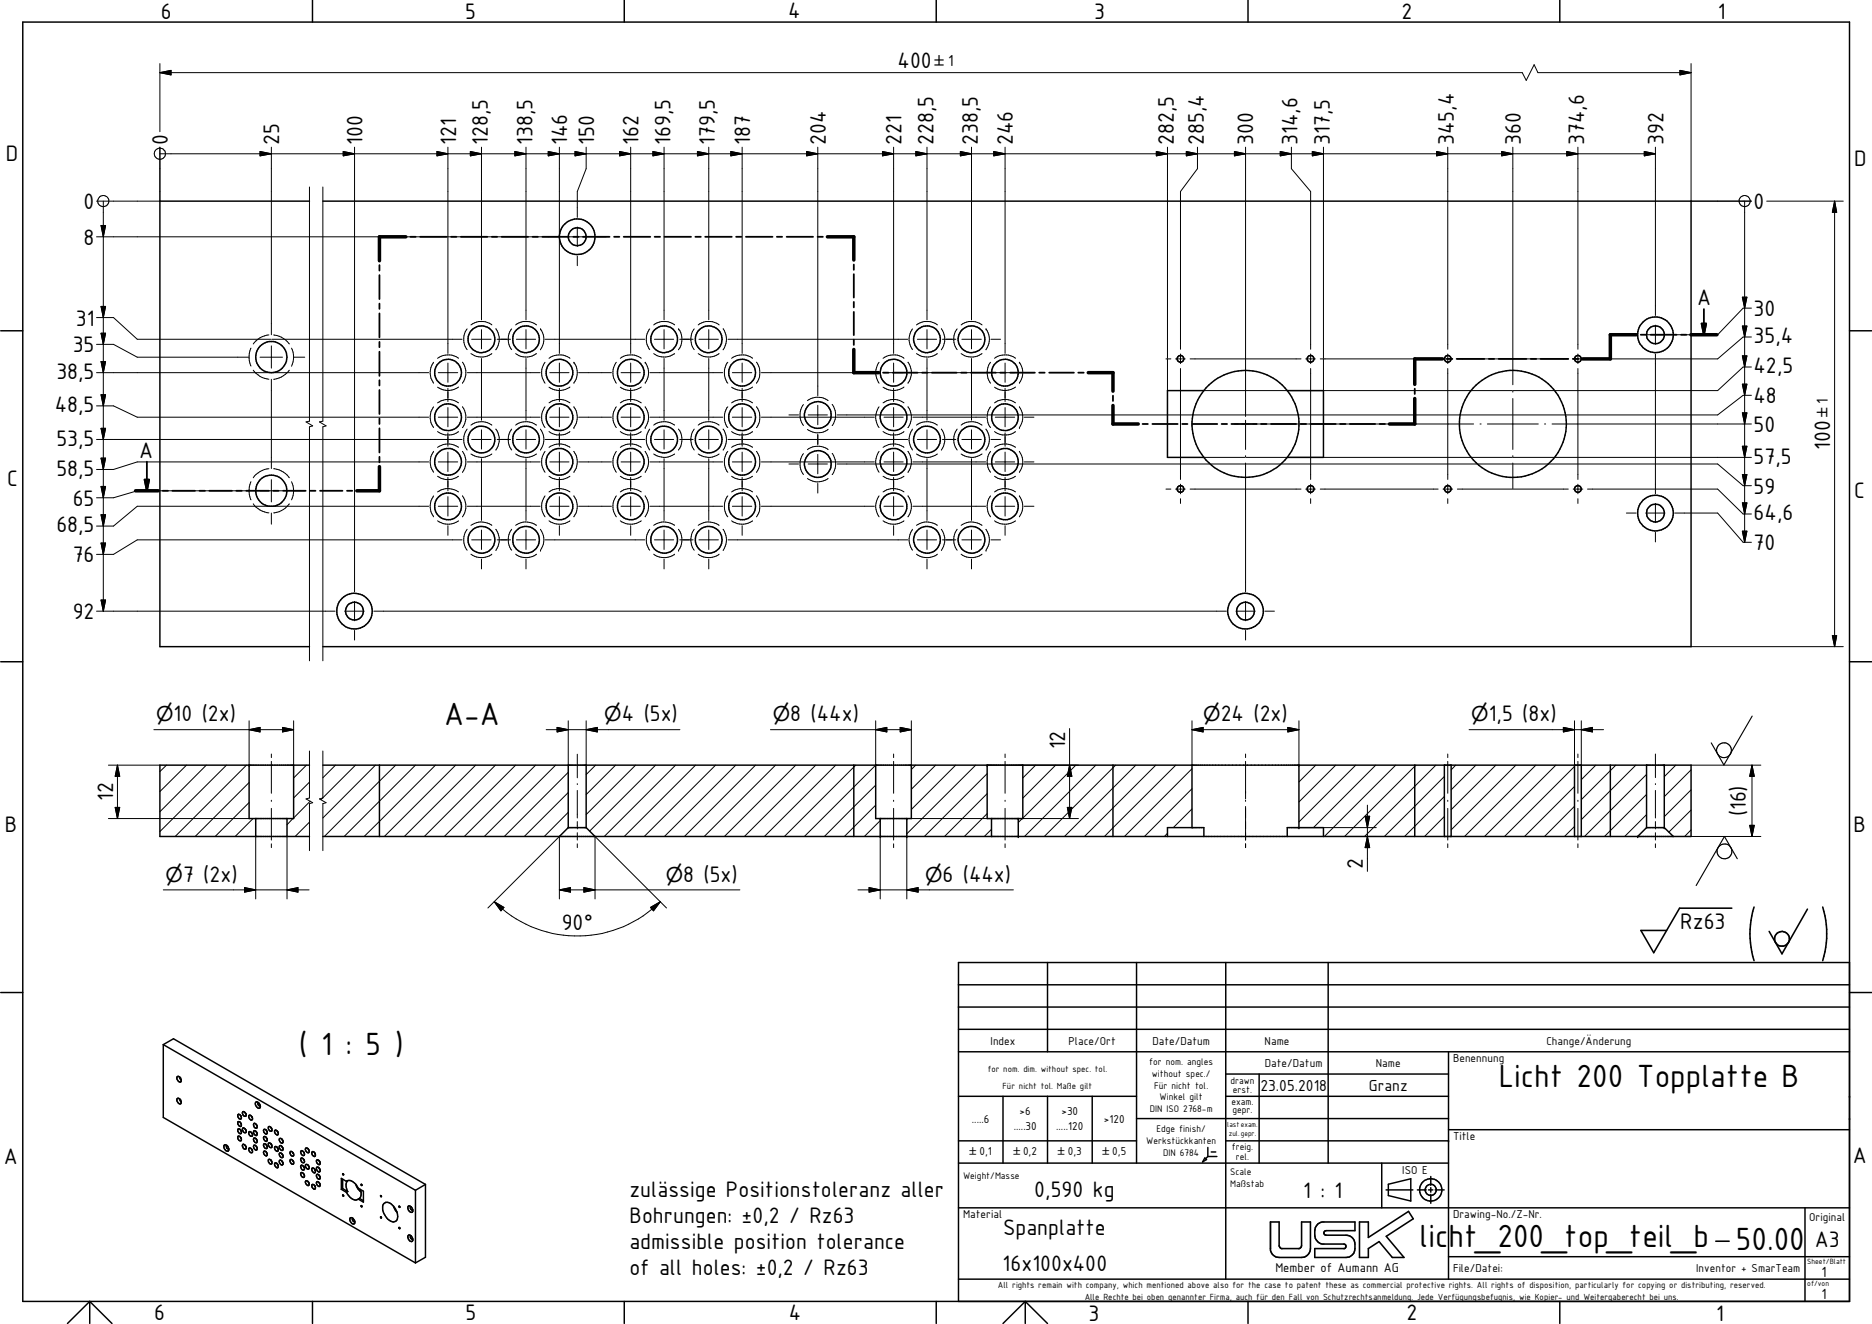
[picture p75: page 1]
File/Datei:; Scale Maßstab; erst.; last exam. zul. gepr.; gepr.; Place/Ort; ISO E; Benennung Name; Original; of/von; Sheet/Blatt; Inventor + SmarTeam; Date/Datum; Name; Change/Änderung; rel.; Index; Licht 200 Topplatte B; licht_200_top_teil_b 50.00; Granz; Title; exam.; drawn; freig.

for nom. angles
without spec./
Für nicht tol.
Winkel gilt
DIN ISO 2768-m
Edge finish/
Werkstückkanten
DIN 6784

for nom. dim. without spec. tol.
Für nicht tol. Maße gilt

Alle Rechte bei oben genannter Firma, auch für den Fall von Schutzrechtsanmeldung. Jede Verfügungsbefugnis, wie Kopier- und Weitergaberecht bei uns. `0,1 Weight/Masse Material `0,2
Spanplatte

zulässige Positionstoleranz aller
Bohrungen: ±0,2 / Rz63
admissible position tolerance
of all holes: ±0,2 / Rz63

Drawing-No./Z-Nr.

Member of Aumann AG

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
