RoboSAX/cad_spielfeld/2018/Teamprobe/Bauanleitungen/Licht_Teamprobe.pdf

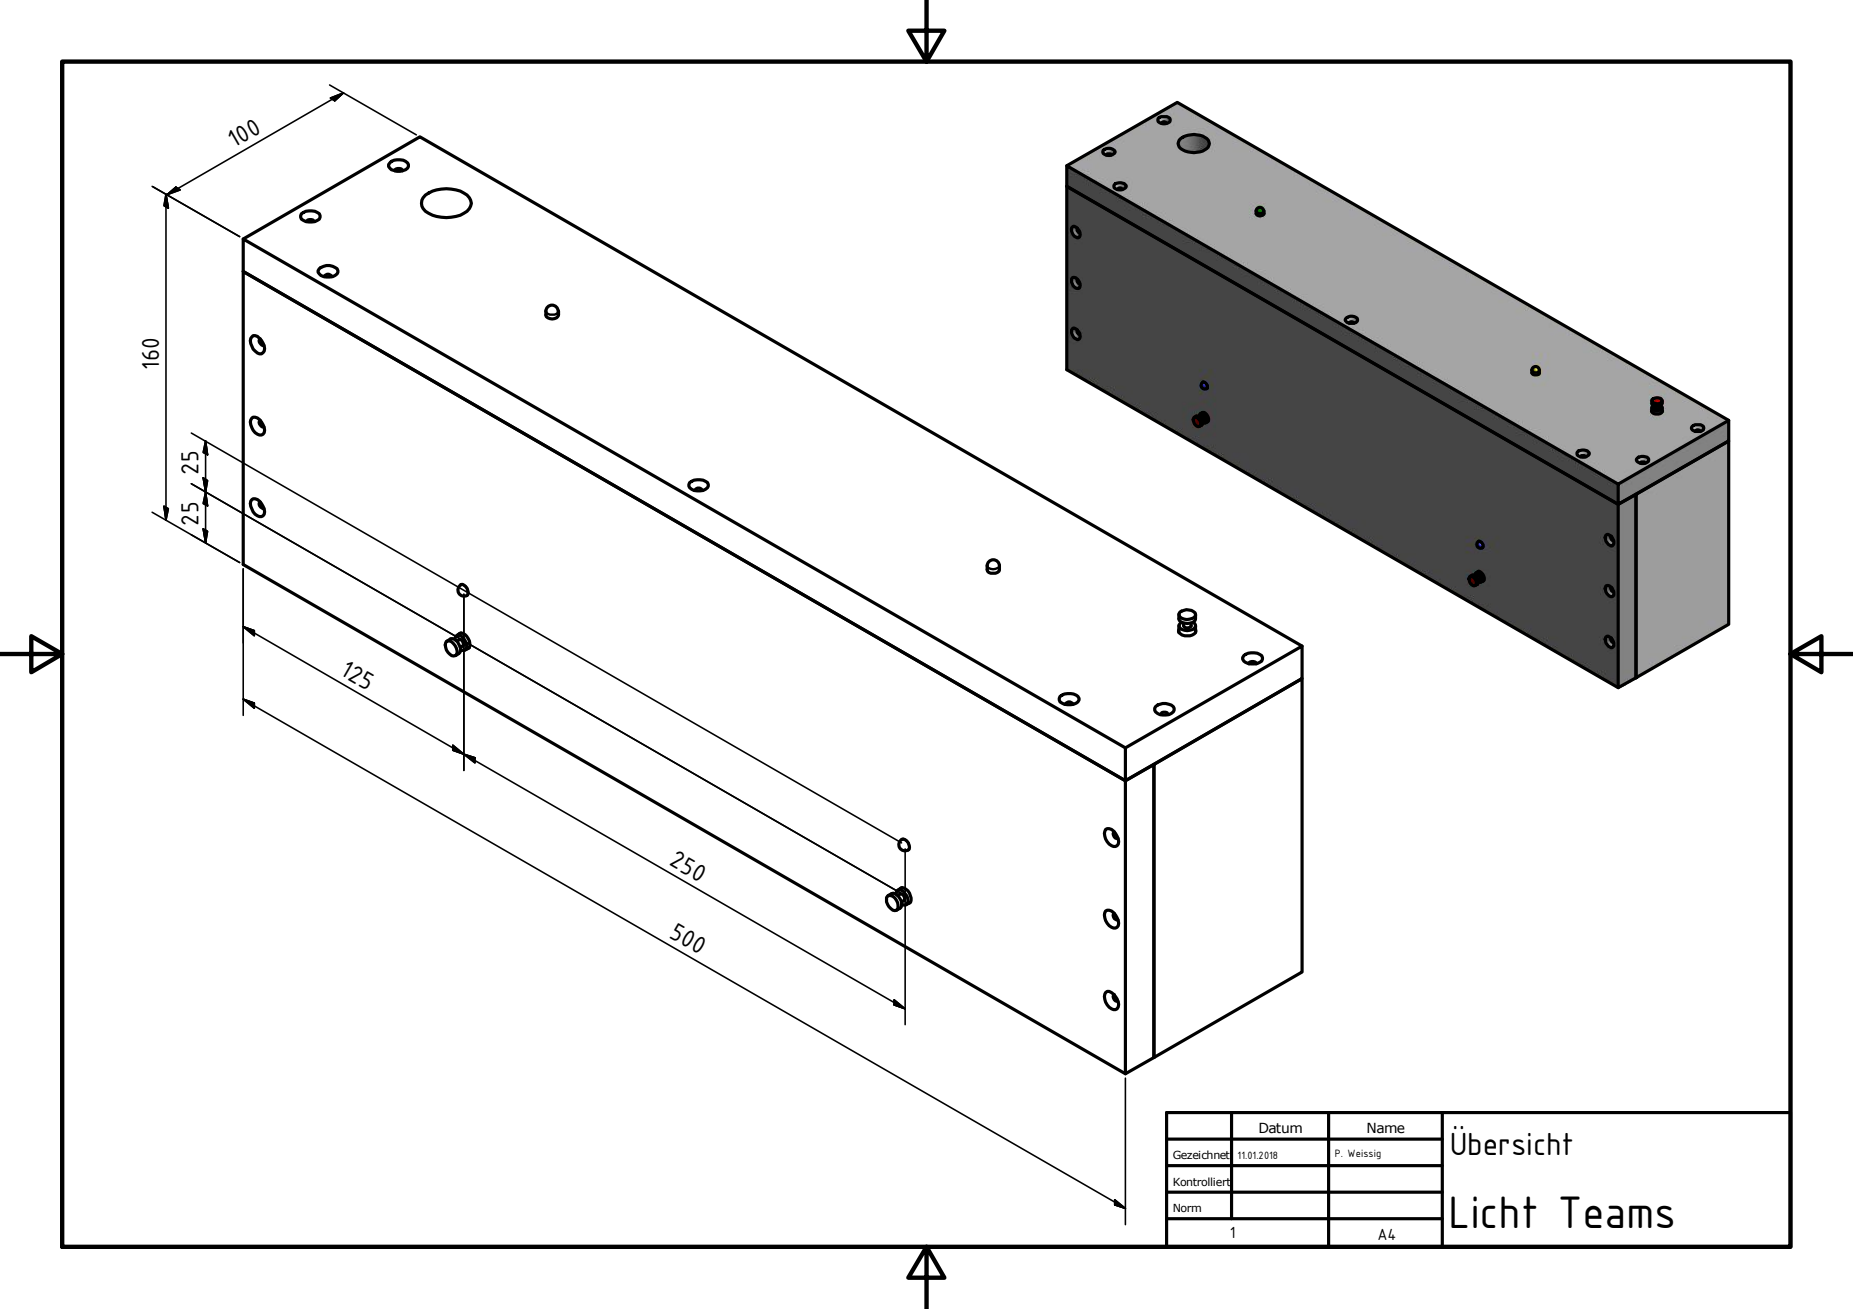
[picture p76: page 1]
Licht Teams

Datum | Name | bersicht

Gezeichnet | 11.01.2018 | P. Weissig

Kontrolliert

Norm

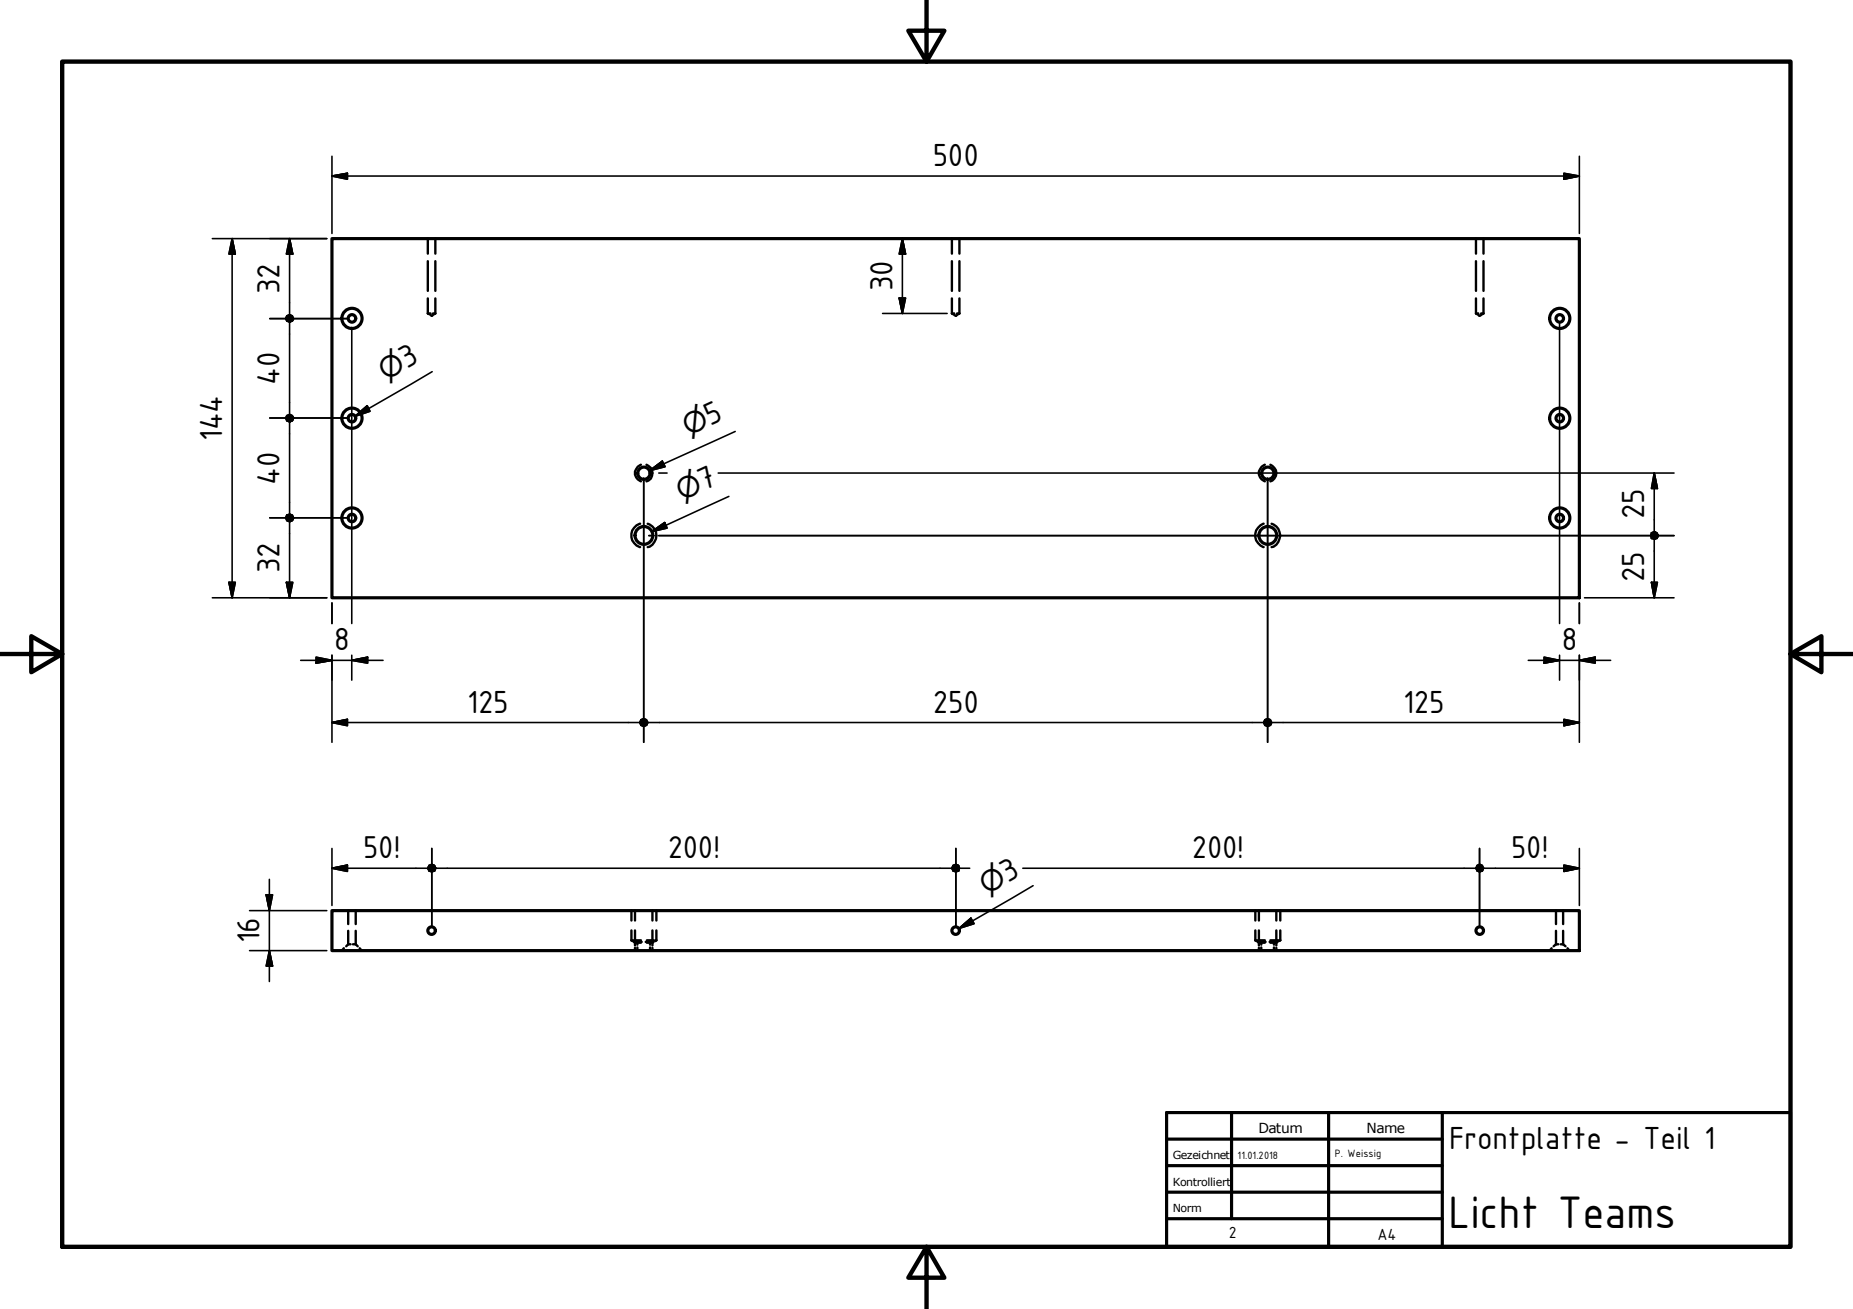
[picture p77: page 2]

Datum | Name | Frontplatte - Teil 1

Gezeichnet | 11.01.2018 | P. Weissig

Kontrolliert

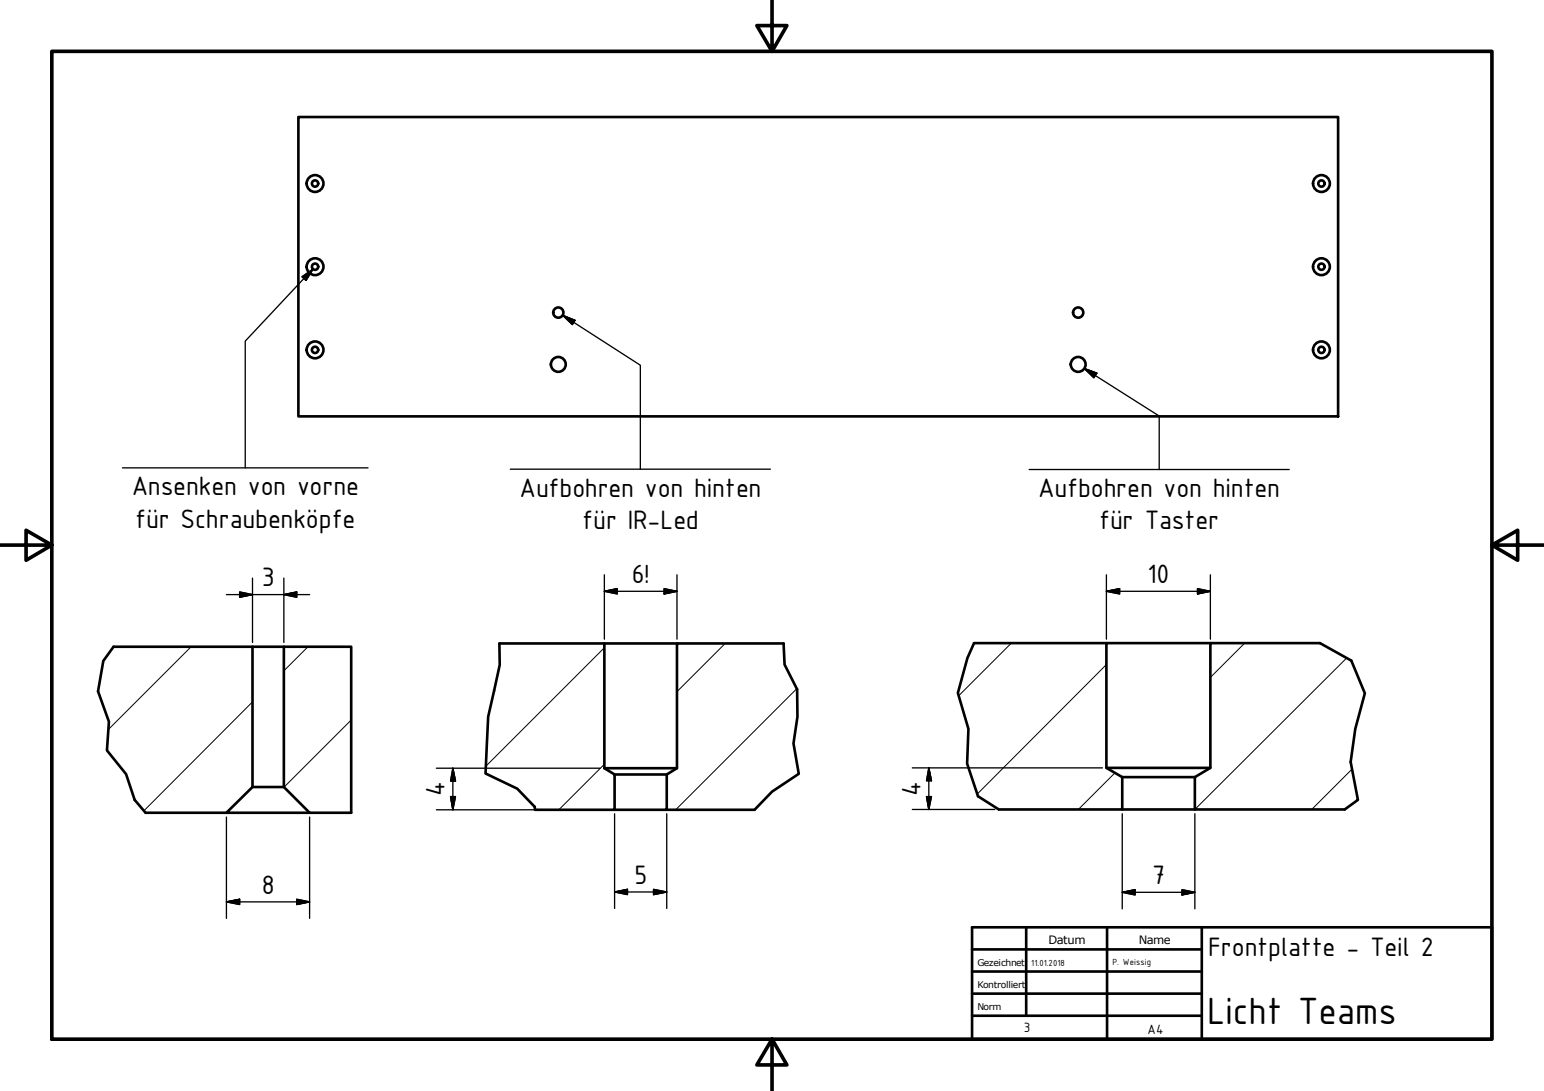
[picture p78: page 3]

Ansenken von vorne
f¯r Schraubenk©pfe

Aufbohren von hinten
f¯r IR-Led

f¯r Taster

Datum | Name | Frontplatte - Teil 2

Gezeichnet | 11.01.2018 | P. Weissig

Kontrolliert

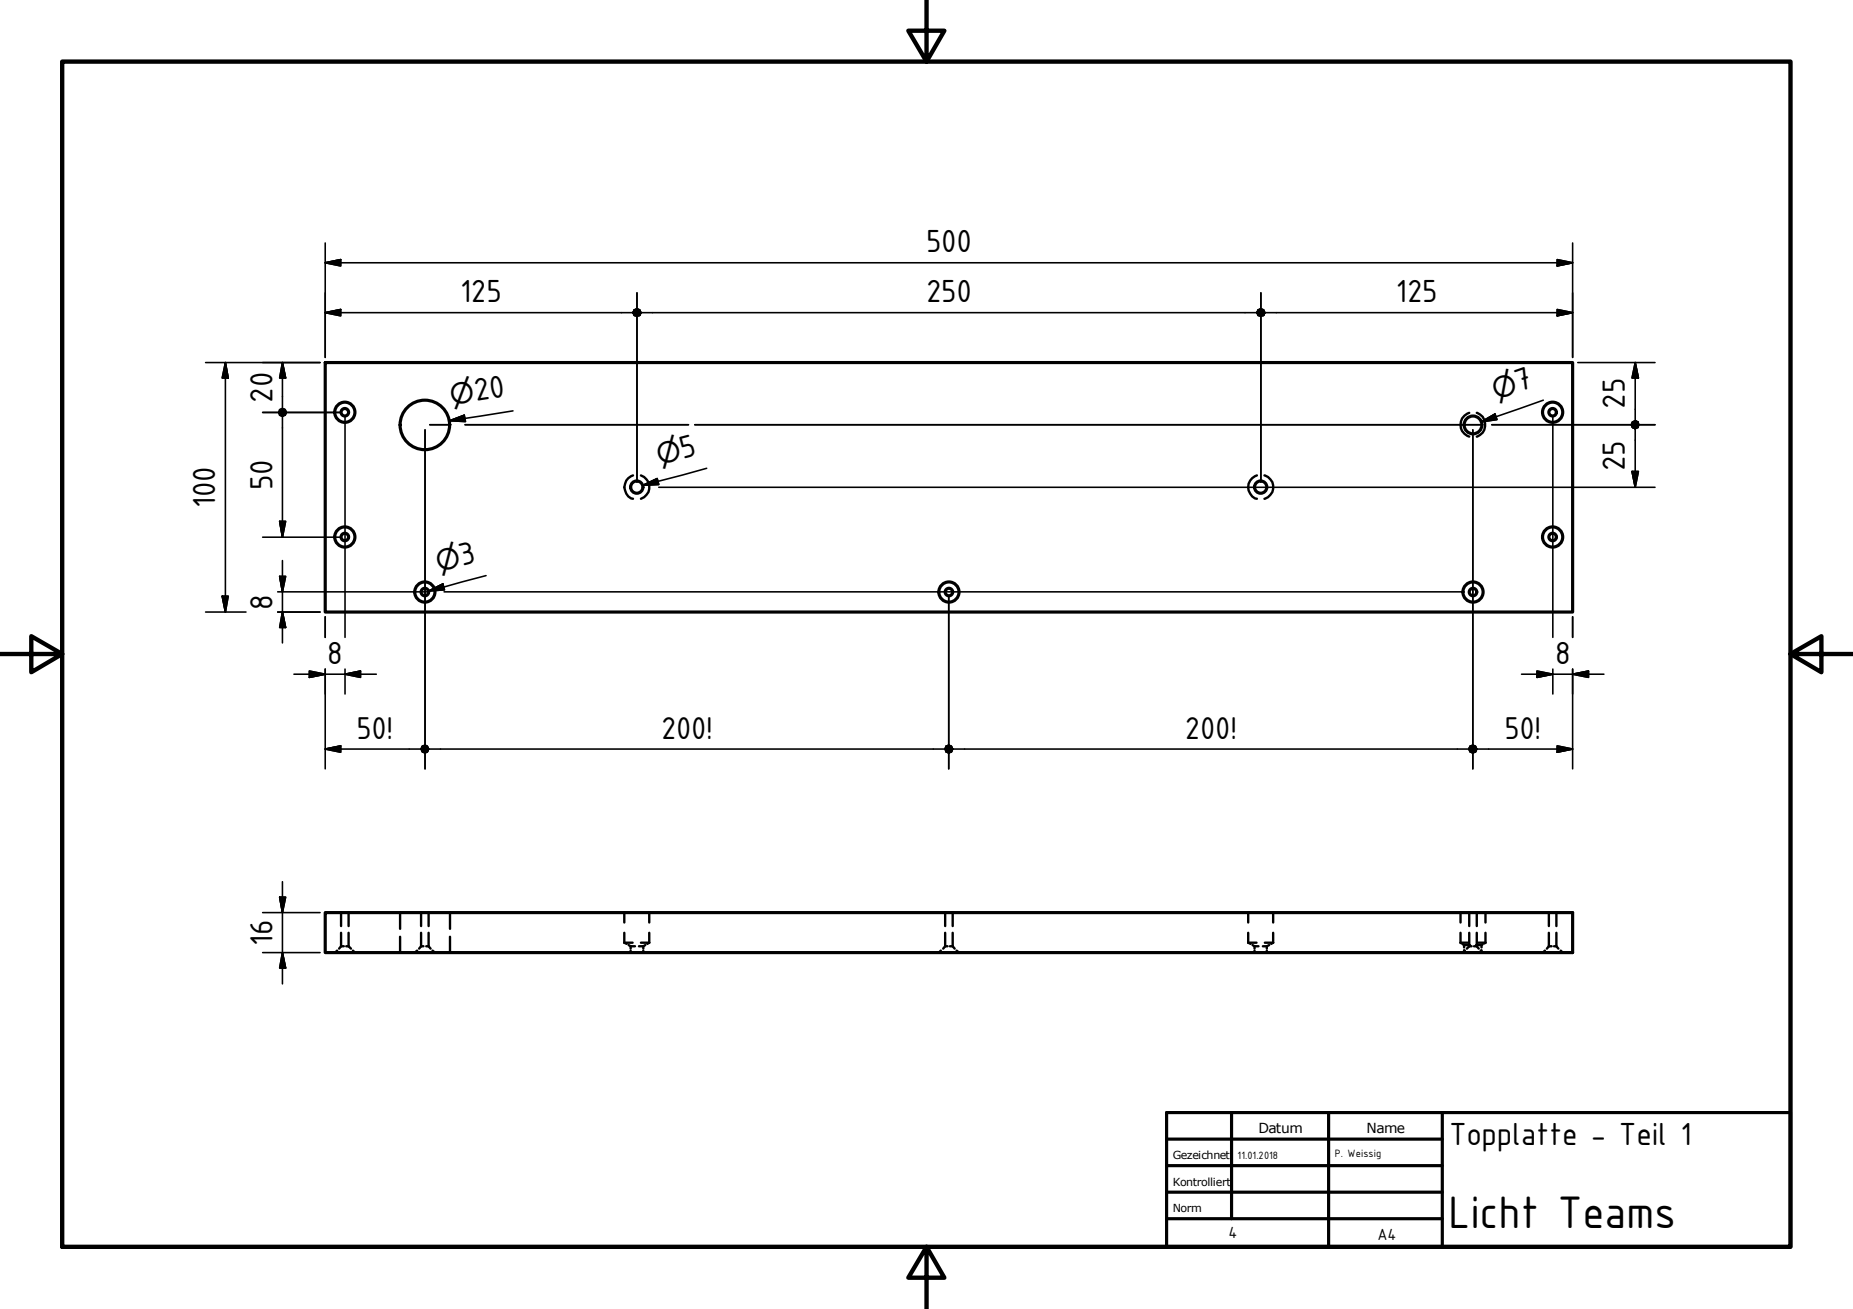
[picture p79: page 4]

Datum | Name | Topplatte - Teil 1

Gezeichnet | 11.01.2018 | P. Weissig

Kontrolliert

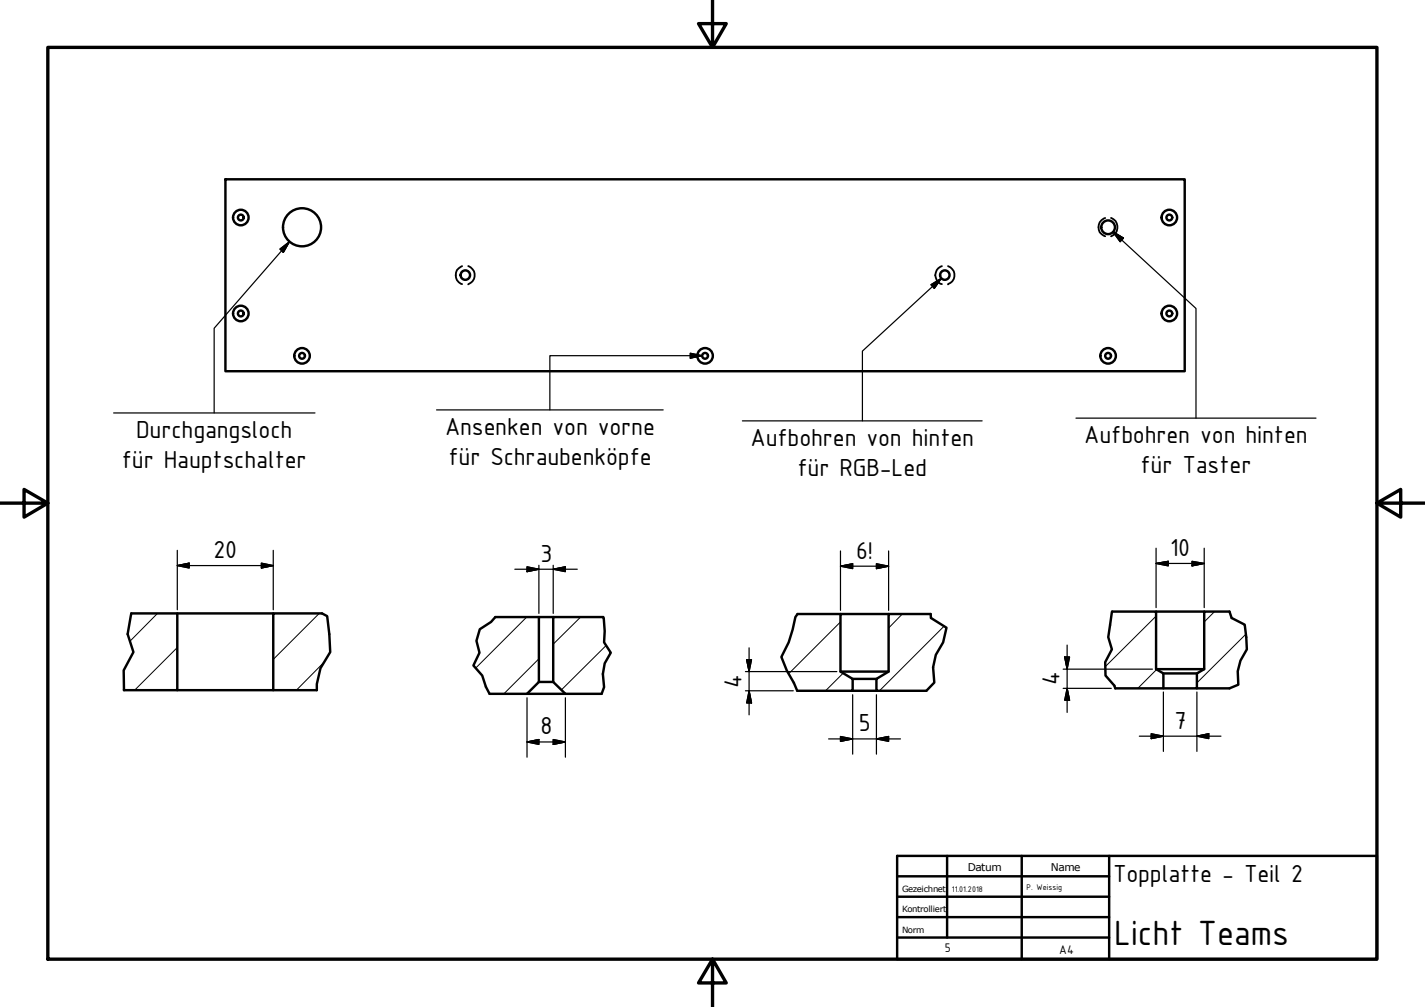
[picture p80: page 5]
Durchgangsloch f¯r Hauptschalter

Ansenken von vorne
f¯r Schraubenk©pfe

Aufbohren von hinten
f¯r Taster

f¯r RGB-Led

Datum | Name | Topplatte - Teil 2

Gezeichnet | 11.01.2018 | P. Weissig

Kontrolliert

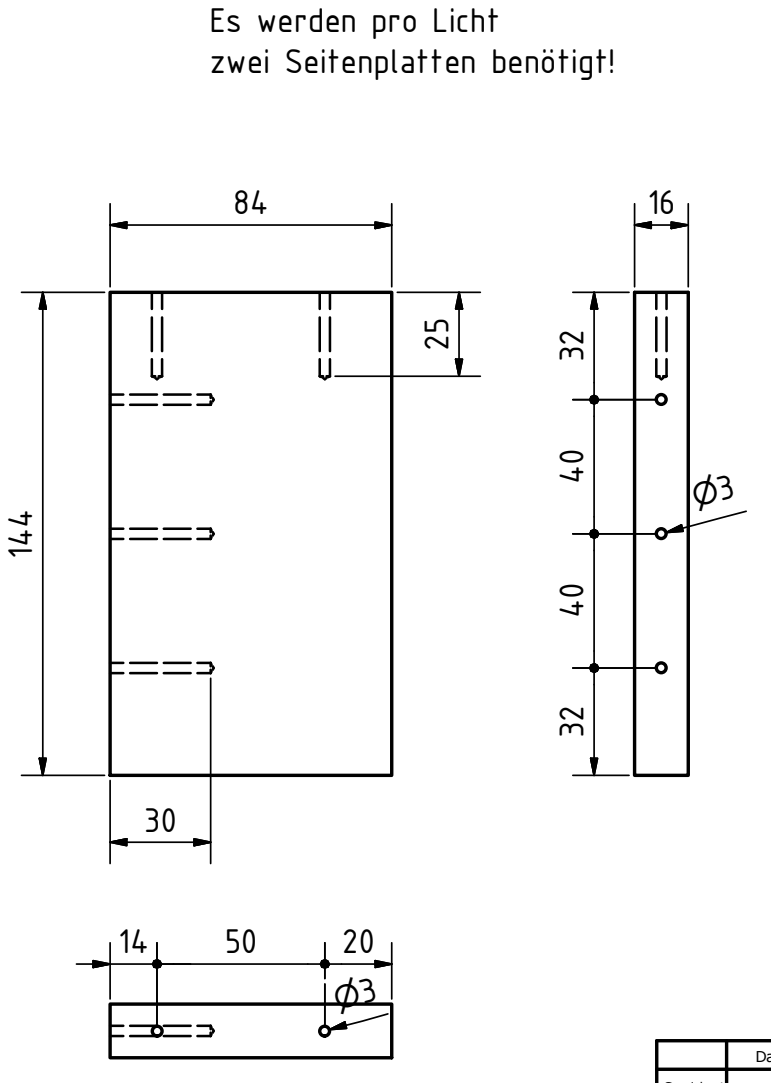
[picture p81: page 6]

Es werden pro Licht
zwei Seitenplatten ben©tigt!

Datum | Name | Seitenplatten

Gezeichnet | 11.01.2018 | P. Weissig

Kontrolliert
