RoboSAX/cad_spielfeld/2018/Spielfeld/Bauanleitungen/Hardware/Spielfeld_gesamt.pdf

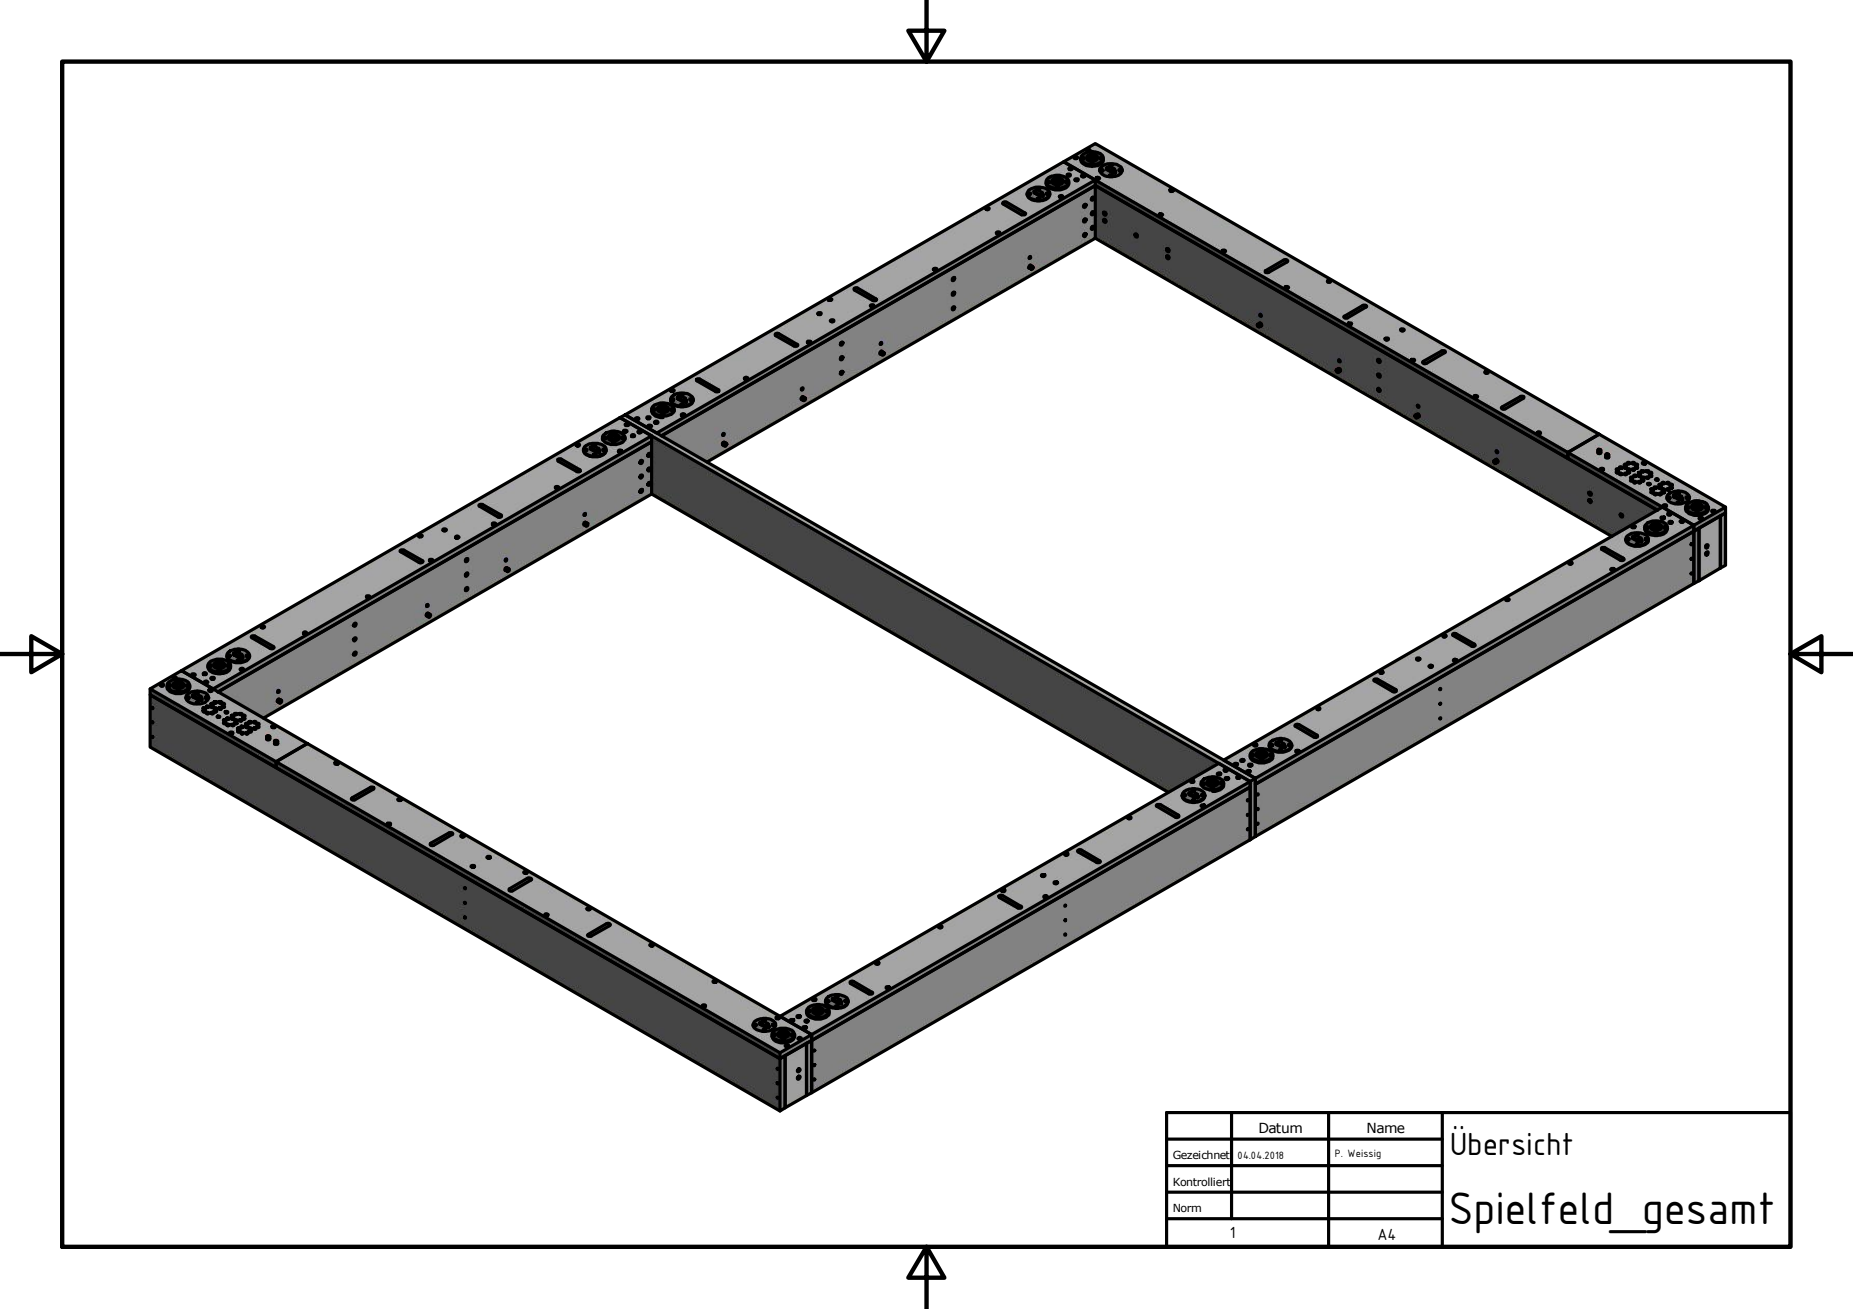
[picture p82: page 1]
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

G e z e i c h n e t | 0 4.0 4.2 0 1 8 | P. W eis sig

K o n t r olli e rt

3000

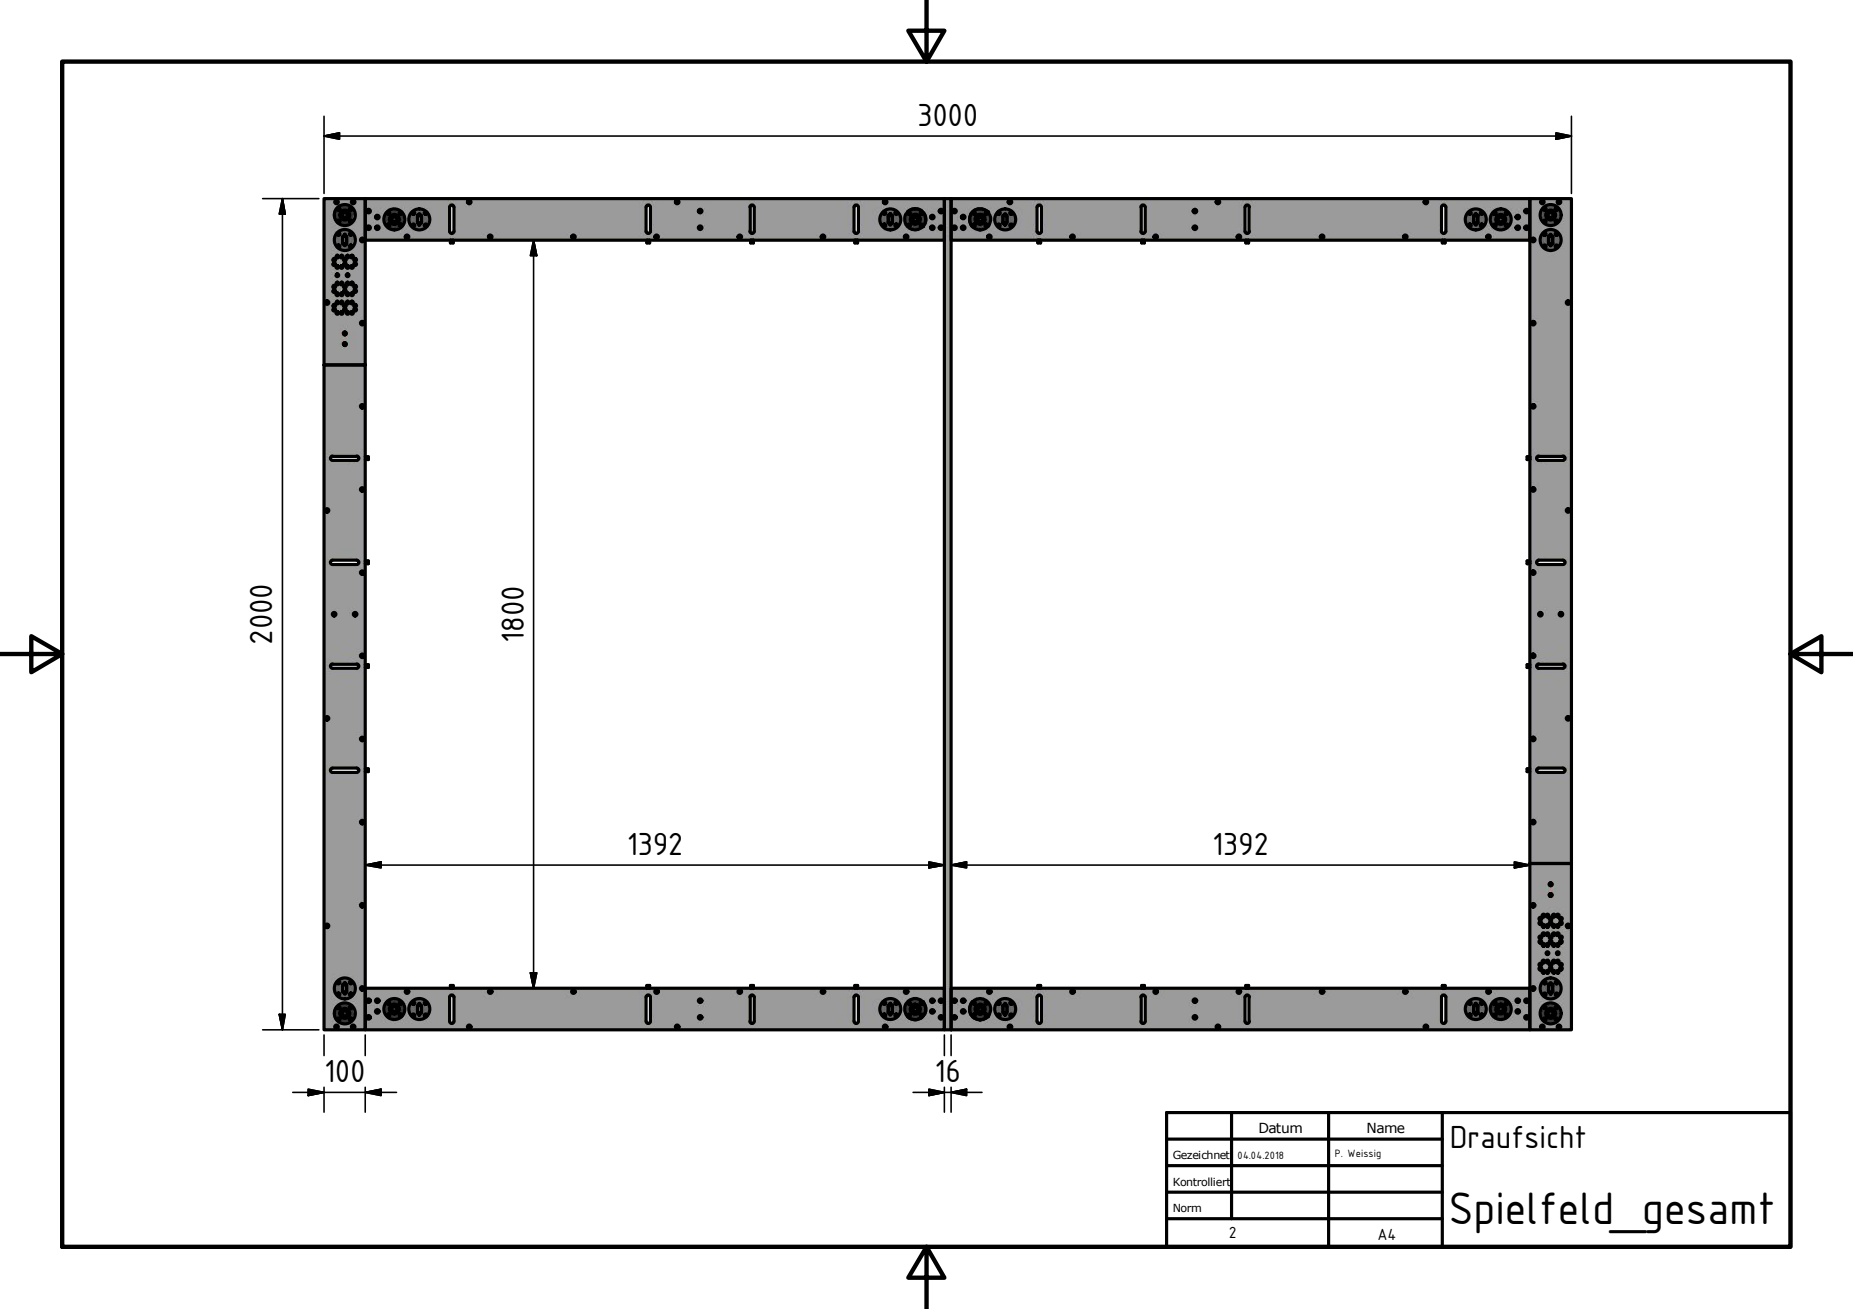
[picture p83: page 2]

Datum | Name | Draufsicht Spielfeld_gesamt

Gezeichnet | 04.04.2018 | P. Weissig

Kontrolliert

Norm

1900

1960

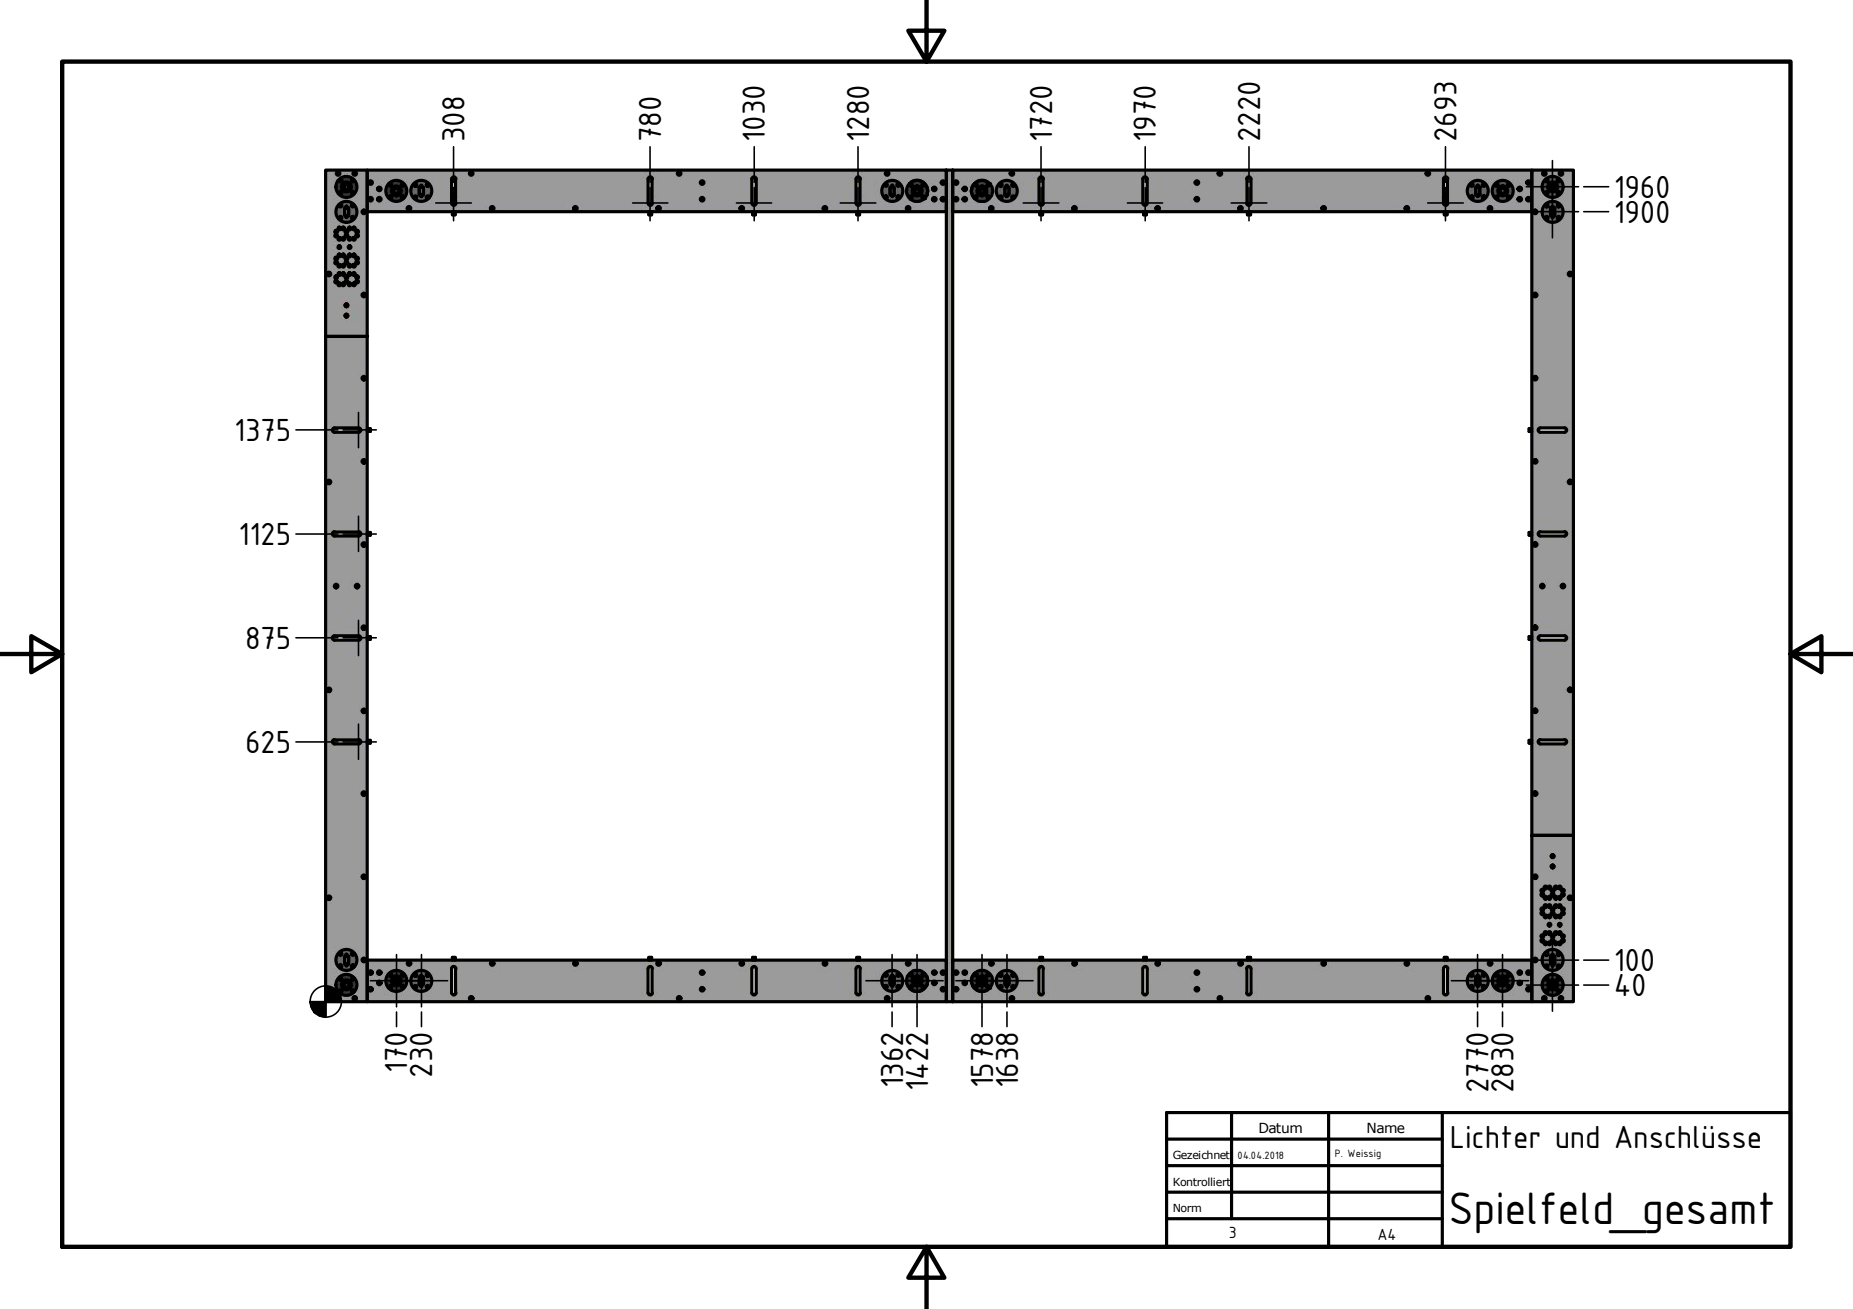
[picture p84: page 3]

Datum | Name | Lichter und Anschl¯sse Spielfeld_gesamt

Gezeichnet | 04.04.2018 | P. Weissig

Kontrolliert

Norm
