RoboSAX/cad_spielfeld/2018/Spielfeld/Zeichnungen/export/licht_150.idw.pdf

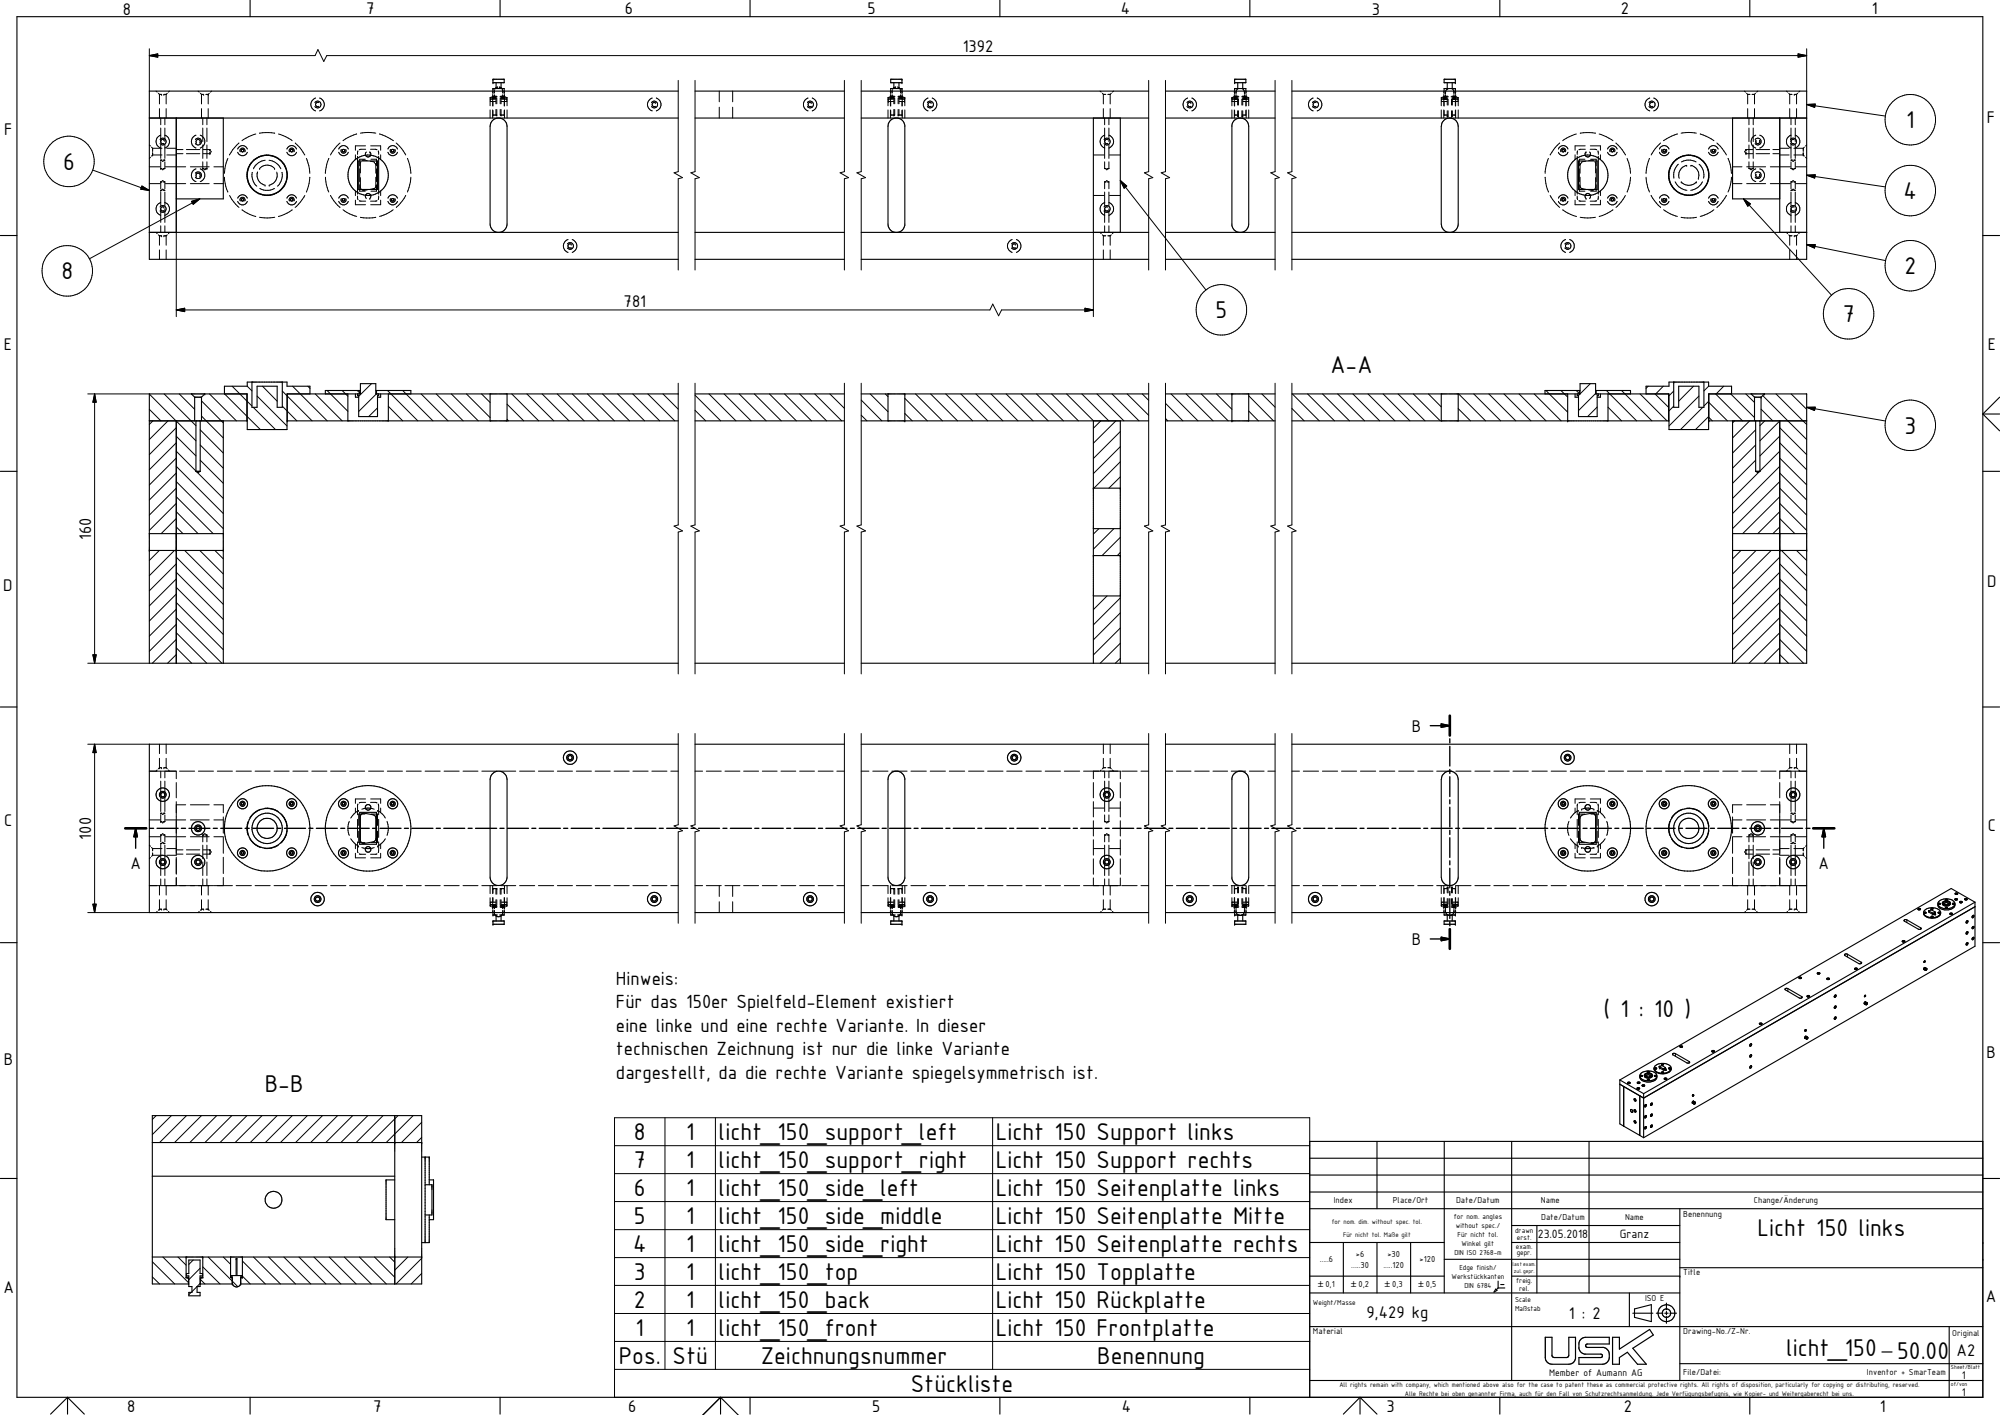
[picture p85: page 1]
File/Datei:; Scale Maßstab; erst.; last exam. zul. gepr.; gepr.; Place/Ort; ISO E; Benennung Name; Original; of/von; Sheet/Blatt; Inventor + SmarTeam; Date/Datum; Name; Change/Änderung; rel.; Index; Licht 150 links; licht_150 50.00; Granz; Title; exam.; drawn; freig.; 1 licht_150_support_left; Licht 150 Support links; 1 licht_150_support_right Licht 150 Support rechts; 1 licht_150_side_left; Licht 150 Seitenplatte links; 1 licht_150_side_middle; Licht 150 Seitenplatte Mitte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

Hinweis:
Für das 150er Spielfeld-Element existiert
eine linke und eine rechte Variante. In dieser
technischen Zeichnung ist nur die linke Variante
dargestellt, da die rechte Variante spiegelsymmetrisch ist.

for nom. dim. without spec. tol.
Für nicht tol. Maße gilt

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

Drawing-No./Z-Nr.

Member of Aumann AG

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
