RoboSAX/cad_spielfeld/(commit log)

2018-04-04 added licht 150 (still in construction)
    [Licht_150.dwg, licht_150.iam, licht_150_back.ipt, licht_150_front.ipt, licht_150_side_left.ipt, licht_150_side_middle.ipt, licht_150_side_right.ipt, licht_150_support.ipt]
2018-04-05 updated Licht 150 (not done yet)
    [Licht_150.dwg, licht_150.iam, licht_150_side_left.ipt, licht_150_side_right.ipt, licht_150_support.ipt, licht_150_support_left.ipt, licht_150_support_right.ipt, licht_150_top_teil.ipt]
2018-04-08 added Lötanleitung Taster und IR-Led für Spielfeld 2018
2018-04-09 updated Zeichnungen Spielfeld 2018 + bugfixed Anschluss Daten + updated Licht 200 + finished Licht 150 + added Gesamt-Ansicht
    [Anschluss_Daten.dwg, Licht_150.dwg, Licht_150_links.dwg, Licht_200.dwg, Spielfeld_gesamt.dwg, anschluss_daten.iam, anschluss_daten_1.ipt, anschluss_daten_1_MIR.ipt]
2018-04-30 added Bestellliste Reichelt to Spielfeld 2018
    [Reichelt.ods]
2018-04-30 updated Bestellung Reichelt
    [Reichelt.ods]
2018-05-24 updated number of switches (missed 2 control-switches)
    [Reichelt.ods]
2018-05-24 updated structure of dirs and files also removed old drawings
    [Anschluss_Daten.dwg, Licht_150_links.dwg, Licht_200.dwg, Licht_Teamprobe.dwg, Reichelt.ods, Spielfeld_gesamt.dwg, anschluss_daten.iam, anschluss_daten.ipt]
2018-05-24 added new drawing
    [anschluss_daten.iam, anschluss_daten.idw, anschluss_daten.ipt, anschluss_daten_1.ipt, anschluss_daten_1_MIR.ipt, anschluss_daten_2.ipt, anschluss_daten_2_MIR.ipt, anschluss_daten_MIR.iam]
2018-05-29 updated Spielfeld 2018 + updated sketches and *.pdf
    [Steckwand.idw, Steckwand.ipt, anschluss_daten.iam, anschluss_daten_1.idw, anschluss_daten_1.ipt, anschluss_daten_2.ipt, anschluss_daten_2_MIR.ipt, anschluss_daten_MIR.iam]
2019-02-23 added Anschluss Programmer to 2019
    [anschluss_programmer.dwg, anschluss_programmer.idw, anschluss_programmer.ipt, anschluss_programmer.stp]
2019-02-24 updated Programmieranschluss
    [anschluss_programmer.dwg, anschluss_programmer.idw, anschluss_programmer.ipt, anschluss_programmer.stp]
2019-11-26 added Anschluss für Taster
    [anschluss_taster.dwg, anschluss_taster.idw, anschluss_taster.ipt, anschluss_taster.stp]
